tnagyzambo/adc-board/sim/fault/report.md

# GP channel 1: DC fault sweep

1451 cases; 0 did not finish (listed at the end). Generated by report.py from results.json.

## Absolute maximum ratings exceeded

### +28 V, limited to 5 A (a low-impedance source; OI-5)

| Part | Limit | Worst | From | Contacts | Power | Configurations | Sensors | Cases | Worst case |
|---|---|---|---|---|---|---|---|---|---|
| Q3 (S4): body diode current | ≤ 200 mA | 3.16 A | +1 V | EXC-, SIG+, SIG- | ch_off, no24, on, stack_off | i420, i420+S11, lc, lc+S11, lc_cal, lc_cal+S11, off, off+S11, prt, prt+S11, prt_cal, prt_cal+S11, volt, volt+S11 | lc350, none, prt3k5, tx420, txv | 82 | ch_off, off, txv, EXC- +28 V 5A |
| Q3 (S4): dissipation | ±200 mW | 12 W | +1 V | EXC-, SIG+, SIG- | ch_off, no24, on, stack_off | i420, i420+S11, lc, lc+S11, lc_cal, lc_cal+S11, off, off+S11, prt, prt+S11, prt_cal, prt_cal+S11, volt, volt+S11 | lc350, none, prt3k5, tx420, txv | 83 | ch_off, off, txv, EXC- +28 V 5A |
| R3 (shunt): dissipation | ≤ 1 W | 7.4 W | +4 V | SIG+ | no24, on | i420, i420+S11 | tx420 | 3 | on, i420, tx420, SIG+ +28 V 5A |
| U58 (S11): output current | ±400 mA | -5 A | +1 V | SHLD | on | i420+S11, lc+S11, lc_cal+S11, off+S11, prt+S11, prt_cal+S11, volt+S11 | lc350, none, prt3k5, tx420, txv | 17 | on, off, S11 closed, lc350, SHLD +28 V 5A |

### -28 V, limited to 30 mA (beyond REQ-15)

| Part | Limit | Worst | From | Contacts | Power | Configurations | Sensors | Cases | Worst case |
|---|---|---|---|---|---|---|---|---|---|
| Q24: source to drain | ≤ 50 V | 51 V | -28 V | EXC+ | ch_off | off | none, prt3k5, tx420, txv | 4 | ch_off, off, none, EXC+ -28 V 30mA |
| R21: dissipation | ≤ 63 mW | 81.6 mW | -25 V | EXC+ | ch_off, no24, stack_off | i420, off, volt | none, prt3k5, tx420, txv | 12 | no24, volt, none, EXC+ -28 V 30mA |
| U10 (+/-2.5 V LDO): INP | -0.3 V to 36 V | -0.706 V | -3 V | EXC+, EXC-, SIG+, SIG- | ch_off, stack_off | off | lc350, none, prt3k5, tx420, txv | 34 | stack_off, off, none, EXC- -28 V 30mA |
| U10 (+/-2.5 V LDO): OUTP | -0.3 V to 33 V | -0.497 V | -3 V | EXC+, EXC-, SIG+, SIG- | ch_off, stack_off | off | lc350, none, prt3k5, tx420, txv | 34 | stack_off, off, none, EXC- -28 V 30mA |
| U11 (channel eFuse): OUT | -0.3 V to 7 V | -0.706 V | -3 V | EXC+, EXC-, SIG+, SIG- | ch_off, stack_off | off | lc350, none, prt3k5, tx420, txv | 34 | stack_off, off, none, EXC- -28 V 30mA |
| U13 (1.8 V LDO): VIN | -0.3 V to 32 V | -0.706 V | -3 V | EXC+, EXC-, SIG+, SIG- | ch_off, stack_off | off | lc350, none, prt3k5, tx420, txv | 34 | stack_off, off, none, EXC- -28 V 30mA |
| U15: VDD | -0.5 V to 38 V | -0.706 V | -3 V | EXC+, EXC-, SIG+, SIG- | ch_off, stack_off | off | lc350, none, prt3k5, tx420, txv | 34 | stack_off, off, none, EXC- -28 V 30mA |
| U29: VDD | -0.5 V to 38 V | -0.706 V | -3 V | EXC+, EXC-, SIG+, SIG- | ch_off, stack_off | off | lc350, none, prt3k5, tx420, txv | 34 | stack_off, off, none, EXC- -28 V 30mA |
| U3 (S6/S7/S10, LC_G drive): VDD | -0.5 V to 38 V | -0.706 V | -3 V | EXC+, EXC-, SIG+, SIG- | ch_off, stack_off | off | lc350, none, prt3k5, tx420, txv | 34 | stack_off, off, none, EXC- -28 V 30mA |
| U4 (TX_G, S8, S9, S11 drive): VDD | -0.5 V to 38 V | -0.706 V | -3 V | EXC+, EXC-, SIG+, SIG- | ch_off, stack_off | off | lc350, none, prt3k5, tx420, txv | 34 | stack_off, off, none, EXC- -28 V 30mA |
| U5 (reference): VIN | -0.3 V to 18 V | -0.706 V | -3 V | EXC+, EXC-, SIG+, SIG- | ch_off, stack_off | off | lc350, none, prt3k5, tx420, txv | 34 | stack_off, off, none, EXC- -28 V 30mA |
| U5 (reference): VOUT | -0.3 V to 5.5 V | -0.607 V | -1 V | EXC+, EXC-, SIG+, SIG- | ch_off, stack_off | off | lc350, none, prt3k5, tx420, txv | 34 | stack_off, off, none, EXC- -28 V 30mA |
| U53: VIN | -0.3 V to 18 V | -0.706 V | -3 V | EXC+, EXC-, SIG+, SIG- | ch_off, stack_off | off | lc350, none, prt3k5, tx420, txv | 34 | stack_off, off, none, EXC- -28 V 30mA |
| U53: VOUT | -0.3 V to 5.5 V | -0.528 V | -3 V | EXC+, EXC-, SIG+, SIG- | ch_off, stack_off | off | lc350, none, prt3k5, tx420, txv | 34 | stack_off, off, none, EXC- -28 V 30mA |
| U6 (current source): IN to OUT | ±40 V | 51.7 V | -17 V | EXC+, SIG+, SIG- | on | i420, i420+S11, lc, lc+S11, lc_cal, lc_cal+S11, off, off+S11, prt, prt+S11, prt_cal, prt_cal+S11, volt, volt+S11 | none, prt3k5, tx420, txv | 40 | on, off, S11 closed, none, EXC+ -28 V 30mA |
| U6 (current source): IN to SET | ±40 V | 51.7 V | -17 V | EXC+, SIG+, SIG- | on | i420, i420+S11, lc, lc+S11, lc_cal, lc_cal+S11, off, off+S11, prt, prt+S11, prt_cal, prt_cal+S11, volt, volt+S11 | none, prt3k5, tx420, txv | 40 | on, off, S11 closed, none, EXC+ -28 V 30mA |

### -28 V, limited to 5 A (beyond REQ-15)

| Part | Limit | Worst | From | Contacts | Power | Configurations | Sensors | Cases | Worst case |
|---|---|---|---|---|---|---|---|---|---|
| C108: voltage | ±10 V | -26.4 V | -12 V | EXC-, SIG+, SIG- | ch_off, no24, on, stack_off | lc, lc+S11, lc_cal, lc_cal+S11, off, off+S11, prt, prt+S11, prt_cal, prt_cal+S11 | lc350, none, prt3k5, tx420, txv | 61 | no24, prt_cal, prt3k5, EXC- -28 V 5A |
| C111: voltage | ±10 V | -23.9 V | -15 V | EXC-, SIG+, SIG- | ch_off, no24, on, stack_off | lc, lc+S11, lc_cal, lc_cal+S11, off, off+S11, prt, prt+S11, prt_cal, prt_cal+S11 | lc350, none, prt3k5, tx420, txv | 63 | no24, prt_cal, prt3k5, EXC- -28 V 5A |
| C173: voltage | ±10 V | -22.4 V | -16 V | EXC-, SIG+, SIG- | ch_off, no24, on, stack_off | lc, lc+S11, lc_cal, lc_cal+S11, off, off+S11, prt, prt+S11, prt_cal, prt_cal+S11 | lc350, none, prt3k5, tx420, txv | 61 | ch_off, off, lc350, EXC- -28 V 5A |
| C20: voltage | ±10 V | -26.4 V | -12 V | EXC-, SIG+, SIG- | ch_off, no24, on, stack_off | lc, lc+S11, lc_cal, lc_cal+S11, off, off+S11, prt, prt+S11, prt_cal, prt_cal+S11 | lc350, none, prt3k5, tx420, txv | 61 | no24, prt_cal, prt3k5, EXC- -28 V 5A |
| C21: voltage | ±25 V | -25.8 V | -28 V | EXC- | on | lc_cal, lc_cal+S11 | none | 2 | on, lc_cal, S11 closed, none, EXC- -28 V 5A |
| C23: voltage | ±10 V | -23.9 V | -15 V | EXC-, SIG+, SIG- | ch_off, no24, on, stack_off | lc, lc+S11, lc_cal, lc_cal+S11, off, off+S11, prt, prt+S11, prt_cal, prt_cal+S11 | lc350, none, prt3k5, tx420, txv | 63 | no24, prt_cal, prt3k5, EXC- -28 V 5A |
| C40: voltage | ±25 V | -27.2 V | -26 V | EXC-, SIG- | ch_off, no24, on, stack_off | lc, lc+S11, lc_cal, lc_cal+S11, off, off+S11, prt, prt+S11, prt_cal, prt_cal+S11 | lc350, none, prt3k5, tx420, txv | 59 | ch_off, off, none, EXC- -28 V 5A |
| Q14: gate to source | ±20 V | -26.3 V | -22 V | EXC-, SIG- | ch_off, no24, on, stack_off | lc, lc+S11, lc_cal, lc_cal+S11, off, off+S11, prt, prt+S11, prt_cal, prt_cal+S11 | lc350, none, prt3k5, tx420, txv | 59 | ch_off, off, none, EXC- -28 V 5A |
| Q23: gate to source | ±20 V | -26.7 V | -22 V | EXC-, SIG- | ch_off, no24, on, stack_off | lc, lc+S11, lc_cal, lc_cal+S11, off, off+S11, prt, prt+S11, prt_cal, prt_cal+S11 | lc350, none, prt3k5, tx420, txv | 43 | ch_off, off, none, EXC- -28 V 5A |
| Q24: source to drain | ≤ 50 V | 51 V | -28 V | EXC+, EXC-, SIG+, SIG- | ch_off | off | lc350, none, prt3k5, tx420, txv | 9 | ch_off, off, none, EXC+ -28 V 5A |
| Q3 (S4): dissipation | ±200 mW | 33.5 W | -1 V | EXC-, SIG+, SIG- | no24, on | i420, i420+S11, off, off+S11, volt, volt+S11 | lc350, none, prt3k5, tx420, txv | 45 | on, volt, S11 closed, none, EXC- -28 V 5A |
| Q3 (S4): drain current | ≤ 200 mA | 4.64 A | -1 V | EXC-, SIG+, SIG- | no24, on | i420, i420+S11, volt, volt+S11 | none, tx420, txv | 24 | no24, i420, none, EXC- -28 V 5A |
| Q4 (S3): gate to source | ±20 V | 32.9 V | -16 V | EXC- | no24, on | lc, lc+S11, lc_cal, lc_cal+S11 | lc350, none | 12 | on, lc_cal, none, EXC- -28 V 5A |
| Q5 (S5): gate to source | ±20 V | 28.7 V | -20 V | EXC-, SIG- | ch_off, no24, on, stack_off | lc, lc+S11, lc_cal, lc_cal+S11, off, off+S11 | lc350, none, tx420 | 21 | no24, lc_cal, lc350, EXC- -28 V 5A |
| R20: dissipation | ≤ 63 mW | 96.7 mW | -8 V | EXC- | no24, on | prt, prt+S11 | none | 3 | no24, prt, none, EXC- -28 V 5A |
| R21: dissipation | ≤ 63 mW | 81.6 mW | -25 V | EXC+, SIG+ | ch_off, no24, on, stack_off | i420, i420+S11, off, volt, volt+S11 | none, prt3k5, tx420, txv | 21 | no24, volt, none, EXC+ -28 V 5A |
| R224: dissipation | ≤ 63 mW | 289 mW | -12 V | EXC- | no24, on | lc, lc+S11, lc_cal, lc_cal+S11 | lc350, none | 12 | on, lc_cal, none, EXC- -28 V 5A |
| R226: dissipation | ≤ 63 mW | 289 mW | -12 V | EXC- | no24, on | lc, lc+S11, lc_cal, lc_cal+S11 | lc350, none | 12 | on, lc_cal, none, EXC- -28 V 5A |
| R3 (shunt): dissipation | ≤ 1 W | 7.37 W | -4 V | SIG+ | ch_off, no24, on, stack_off | i420, i420+S11, off, off+S11, volt, volt+S11 | tx420, txv | 14 | no24, i420, tx420, SIG+ -28 V 5A |
| R36: dissipation | ≤ 63 mW | 87.8 mW | -9 V | EXC-, SIG- | ch_off, no24, on, stack_off | lc_cal, lc_cal+S11, off, off+S11 | none, tx420 | 13 | stack_off, off, tx420, SIG- -28 V 5A |
| R37: dissipation | ≤ 63 mW | 372 mW | -7 V | EXC-, SIG- | ch_off, no24, on, stack_off | lc, lc+S11, lc_cal, lc_cal+S11, off, off+S11, prt, prt+S11 | lc350, none, prt3k5, tx420 | 32 | on, lc, S11 closed, none, EXC- -28 V 5A |
| R41: dissipation | ≤ 63 mW | 184 mW | -15 V | EXC-, SIG+, SIG- | ch_off, no24, on, stack_off | lc, lc+S11, lc_cal, lc_cal+S11, off, off+S11, prt, prt+S11, prt_cal, prt_cal+S11 | lc350, none, prt3k5, tx420, txv | 61 | ch_off, off, none, EXC- -28 V 5A |
| R42: dissipation | ≤ 63 mW | 184 mW | -17 V | EXC-, SIG+, SIG- | ch_off, no24, on, stack_off | lc, lc+S11, lc_cal, lc_cal+S11, off, off+S11, prt, prt+S11, prt_cal, prt_cal+S11 | lc350, none, prt3k5, tx420, txv | 61 | ch_off, off, none, EXC- -28 V 5A |
| U10 (+/-2.5 V LDO): INP | -0.3 V to 36 V | -0.79 V | -3 V | EXC+, EXC-, SIG+, SIG- | ch_off, stack_off | off | lc350, none, prt3k5, tx420, txv | 34 | stack_off, off, lc350, EXC- -28 V 5A |
| U10 (+/-2.5 V LDO): OUTP | -0.3 V to 33 V | -0.679 V | -3 V | EXC+, EXC-, SIG+, SIG- | ch_off, stack_off | off | lc350, none, prt3k5, tx420, txv | 34 | ch_off, off, tx420, EXC- -28 V 5A |
| U11 (channel eFuse): OUT | -0.3 V to 7 V | -0.79 V | -3 V | EXC+, EXC-, SIG+, SIG- | ch_off, stack_off | off | lc350, none, prt3k5, tx420, txv | 34 | stack_off, off, lc350, EXC- -28 V 5A |
| U12 (-5 V pump): GND to VOUT | ≤ 6 V | 27.2 V | -7 V | EXC-, SIG+, SIG- | ch_off, no24, on, stack_off | lc, lc+S11, lc_cal, lc_cal+S11, off, off+S11, prt, prt+S11, prt_cal, prt_cal+S11 | lc350, none, prt3k5, tx420, txv | 70 | ch_off, off, none, EXC- -28 V 5A |
| U13 (1.8 V LDO): VIN | -0.3 V to 32 V | -0.79 V | -3 V | EXC+, EXC-, SIG+, SIG- | ch_off, stack_off | off | lc350, none, prt3k5, tx420, txv | 34 | stack_off, off, lc350, EXC- -28 V 5A |
| U15: VDD | -0.5 V to 38 V | -0.79 V | -3 V | EXC+, EXC-, SIG+, SIG- | ch_off, stack_off | off | lc350, none, prt3k5, tx420, txv | 34 | stack_off, off, lc350, EXC- -28 V 5A |
| U29: VDD | -0.5 V to 38 V | -0.79 V | -3 V | EXC+, EXC-, SIG+, SIG- | ch_off, stack_off | off | lc350, none, prt3k5, tx420, txv | 34 | stack_off, off, lc350, EXC- -28 V 5A |
| U3 (S6/S7/S10, LC_G drive): D1 clamp current | ±30 mA | -40.5 mA | -8 V | EXC- | no24, on | prt, prt+S11, prt_cal, prt_cal+S11 | none, prt3k5 | 12 | no24, prt, prt3k5, EXC- -28 V 5A |
| U3 (S6/S7/S10, LC_G drive): D2 clamp current | ±30 mA | -40.5 mA | -8 V | EXC- | no24, on | prt, prt+S11, prt_cal, prt_cal+S11 | none, prt3k5 | 12 | no24, prt, prt3k5, EXC- -28 V 5A |
| U3 (S6/S7/S10, LC_G drive): D3 clamp current | ±30 mA | -56.6 mA | -7 V | EXC- | no24, on | lc_cal, lc_cal+S11, prt_cal, prt_cal+S11 | lc350, none, prt3k5 | 12 | no24, prt_cal, prt3k5, EXC- -28 V 5A |
| U3 (S6/S7/S10, LC_G drive): S1 clamp current | ±30 mA | -160 mA | -6 V | EXC-, SIG+, SIG- | no24, on | i420, i420+S11, lc, lc+S11, lc_cal, lc_cal+S11, off, off+S11, prt, prt+S11, prt_cal, prt_cal+S11, volt, volt+S11 | lc350, none, prt3k5, tx420, txv | 69 | no24, off, prt3k5, EXC- -28 V 5A |
| U3 (S6/S7/S10, LC_G drive): S3 clamp current | ±30 mA | -160 mA | -6 V | EXC-, SIG+, SIG- | no24, on | i420, i420+S11, lc, lc+S11, lc_cal, lc_cal+S11, off, off+S11, prt, prt+S11, prt_cal, prt_cal+S11, volt, volt+S11 | lc350, none, prt3k5, tx420, txv | 69 | no24, off, prt3k5, EXC- -28 V 5A |
| U3 (S6/S7/S10, LC_G drive): VDD | -0.5 V to 38 V | -0.79 V | -3 V | EXC+, EXC-, SIG+, SIG- | ch_off, stack_off | off | lc350, none, prt3k5, tx420, txv | 34 | stack_off, off, lc350, EXC- -28 V 5A |
| U37: input clamp current, B +IN | ±10 mA | 13.5 mA | -5 V | EXC-, SIG+, SIG- | ch_off, stack_off | off | lc350, none, prt3k5, tx420, txv | 22 | stack_off, off, lc350, EXC- -28 V 5A |
| U4 (TX_G, S8, S9, S11 drive): VDD | -0.5 V to 38 V | -0.79 V | -3 V | EXC+, EXC-, SIG+, SIG- | ch_off, stack_off | off | lc350, none, prt3k5, tx420, txv | 34 | stack_off, off, lc350, EXC- -28 V 5A |
| U45: AVDD1 to AVSS | -0.3 V to 6.5 V | 26.4 V | -9 V | EXC-, SIG+, SIG- | ch_off, no24, on, stack_off | lc, lc+S11, lc_cal, lc_cal+S11, off, off+S11, prt, prt+S11, prt_cal, prt_cal+S11 | lc350, none, prt3k5, tx420, txv | 63 | no24, prt_cal, prt3k5, EXC- -28 V 5A |
| U45: AVDD2 to AVSS | -0.3 V to 6.5 V | 23.9 V | -11 V | EXC-, SIG+, SIG- | ch_off, no24, on, stack_off | lc, lc+S11, lc_cal, lc_cal+S11, off, off+S11, prt, prt+S11, prt_cal, prt_cal+S11 | lc350, none, prt3k5, tx420, txv | 63 | no24, prt_cal, prt3k5, EXC- -28 V 5A |
| U45: AVSS to DGND | -3 V to 0.3 V | -23.9 V | -7 V | EXC-, SIG+, SIG- | ch_off, no24, on, stack_off | lc, lc+S11, lc_cal, lc_cal+S11, off, off+S11, prt, prt+S11, prt_cal, prt_cal+S11 | lc350, none, prt3k5, tx420, txv | 67 | no24, prt_cal, prt3k5, EXC- -28 V 5A |
| U5 (reference): VIN | -0.3 V to 18 V | -0.79 V | -3 V | EXC+, EXC-, SIG+, SIG- | ch_off, stack_off | off | lc350, none, prt3k5, tx420, txv | 34 | stack_off, off, lc350, EXC- -28 V 5A |
| U5 (reference): VOUT | -0.3 V to 5.5 V | -0.669 V | -1 V | EXC+, EXC-, SIG+, SIG- | ch_off, stack_off | off | lc350, none, prt3k5, tx420, txv | 34 | ch_off, off, lc350, EXC- -28 V 5A |
| U53: VIN | -0.3 V to 18 V | -0.79 V | -3 V | EXC+, EXC-, SIG+, SIG- | ch_off, stack_off | off | lc350, none, prt3k5, tx420, txv | 34 | stack_off, off, lc350, EXC- -28 V 5A |
| U53: VOUT | -0.3 V to 5.5 V | -0.545 V | -3 V | EXC+, EXC-, SIG+, SIG- | ch_off, stack_off | off | lc350, none, prt3k5, tx420, txv | 34 | stack_off, off, none, EXC- -28 V 5A |
| U58 (S11): output current | ±400 mA | 5 A | -1 V | SHLD | on | i420+S11, lc+S11, lc_cal+S11, off+S11, prt+S11, prt_cal+S11, volt+S11 | lc350, none, prt3k5, tx420, txv | 17 | on, off, S11 closed, txv, SHLD -28 V 5A |
| U6 (current source): IN to OUT | ±40 V | 51.7 V | -17 V | EXC+, EXC-, SIG+, SIG- | on | i420, i420+S11, lc, lc+S11, lc_cal, lc_cal+S11, off, off+S11, prt, prt+S11, prt_cal, prt_cal+S11, volt, volt+S11 | lc350, none, prt3k5, tx420, txv | 76 | on, off, none, EXC+ -28 V 5A |
| U6 (current source): IN to SET | ±40 V | 51.7 V | -17 V | EXC+, EXC-, SIG+, SIG- | on | i420, i420+S11, lc, lc+S11, lc_cal, lc_cal+S11, off, off+S11, prt, prt+S11, prt_cal, prt_cal+S11, volt, volt+S11 | lc350, none, prt3k5, tx420, txv | 76 | on, off, none, EXC+ -28 V 5A |
| U7 (bus amplifiers): input clamp current, B +IN | ±10 mA | 13.5 mA | -5 V | EXC-, SIG+, SIG- | ch_off, stack_off | off | lc350, none, prt3k5, tx420, txv | 22 | stack_off, off, lc350, EXC- -28 V 5A |
| U9 (converter): AINN0 clamp current | ±10 mA | -19.2 mA | -6 V | EXC-, SIG+, SIG- | ch_off, no24, on, stack_off | i420, i420+S11, lc, lc+S11, lc_cal, lc_cal+S11, off, off+S11, prt_cal, prt_cal+S11, volt, volt+S11 | lc350, none, prt3k5, tx420, txv | 61 | stack_off, off, tx420, SIG- -28 V 5A |
| U9 (converter): AINP0 clamp current | ±10 mA | -12.7 mA | -7 V | EXC-, SIG+, SIG- | ch_off, no24, on, stack_off | i420, lc, lc+S11, lc_cal, lc_cal+S11, off, off+S11, volt, volt+S11 | lc350, prt3k5, tx420, txv | 39 | ch_off, off, prt3k5, EXC- -28 V 5A |
| U9 (converter): AVDD1 to AVSS | -0.3 V to 6.5 V | 26.4 V | -9 V | EXC-, SIG+, SIG- | ch_off, no24, on, stack_off | lc, lc+S11, lc_cal, lc_cal+S11, off, off+S11, prt, prt+S11, prt_cal, prt_cal+S11 | lc350, none, prt3k5, tx420, txv | 63 | no24, prt_cal, prt3k5, EXC- -28 V 5A |
| U9 (converter): AVDD2 to AVSS | -0.3 V to 6.5 V | 23.9 V | -11 V | EXC-, SIG+, SIG- | ch_off, no24, on, stack_off | lc, lc+S11, lc_cal, lc_cal+S11, off, off+S11, prt, prt+S11, prt_cal, prt_cal+S11 | lc350, none, prt3k5, tx420, txv | 63 | no24, prt_cal, prt3k5, EXC- -28 V 5A |
| U9 (converter): AVSS to DGND | -3 V to 0.3 V | -23.9 V | -7 V | EXC-, SIG+, SIG- | ch_off, no24, on, stack_off | lc, lc+S11, lc_cal, lc_cal+S11, off, off+S11, prt, prt+S11, prt_cal, prt_cal+S11 | lc350, none, prt3k5, tx420, txv | 67 | no24, prt_cal, prt3k5, EXC- -28 V 5A |
| U9 (converter): REFN clamp current | ±10 mA | -39.6 mA | -6 V | EXC-, SIG+, SIG- | ch_off, no24, on, stack_off | i420, i420+S11, lc, lc+S11, lc_cal, lc_cal+S11, off, off+S11, prt, prt+S11, prt_cal, prt_cal+S11, volt, volt+S11 | lc350, none, prt3k5, tx420, txv | 99 | on, lc, S11 closed, none, EXC- -28 V 5A |
| U9 (converter): REFP clamp current | ±10 mA | -20.2 mA | -6 V | EXC- | no24, on | prt, prt+S11, prt_cal, prt_cal+S11 | none, prt3k5 | 12 | no24, prt, none, EXC- -28 V 5A |

## Protection acting

## Rails out of regulation or back-powered

### +28 V, limited to 30 mA (REQ-15 against a current-limited source)

| Part | Limit | Worst | From | Contacts | Power | Configurations | Sensors | Cases | Worst case |
|---|---|---|---|---|---|---|---|---|---|
| rail: +1V8_CH back-powered while off | ±0.5 V | 1.04 V | +3 V | EXC+, SIG+, SIG- | ch_off, stack_off | off | lc350, none, prt3k5, tx420, txv | 24 | ch_off, off, prt3k5, SIG- +28 V 30mA |
| rail: +2V5_CH back-powered while off | ±0.5 V | 1.67 V | +3 V | EXC+, SIG+, SIG- | ch_off, stack_off | off | lc350, none, prt3k5, tx420, txv | 22 | stack_off, off, prt3k5, SIG- +28 V 30mA |
| rail: +5V_CH back-powered while off | ±0.5 V | 2.18 V | +1 V | EXC+, SIG+, SIG- | ch_off, stack_off | off | lc350, none, prt3k5, tx420, txv | 26 | ch_off, off, prt3k5, SIG- +28 V 30mA |
| rail: -5V_CH back-powered while off | ±0.5 V | -0.633 V | +12 V | SIG- | ch_off, stack_off | off | none, prt3k5 | 4 | ch_off, off, none, SIG- +28 V 30mA |

### +28 V, limited to 5 A (a low-impedance source; OI-5)

| Part | Limit | Worst | From | Contacts | Power | Configurations | Sensors | Cases | Worst case |
|---|---|---|---|---|---|---|---|---|---|
| rail: +1V8_CH back-powered while off | ±0.5 V | 1.04 V | +2 V | EXC+, EXC-, SIG+, SIG- | ch_off, stack_off | off | lc350, none, prt3k5, tx420, txv | 38 | ch_off, off, prt3k5, SIG- +28 V 5A |
| rail: +2V5_CH back-powered while off | ±0.5 V | 1.68 V | +2 V | EXC+, EXC-, SIG+, SIG- | ch_off, stack_off | off | lc350, none, prt3k5, tx420, txv | 38 | ch_off, off, none, EXC- +28 V 5A |
| rail: +5V_CH back-powered while off | ±0.5 V | 2.18 V | +1 V | EXC+, EXC-, SIG+, SIG- | ch_off, stack_off | off | lc350, none, prt3k5, tx420, txv | 40 | ch_off, off, prt3k5, SIG- +28 V 5A |
| rail: -5V_CH back-powered while off | ±0.5 V | -0.633 V | +12 V | SIG- | ch_off, stack_off | off | lc350, none, prt3k5 | 6 | ch_off, off, none, SIG- +28 V 5A |

### -28 V, limited to 30 mA (beyond REQ-15)

| Part | Limit | Worst | From | Contacts | Power | Configurations | Sensors | Cases | Worst case |
|---|---|---|---|---|---|---|---|---|---|
| rail: +5V_CH back-powered while off | ±0.5 V | -0.706 V | -3 V | EXC+, EXC-, SIG+, SIG- | ch_off, stack_off | off | lc350, none, prt3k5, tx420, txv | 34 | stack_off, off, none, EXC- -28 V 30mA |
| rail: -2V5_CH back-powered while off | ±0.5 V | -1.61 V | -1 V | EXC+, EXC-, SIG+, SIG- | ch_off, stack_off | off | lc350, none, prt3k5, tx420, txv | 40 | ch_off, off, lc350, EXC+ -28 V 30mA |
| rail: -5V_CH back-powered while off | ±0.5 V | -3.55 V | -1 V | EXC+, EXC-, SIG+, SIG- | ch_off, stack_off | off | lc350, none, prt3k5, tx420, txv | 40 | stack_off, off, none, EXC- -28 V 30mA |

### -28 V, limited to 5 A (beyond REQ-15)

| Part | Limit | Worst | From | Contacts | Power | Configurations | Sensors | Cases | Worst case |
|---|---|---|---|---|---|---|---|---|---|
| rail: +2V5_CH back-powered while off | ±0.5 V | -0.679 V | -5 V | EXC+, EXC-, SIG+, SIG- | ch_off, stack_off | off | lc350, none, prt3k5, tx420, txv | 24 | ch_off, off, tx420, EXC- -28 V 5A |
| rail: +5V_CH back-powered while off | ±0.5 V | -0.79 V | -3 V | EXC+, EXC-, SIG+, SIG- | ch_off, stack_off | off | lc350, none, prt3k5, tx420, txv | 34 | stack_off, off, lc350, EXC- -28 V 5A |
| rail: -2V5_CH back-powered while off | ±0.5 V | -23.2 V | -1 V | EXC+, EXC-, SIG+, SIG- | ch_off, stack_off | off | lc350, none, prt3k5, tx420, txv | 40 | ch_off, off, lc350, EXC- -28 V 5A |
| rail: -2V5_CH out of regulation (nominal -2.5 V) | -2.75 V to -2.25 V | -23.9 V | -7 V | EXC-, SIG- | no24, on | lc, lc+S11, lc_cal, lc_cal+S11, off, off+S11, prt, prt+S11, prt_cal, prt_cal+S11 | lc350, none, prt3k5, tx420, txv | 45 | no24, prt_cal, prt3k5, EXC- -28 V 5A |
| rail: -5V_CH back-powered while off | ±0.5 V | -27.2 V | -1 V | EXC+, EXC-, SIG+, SIG- | ch_off, stack_off | off | lc350, none, prt3k5, tx420, txv | 40 | ch_off, off, none, EXC- -28 V 5A |
| rail: -5V_CH out of regulation (nominal -4.7 V) | -5.3 V to -4.2 V | -26.7 V | -7 V | EXC-, SIG+, SIG- | no24, on | i420, i420+S11, lc, lc+S11, lc_cal, lc_cal+S11, off, off+S11, prt, prt+S11, prt_cal, prt_cal+S11, volt, volt+S11 | lc350, none, prt3k5, tx420, txv | 66 | on, lc_cal, S11 closed, none, EXC- -28 V 5A |
