tnagyzambo/adc-board/e003-adc-board.pdf

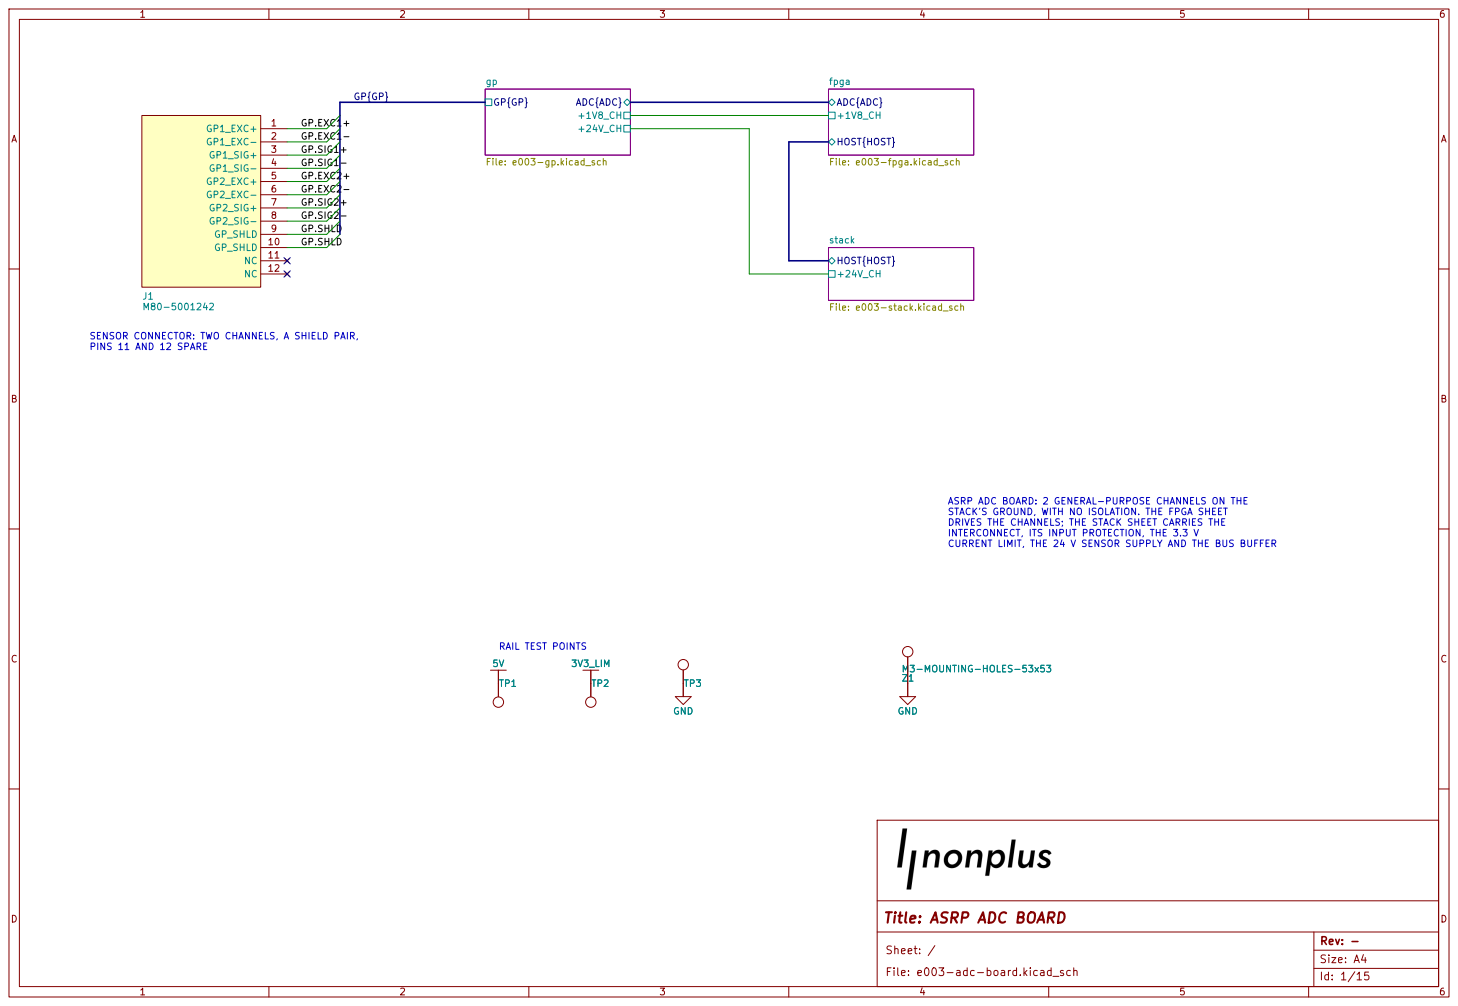
[picture p1: page 1]

ASRP ADC BOARD: 2 GENERAL-PURPOSE CHANNELS ON THE STACK'S GROUND, WITH NO ISOLATION. THE FPGA SHEET DRIVES THE CHANNELS; THE STACK SHEET CARRIES THE

INTERCONNECT, ITS INPUT PROTECTION, THE 3.3 V CURRENT LIMIT, THE 24 V SENSOR SUPPLY AND THE BUS BUFFER

Title: ASRP ADC BOARD

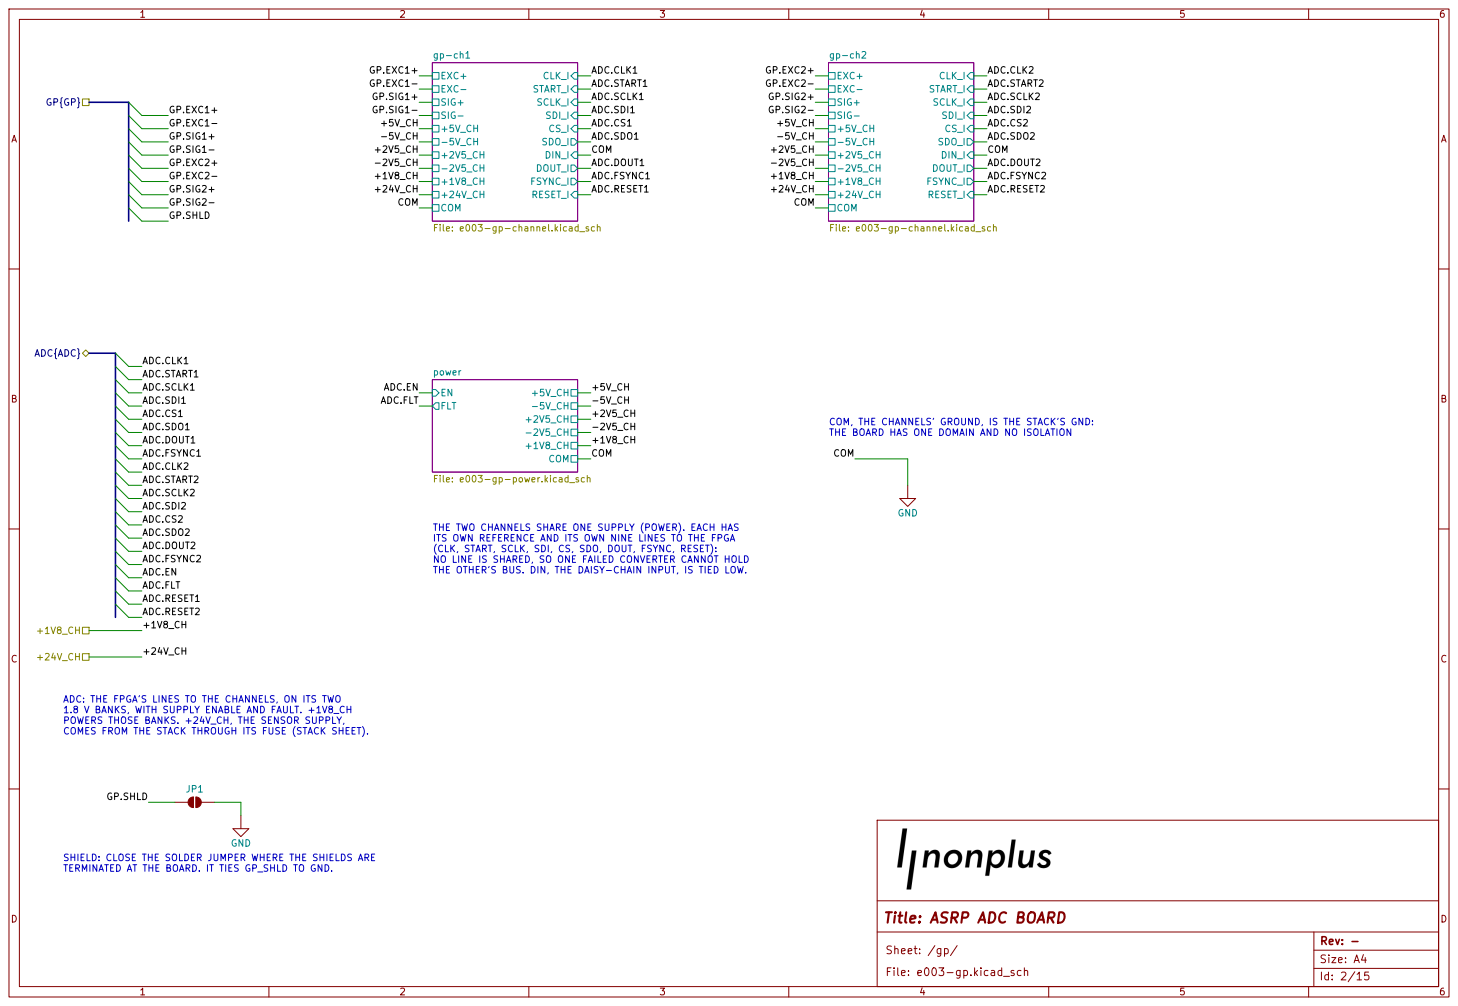
[picture p2: page 2]

power File: e003-gp-power.kicad_sch GND

COM, THE CHANNELS' GROUND, IS THE STACK'S GND: THE BOARD HAS ONE DOMAIN AND NO ISOLATION

THE TWO CHANNELS SHARE ONE SUPPLY (POWER). EACH HAS
ITS OWN REFERENCE AND ITS OWN NINE LINES TO THE FPGA
(CLK, START, SCLK, SDI, CS, SDO, DOUT, FSYNC, RESET): NO LINE IS SHARED, SO ONE FAILED CONVERTER CANNOT HOLD

THE OTHER'S BUS. DIN, THE DAISY-CHAIN INPUT, IS TIED LOW.

TERMINATED AT THE BOARD. IT TIES GP_SHLD TO GND. ADC: THE FPGA'S LINES TO THE CHANNELS, ON ITS TWO
1.8 V BANKS, WITH SUPPLY ENABLE AND FAULT. +1V8_CH
POWERS THOSE BANKS. +24V_CH, THE SENSOR SUPPLY, COMES FROM THE STACK THROUGH ITS FUSE (STACK SHEET).

SHIELD: CLOSE THE SOLDER JUMPER WHERE THE SHIELDS ARE

Title: ASRP ADC BOARD

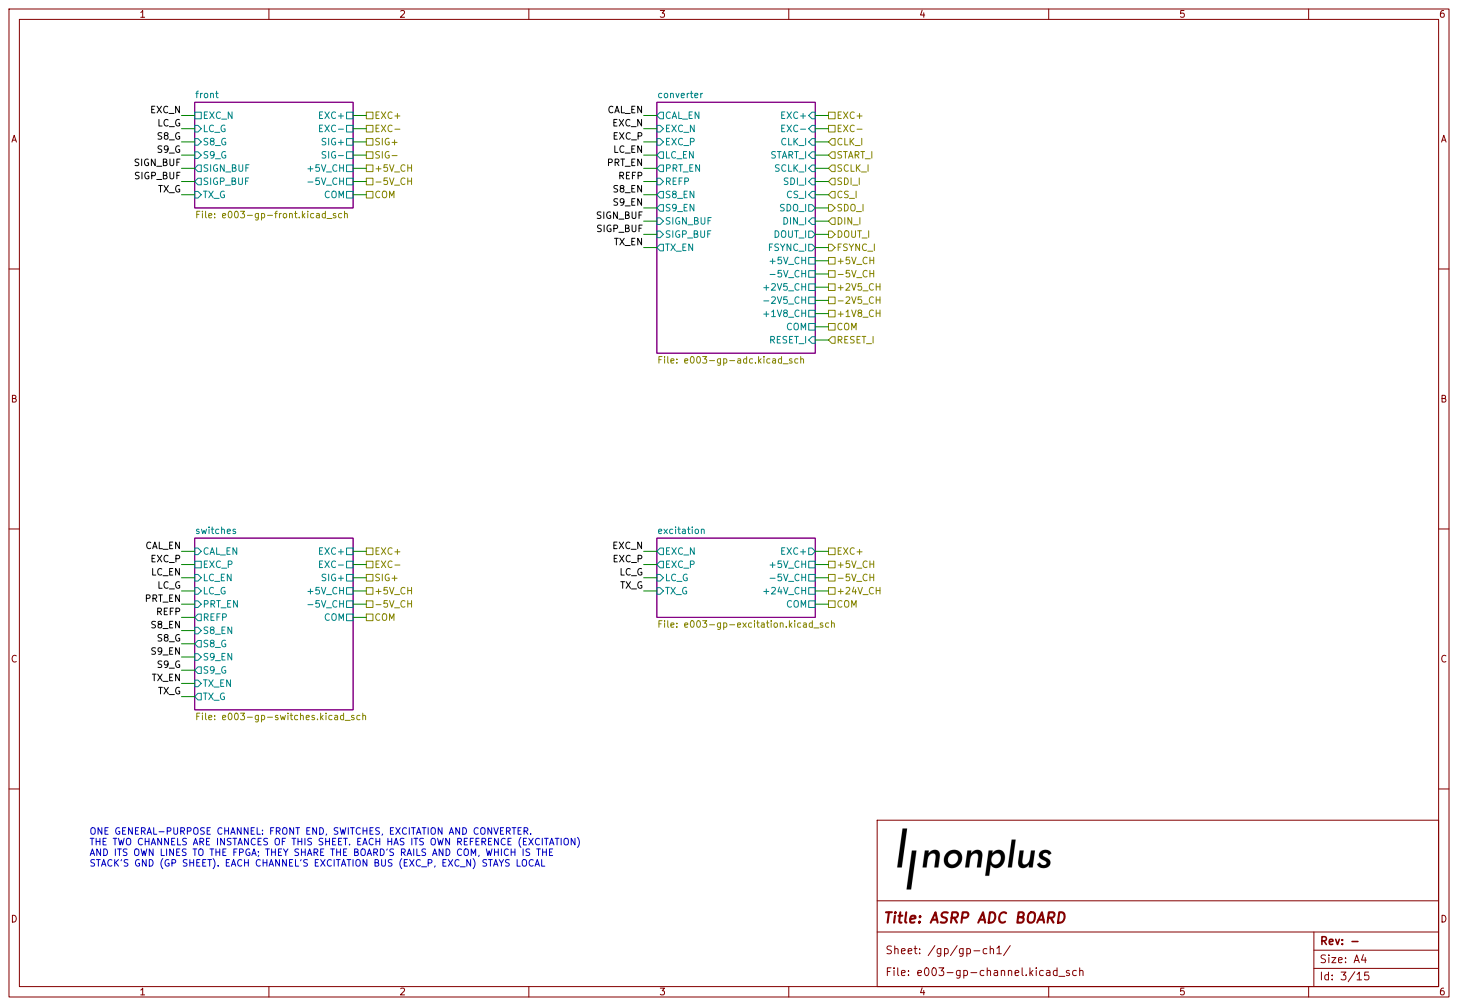
[picture p3: page 3]

RESET_I converter File: e003-gp-adc.kicad_sch CAL_EN

switches File: e003-gp-switches.kicad_sch

ONE GENERAL-PURPOSE CHANNEL: FRONT END, SWITCHES, EXCITATION AND CONVERTER. THE TWO CHANNELS ARE INSTANCES OF THIS SHEET. EACH HAS ITS OWN REFERENCE (EXCITATION) AND ITS OWN LINES TO THE FPGA; THEY SHARE THE BOARD'S RAILS AND COM, WHICH IS THE STACK'S GND (GP SHEET). EACH CHANNEL'S EXCITATION BUS (EXC_P, EXC_N) STAYS LOCAL

Title: ASRP ADC BOARD

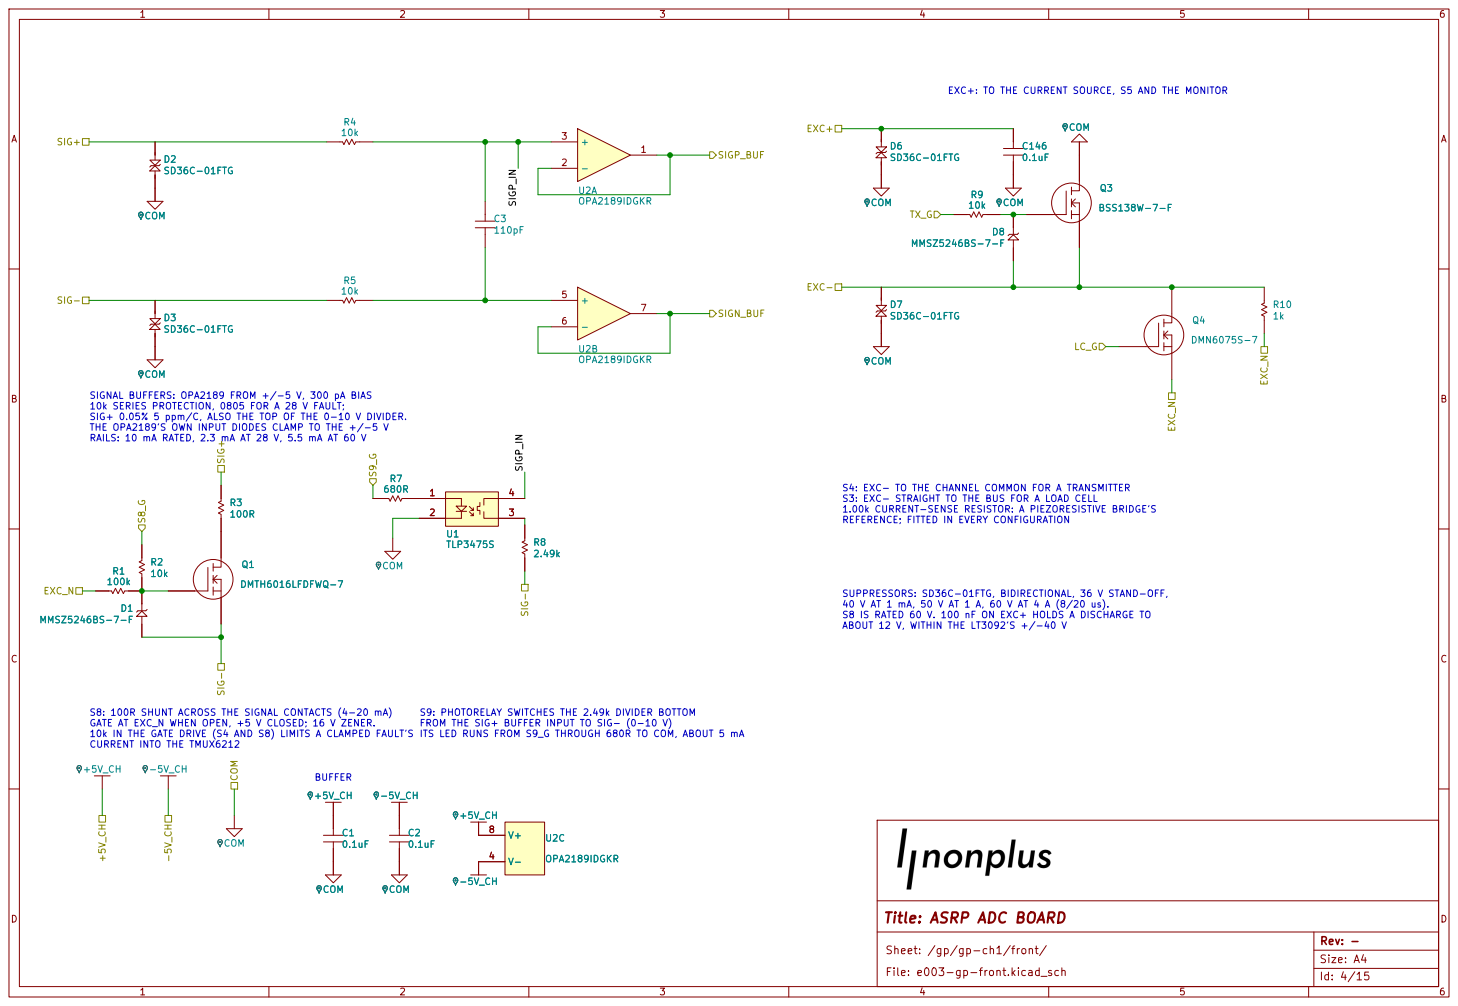
[picture p4: page 4]

EXC+: TO THE CURRENT SOURCE, S5 AND THE MONITOR
7 U2B OPA2189IDGKR +5V_CH

SIGNAL BUFFERS: OPA2189 FROM +/-5 V, 300 pA BIAS
10k SERIES PROTECTION, 0805 FOR A 28 V FAULT; SIG+ 0.05% 5 ppm/C, ALSO THE TOP OF THE 0-10 V DIVIDER. THE OPA2189'S OWN INPUT DIODES CLAMP TO THE +/-5 V RAILS: 10 mA RATED, 2.3 mA AT 28 V, 5.5 mA AT 60 V R3

S4: EXC- TO THE CHANNEL COMMON FOR A TRANSMITTER
S3: EXC- STRAIGHT TO THE BUS FOR A LOAD CELL 1.00k CURRENT-SENSE RESISTOR: A PIEZORESISTIVE BRIDGE'S REFERENCE; FITTED IN EVERY CONFIGURATION

S9: PHOTORELAY SWITCHES THE 2.49k DIVIDER BOTTOM
FROM THE SIG+ BUFFER INPUT TO SIG- (0-10 V)
COM -5V_CH

Title: ASRP ADC BOARD

Sheet: /gp/gp-ch1/front/
File: e003-gp-front.kicad_sch

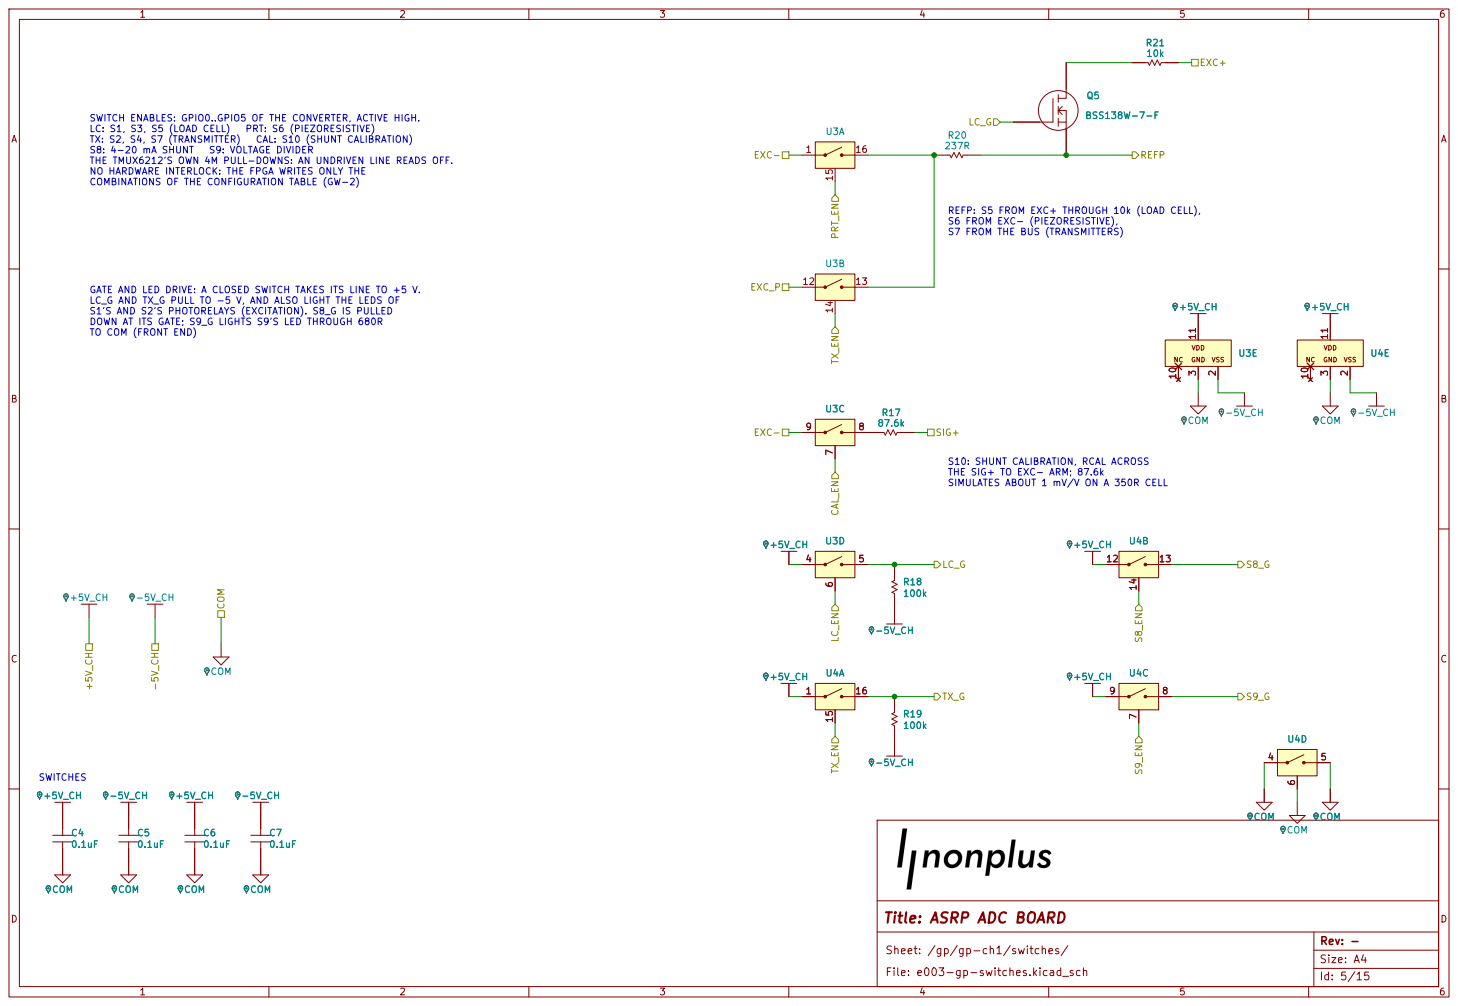
[picture p5: page 5]

THE TMUX6212'S OWN 4M PULL-DOWNS: AN UNDRIVEN LINE READS OFF. NO HARDWARE INTERLOCK: THE FPGA WRITES ONLY THE COMBINATIONS OF THE CONFIGURATION TABLE (GW-2) GATE AND LED DRIVE: A CLOSED SWITCH TAKES ITS LINE TO +5 V. LC_G AND TX_G PULL TO -5 V, AND ALSO LIGHT THE LEDS OF S1'S AND S2'S PHOTORELAYS (EXCITATION). S8_G IS PULLED

THE SIG+ TO EXC- ARM; 87.6k SIMULATES ABOUT 1 mV/V ON A 350R CELL REFP: S5 FROM EXC+ THROUGH 10k (LOAD CELL), S6 FROM EXC- (PIEZORESISTIVE), S7 FROM THE BUS (TRANSMITTERS) SWITCHES

DOWN AT ITS GATE; S9_G LIGHTS S9'S LED THROUGH 680R

S10: SHUNT CALIBRATION, RCAL ACROSS

Title: ASRP ADC BOARD

Sheet: /gp/gp-ch1/switches/
File: e003-gp-switches.kicad_sch

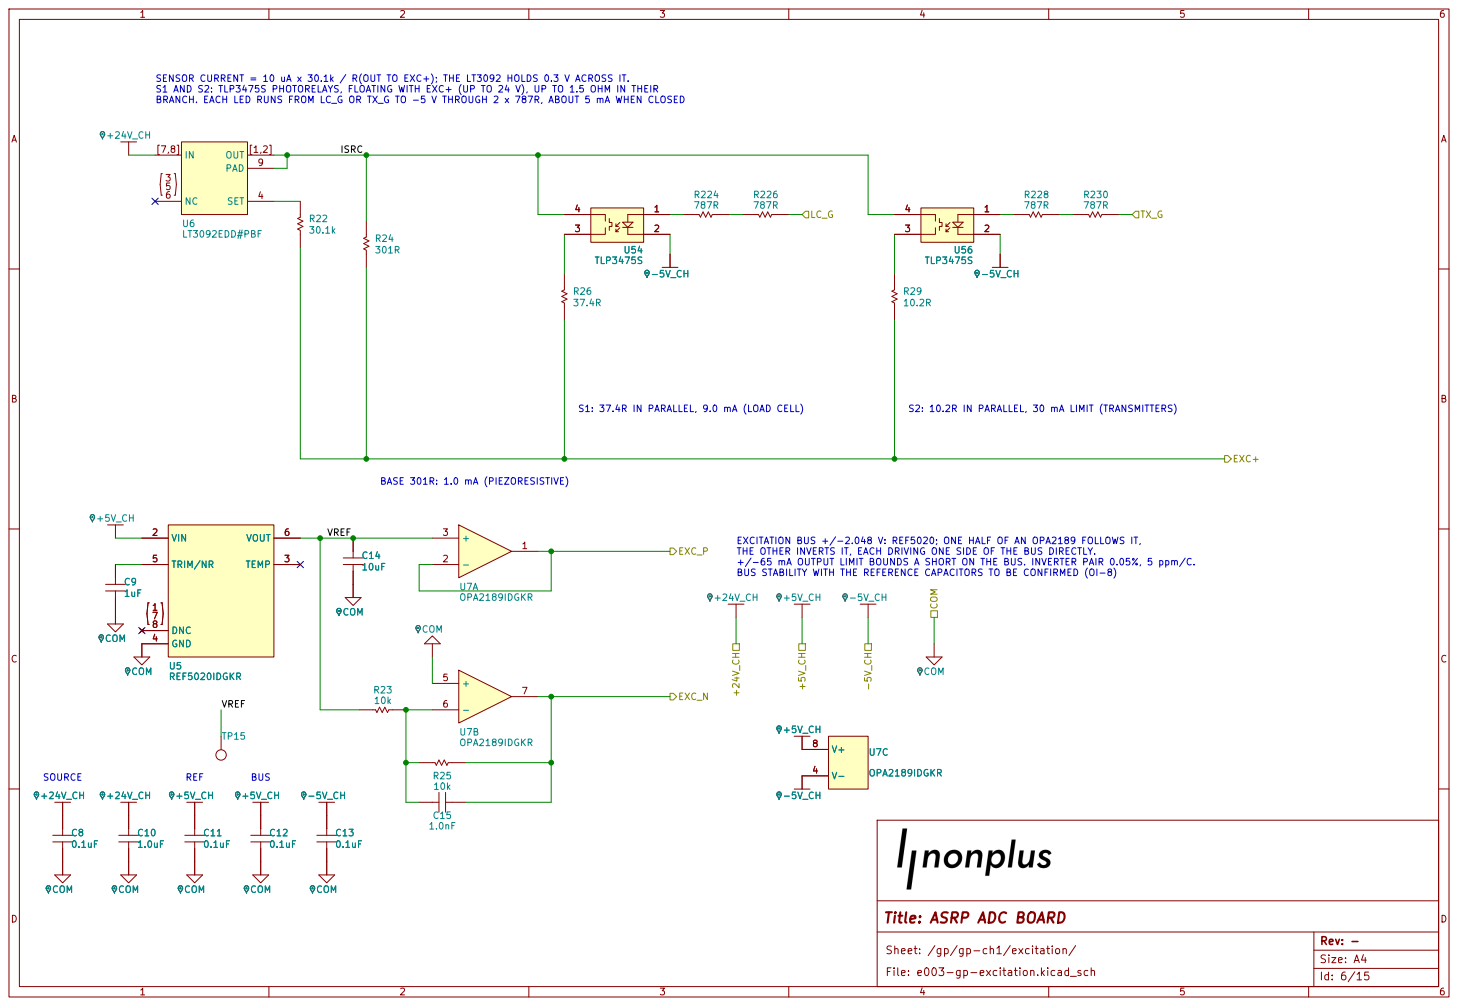
[picture p6: page 6]

BRANCH. EACH LED RUNS FROM LC_G OR TX_G TO -5 V THROUGH 2 x 787R, ABOUT 5 mA WHEN CLOSED

Title: ASRP ADC BOARD

Sheet: /gp/gp-ch1/excitation/
File: e003-gp-excitation.kicad_sch

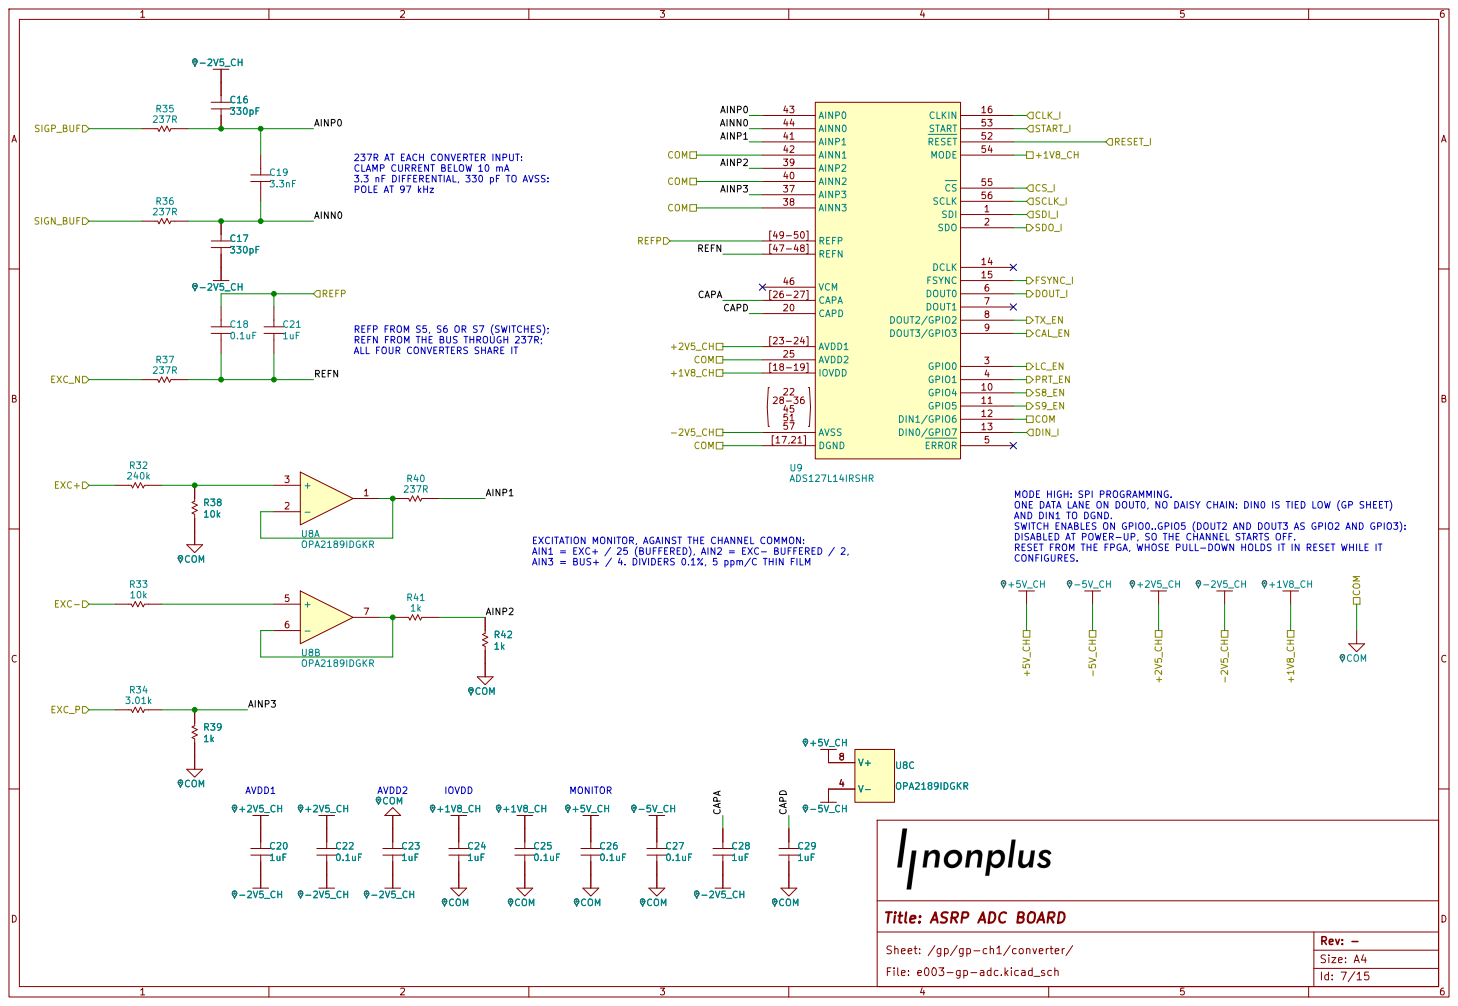
[picture p7: page 7]

AINP1 CAPA EXCITATION MONITOR, AGAINST THE CHANNEL COMMON: AIN1 = EXC+ / 25 (BUFFERED), AIN2 = EXC- BUFFERED / 2, AIN3 = BUS+ / 4. DIVIDERS 0.1%, 5 ppm/C THIN FILM

Title: ASRP ADC BOARD

Sheet: /gp/gp-ch1/converter/
File: e003-gp-adc.kicad_sch

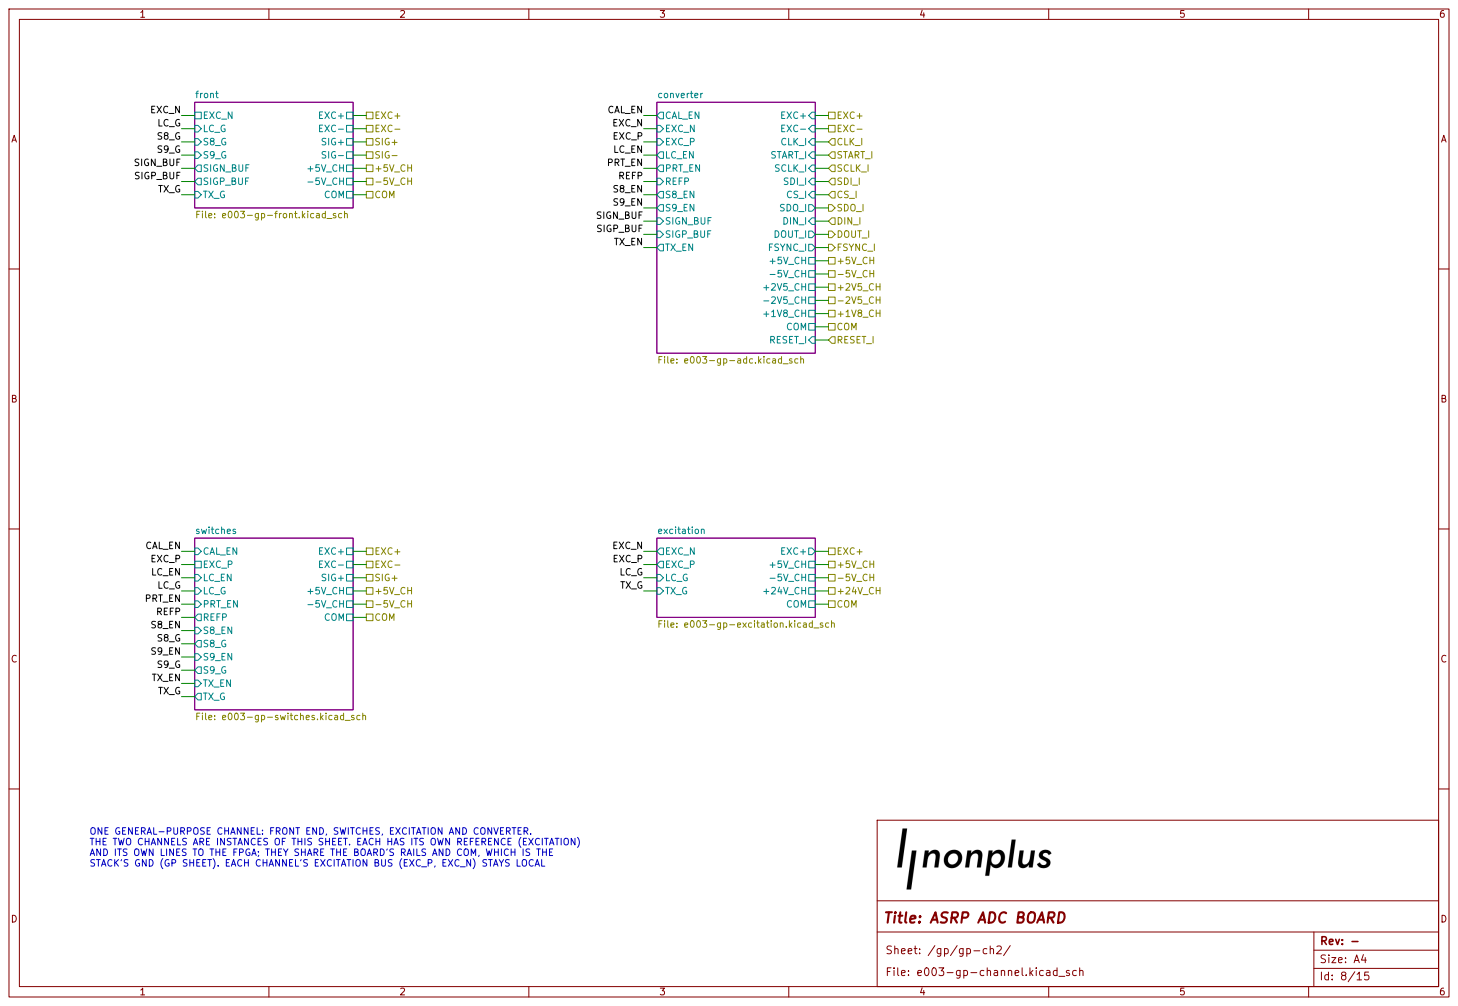
[picture p8: page 8]

RESET_I converter File: e003-gp-adc.kicad_sch CAL_EN

switches File: e003-gp-switches.kicad_sch

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

Title: ASRP ADC BOARD

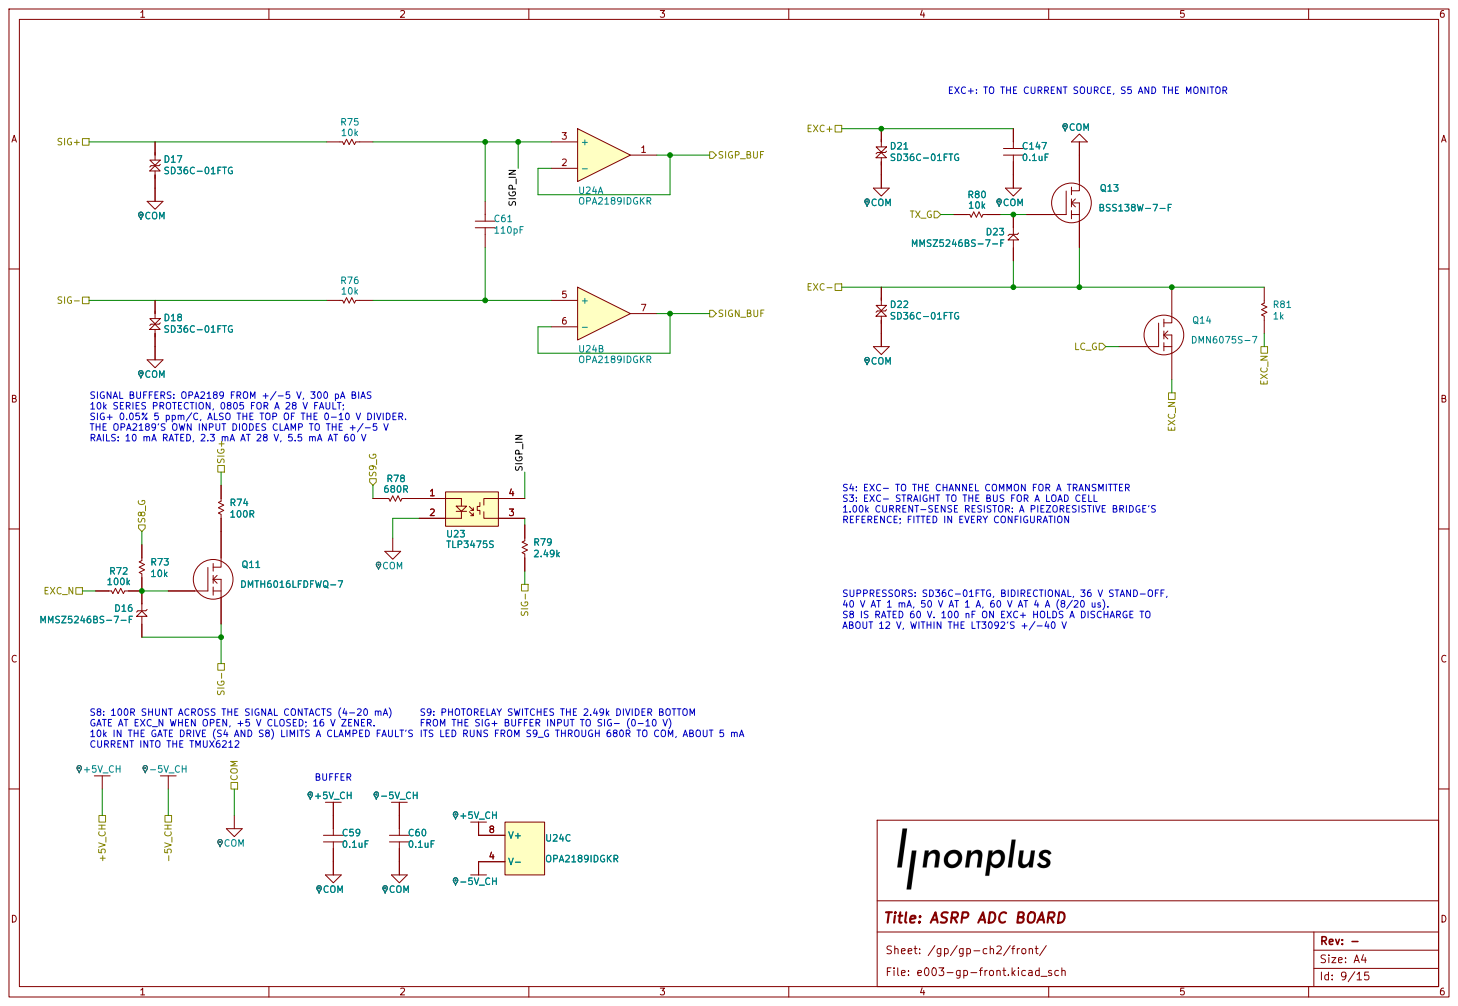
[picture p9: page 9]

EXC+: TO THE CURRENT SOURCE, S5 AND THE MONITOR
7 U24B OPA2189IDGKR +5V_CH

SIGNAL BUFFERS: OPA2189 FROM +/-5 V, 300 pA BIAS
10k SERIES PROTECTION, 0805 FOR A 28 V FAULT; SIG+ 0.05% 5 ppm/C, ALSO THE TOP OF THE 0-10 V DIVIDER. THE OPA2189'S OWN INPUT DIODES CLAMP TO THE +/-5 V RAILS: 10 mA RATED, 2.3 mA AT 28 V, 5.5 mA AT 60 V R74

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

Title: ASRP ADC BOARD

Sheet: /gp/gp-ch2/front/
File: e003-gp-front.kicad_sch

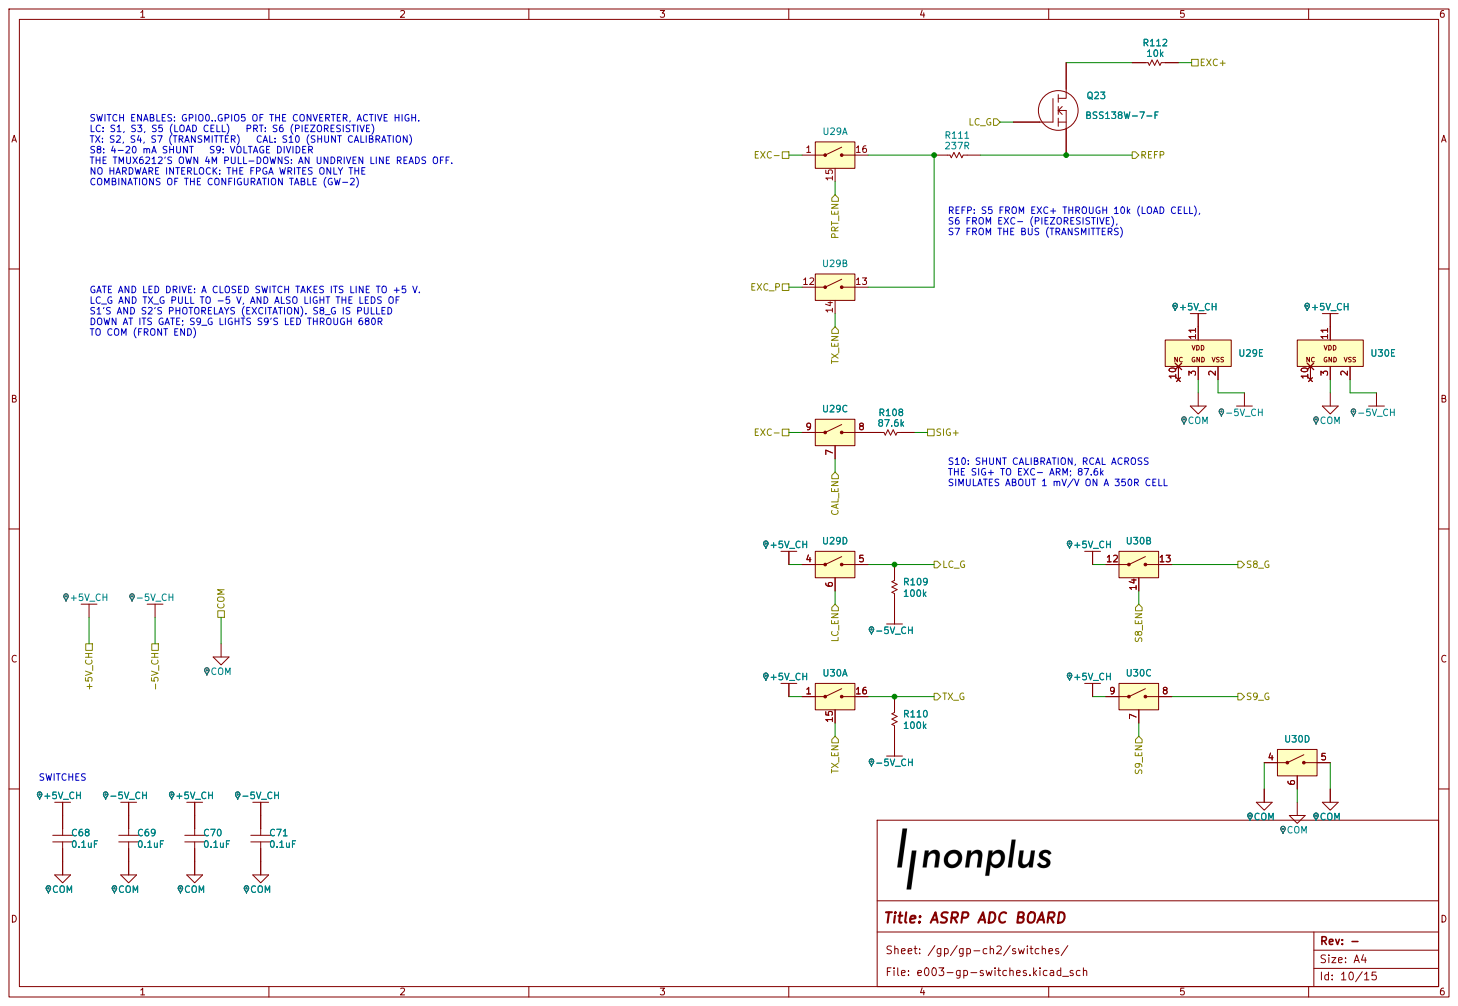
[picture p10: page 10]
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

DOWN AT ITS GATE; S9_G LIGHTS S9'S LED THROUGH 680R

S10: SHUNT CALIBRATION, RCAL ACROSS

Title: ASRP ADC BOARD

Sheet: /gp/gp-ch2/switches/
File: e003-gp-switches.kicad_sch

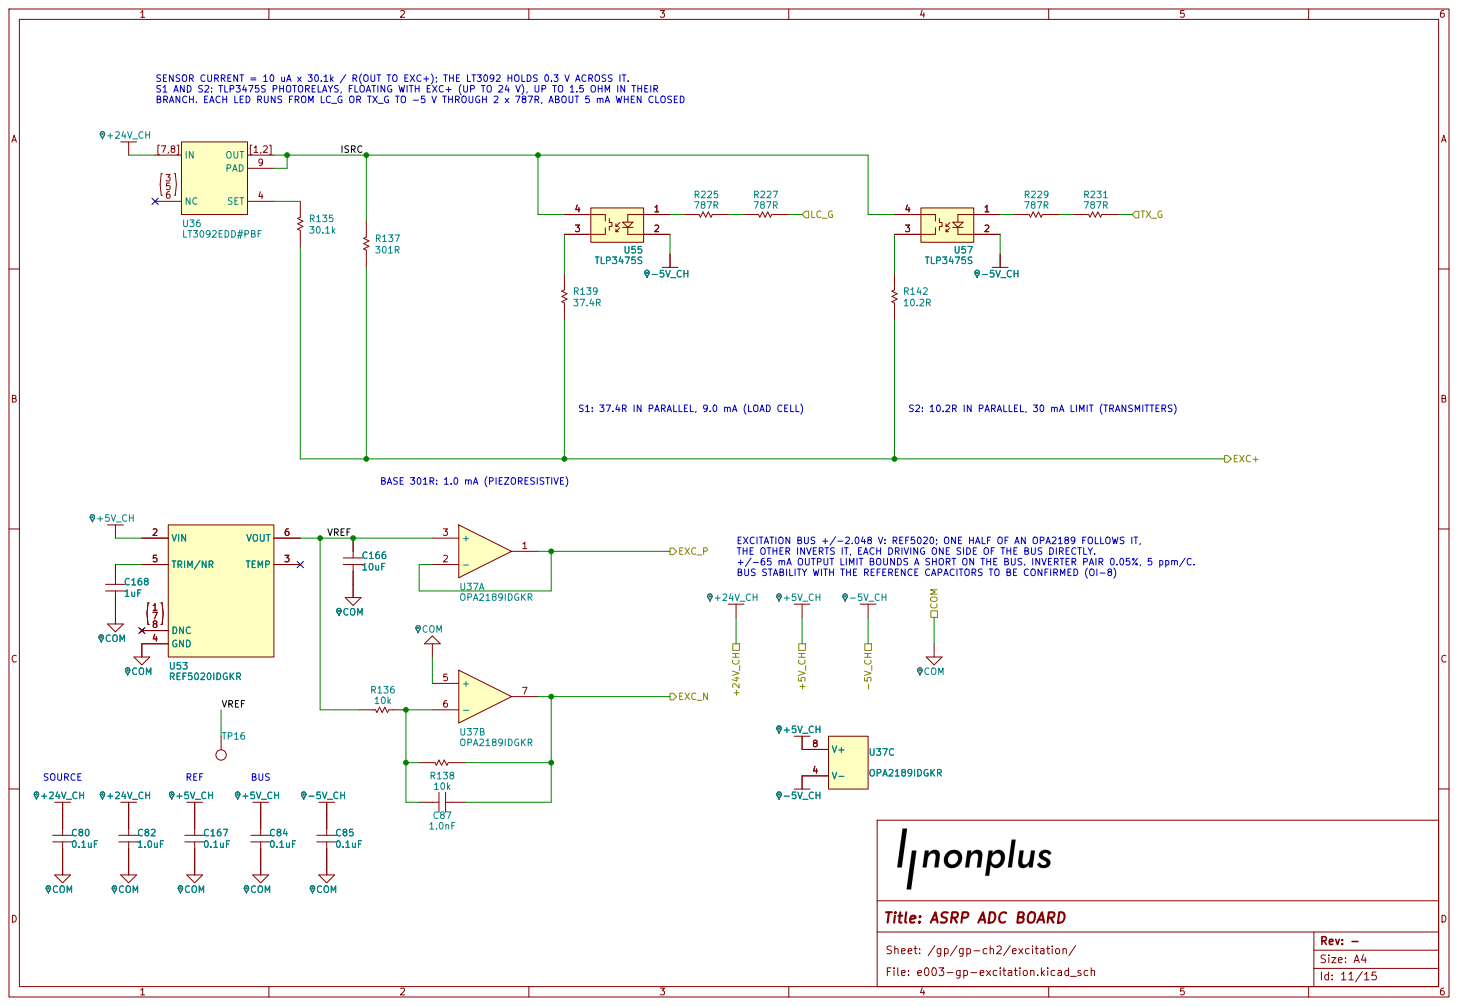
[picture p11: page 11]
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

Title: ASRP ADC BOARD

Sheet: /gp/gp-ch2/excitation/
File: e003-gp-excitation.kicad_sch

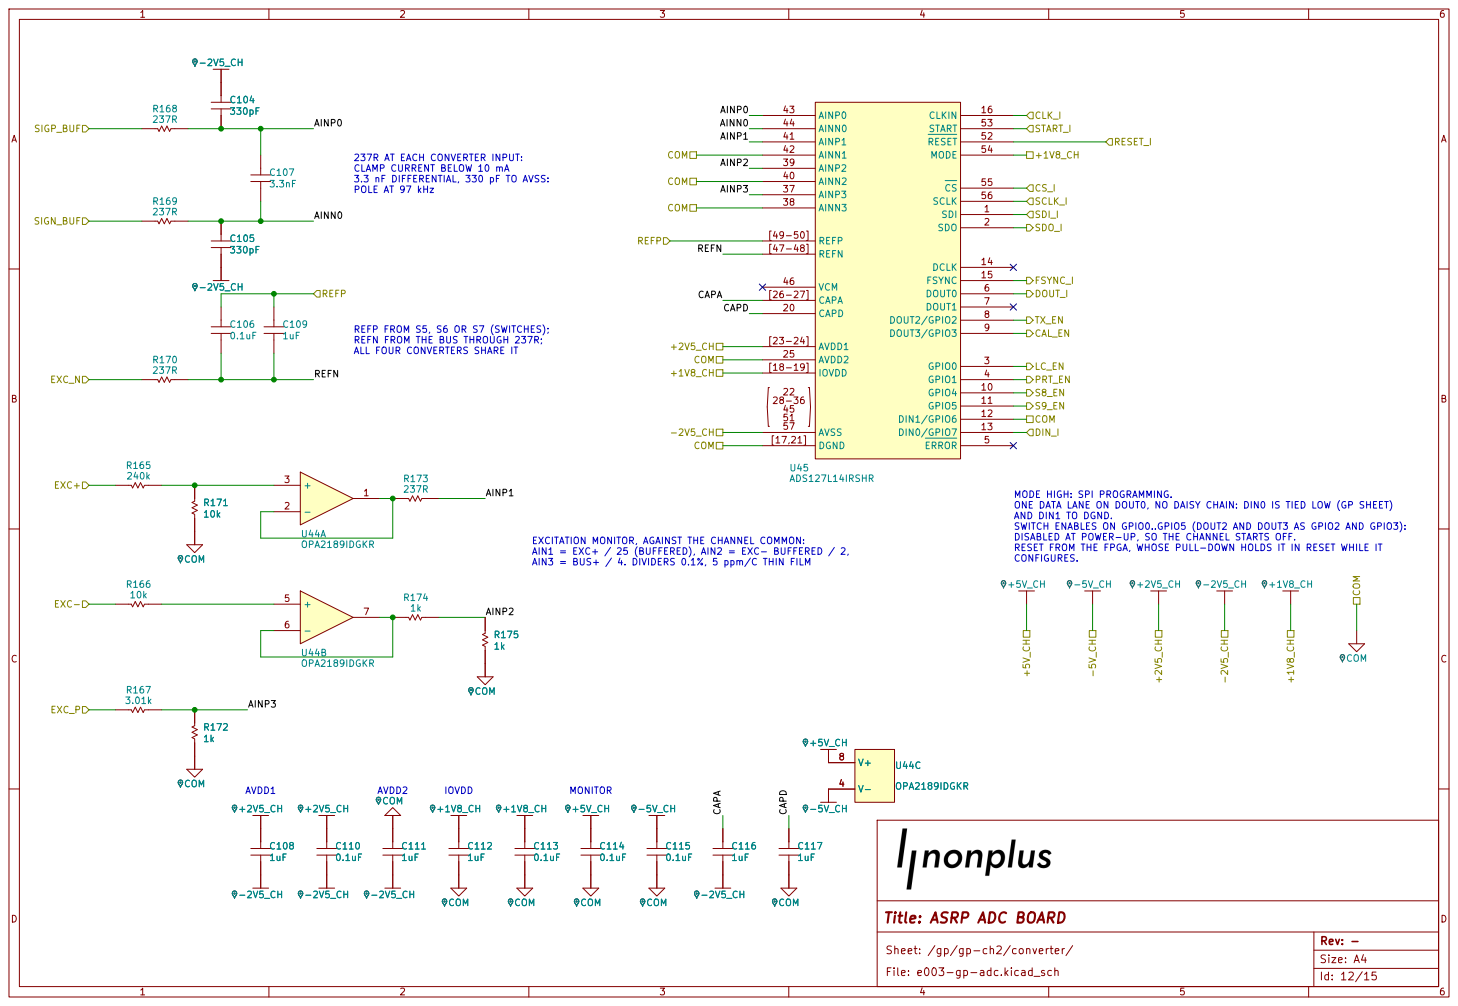
[picture p12: page 12]
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

Title: ASRP ADC BOARD

Sheet: /gp/gp-ch2/converter/
File: e003-gp-adc.kicad_sch

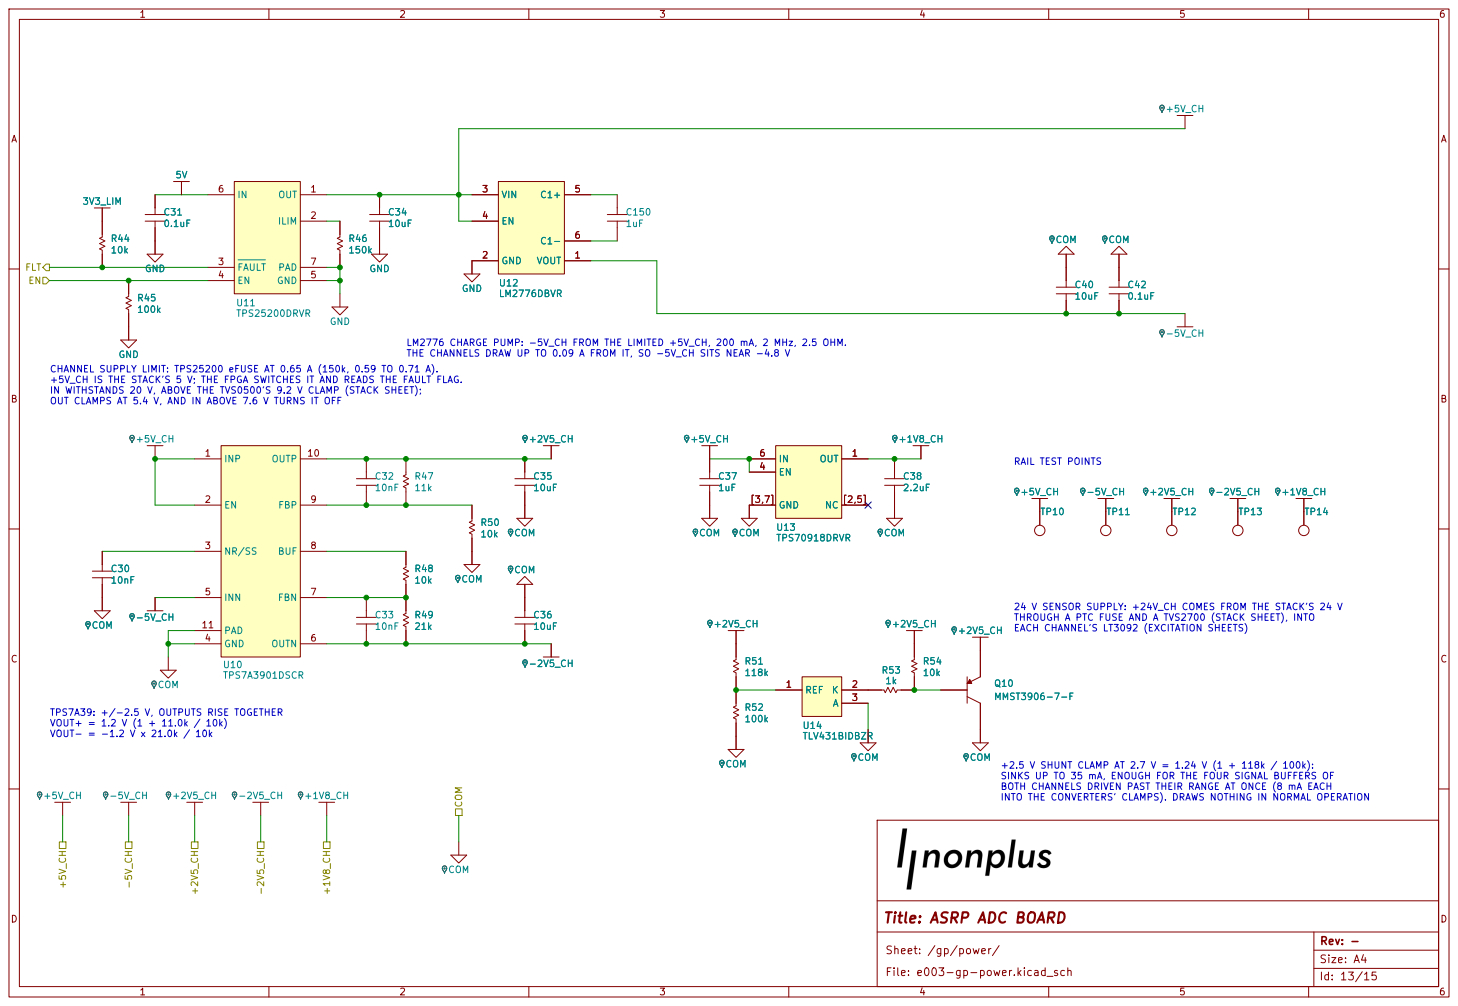
[picture p13: page 13]

LM2776 CHARGE PUMP: -5V_CH FROM THE LIMITED +5V_CH, 200 mA, 2 MHz, 2.5 OHM. THE CHANNELS DRAW UP TO 0.09 A FROM IT, SO -5V_CH SITS NEAR -4.8 V

VOUT+ = 1.2 V (1 + 11.0k / 10k) VOUT- = -1.2 V x 21.0k / 10k CHANNEL SUPPLY LIMIT: TPS25200 eFUSE AT 0.65 A (150k, 0.59 TO 0.71 A). +5V_CH IS THE STACK'S 5 V; THE FPGA SWITCHES IT AND READS THE FAULT FLAG.

EACH CHANNEL'S LT3092 (EXCITATION SHEETS) RAIL TEST POINTS

24 V SENSOR SUPPLY: +24V_CH COMES FROM THE STACK'S 24 V
THROUGH A PTC FUSE AND A TVS2700 (STACK SHEET), INTO

INTO THE CONVERTERS' CLAMPS). DRAWS NOTHING IN NORMAL OPERATION

Title: ASRP ADC BOARD

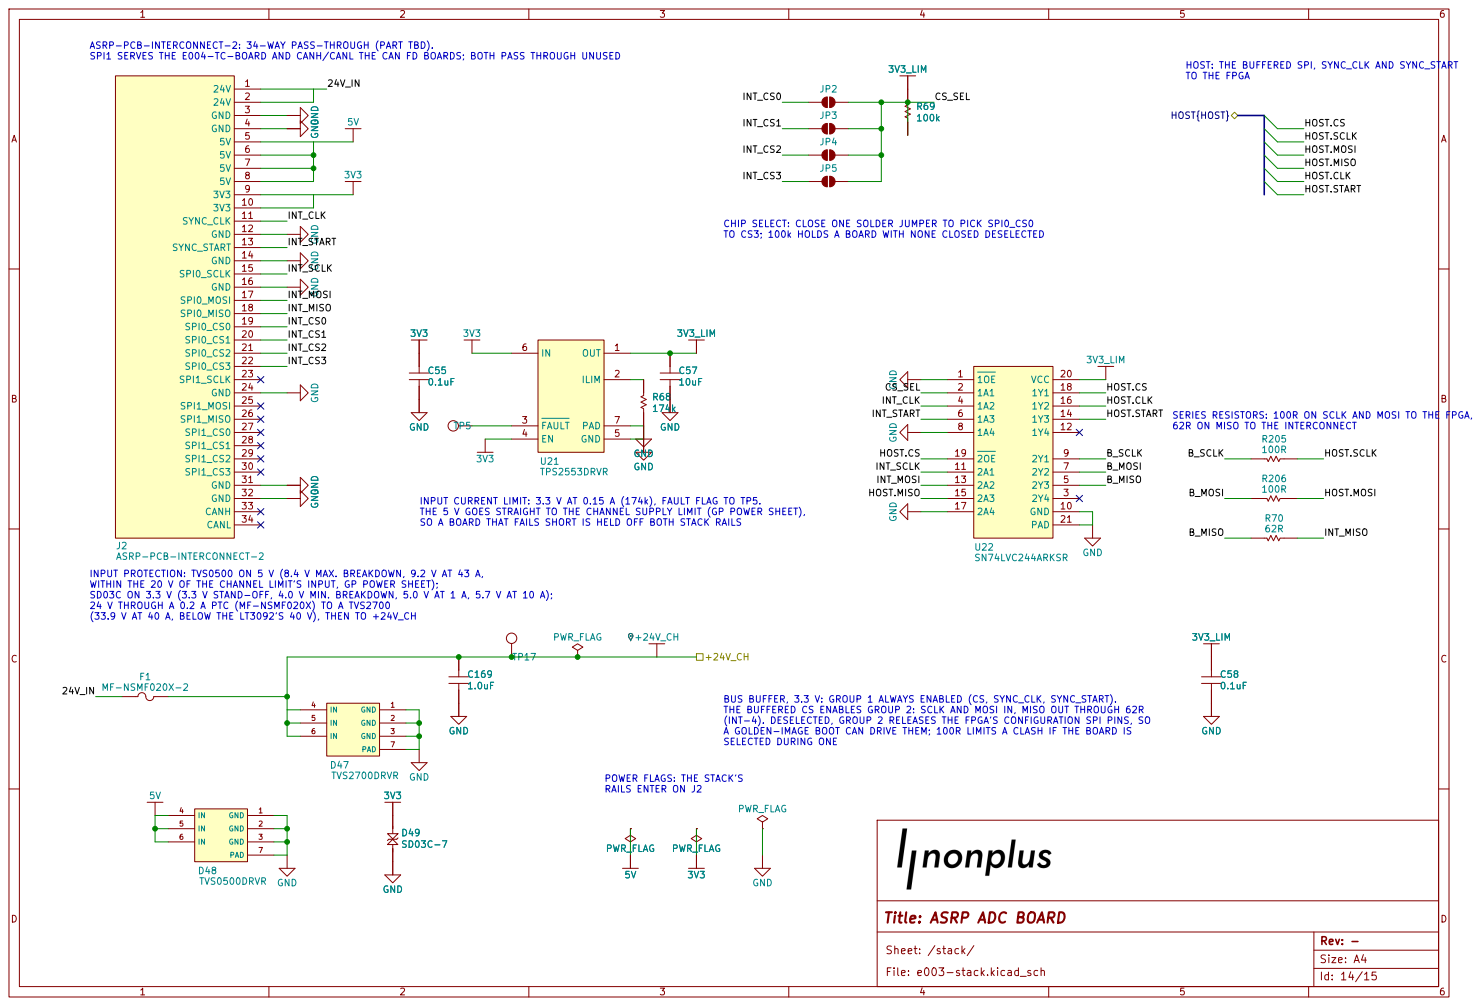
[picture p14: page 14]

ASRP-PCB-INTERCONNECT-2: 34-WAY PASS-THROUGH (PART TBD). SPI1 SERVES THE E004-TC-BOARD AND CANH/CANL THE CAN FD BOARDS; BOTH PASS THROUGH UNUSED

TO THE FPGA SERIES RESISTORS: 100R ON SCLK AND MOSI TO THE FPGA, 62R ON MISO TO THE INTERCONNECT CHIP SELECT: CLOSE ONE SOLDER JUMPER TO PICK SPI0_CS0

TO CS3; 100k HOLDS A BOARD WITH NONE CLOSED DESELECTED GND GND

HOST.CLK HOST.SCLK

INPUT PROTECTION: TVS0500 ON 5 V (8.4 V MAX. BREAKDOWN, 9.2 V AT 43 A, WITHIN THE 20 V OF THE CHANNEL LIMIT'S INPUT, GP POWER SHEET); SD03C ON 3.3 V (3.3 V STAND-OFF, 4.0 V MIN. BREAKDOWN, 5.0 V AT 1 A, 5.7 V AT 10 A); 24 V THROUGH A 0.2 A PTC (MF-NSMF020X) TO A TVS2700

(33.9 V AT 40 A, BELOW THE LT3092'S 40 V), THEN TO +24V_CH

(INT-4). DESELECTED, GROUP 2 RELEASES THE FPGA'S CONFIGURATION SPI PINS, SO
A GOLDEN-IMAGE BOOT CAN DRIVE THEM; 100R LIMITS A CLASH IF THE BOARD IS
SELECTED DURING ONE

POWER FLAGS: THE STACK'S RAILS ENTER ON J2

Title: ASRP ADC BOARD

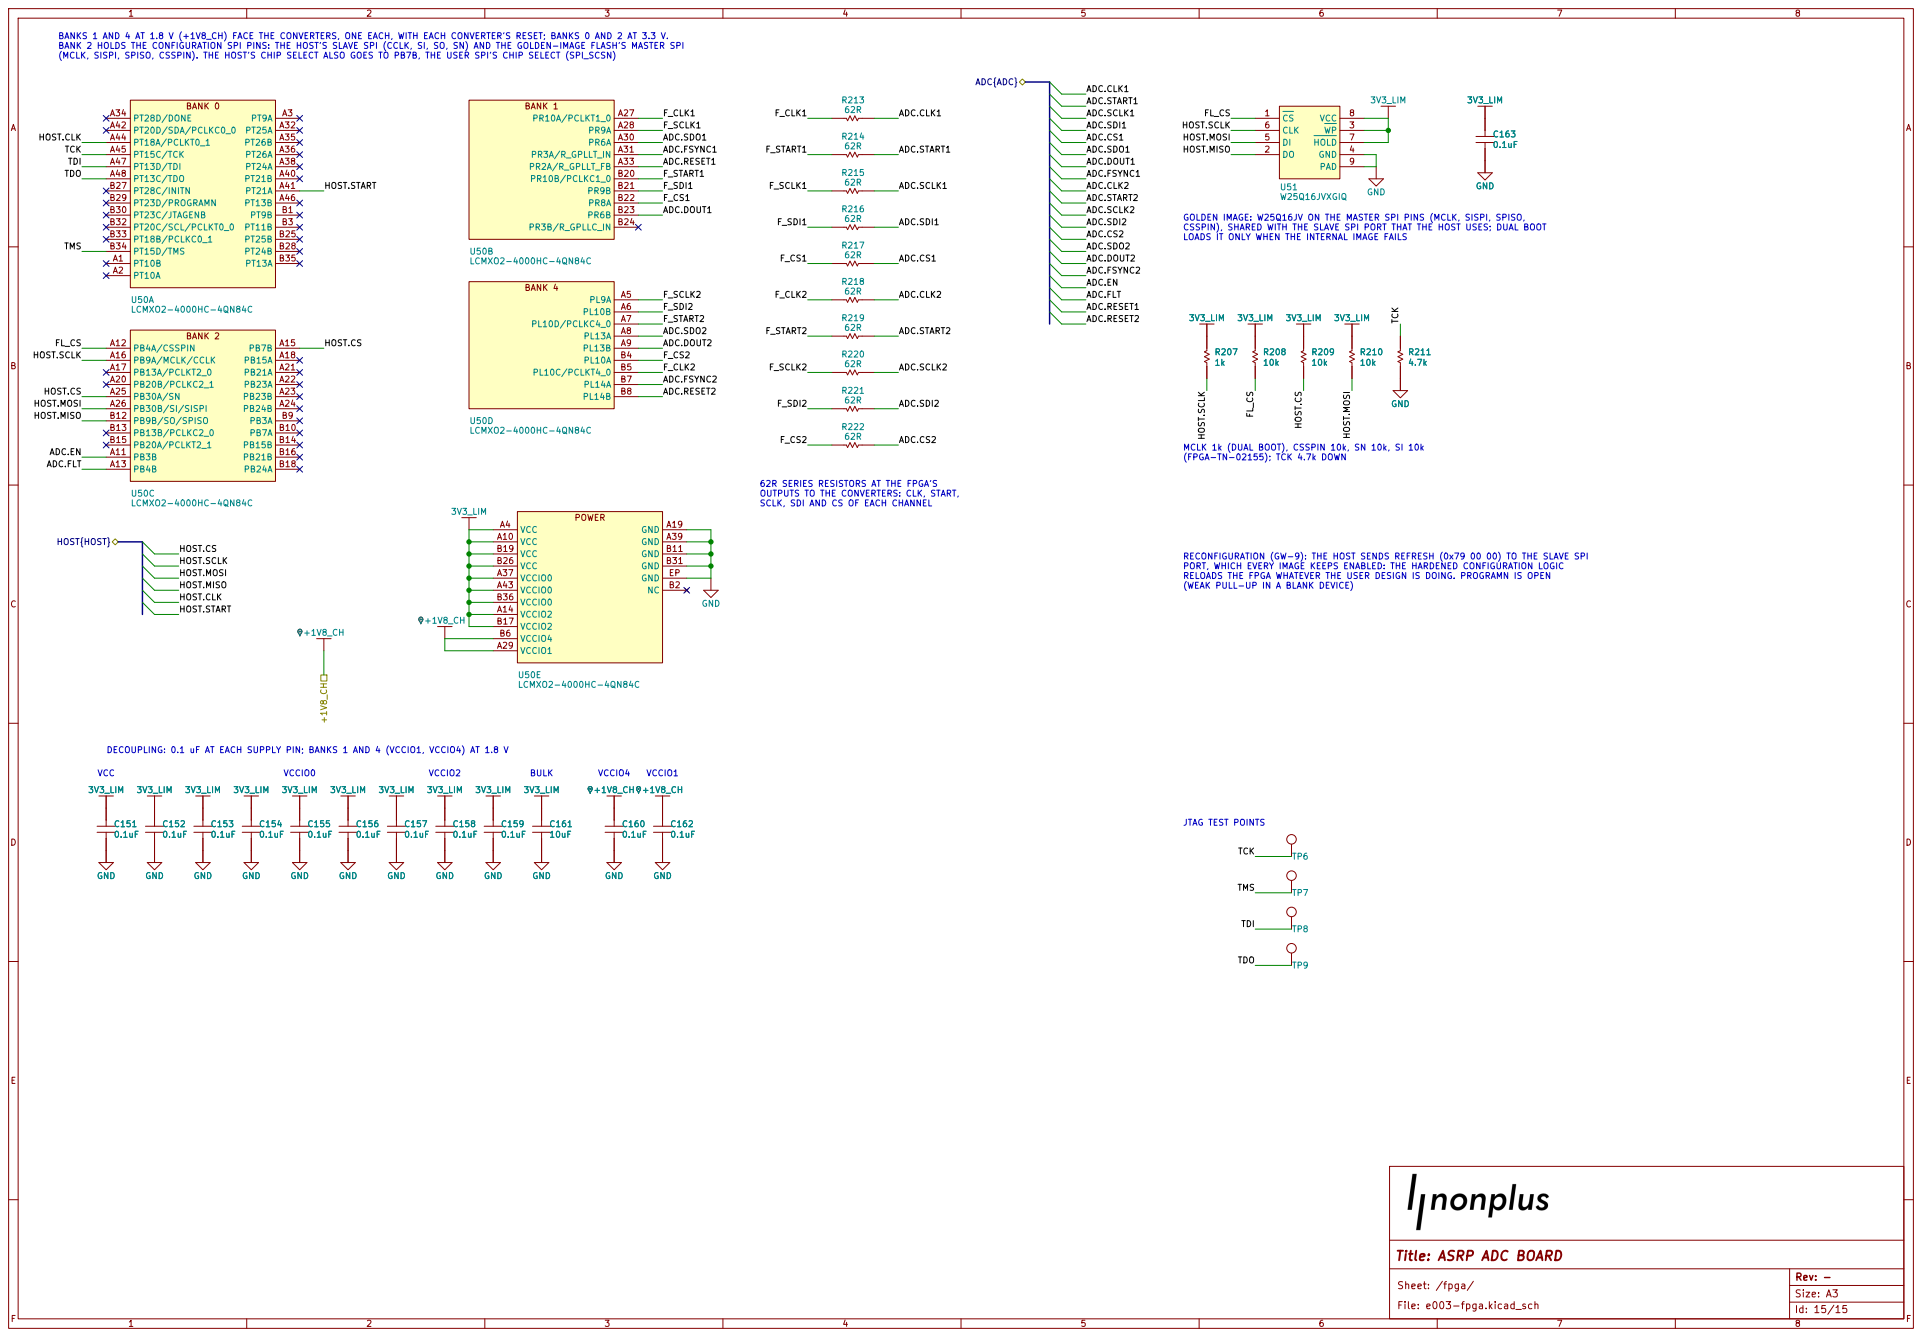
[picture p15: page 15]

F_START2 HOST.CS BANKS 1 AND 4 AT 1.8 V (+1V8_CH) FACE THE CONVERTERS, ONE EACH, WITH EACH CONVERTER'S RESET; BANKS 0 AND 2 AT 3.3 V. BANK 2 HOLDS THE CONFIGURATION SPI PINS: THE HOST'S SLAVE SPI (CCLK, SI, SO, SN) AND THE GOLDEN-IMAGE FLASH'S MASTER SPI (MCLK, SISPI, SPISO, CSSPIN). THE HOST'S CHIP SELECT ALSO GOES TO PB7B, THE USER SPI'S CHIP SELECT (SPI_SCSN)

ADC.CLK1 HOST.SCLK
HOST.MOSI HOST.SCLK HOST.CS
HOST.CLK
TCK
TDI TDO

GOLDEN IMAGE: W25Q16JV ON THE MASTER SPI PINS (MCLK, SISPI, SPISO,

(FPGA-TN-02155); TCK 4.7k DOWN

62R SERIES RESISTORS AT THE FPGA'S OUTPUTS TO THE CONVERTERS: CLK, START,

TDI HOST.CS HOST.SCLK

RELOADS THE FPGA WHATEVER THE USER DESIGN IS DOING. PROGRAMN IS OPEN

(WEAK PULL-UP IN A BLANK DEVICE) BULK

Title: ASRP ADC BOARD
