tnagyzambo/adc-board/e003-adc-board.kicad_pcb

## KiCad design e003-adc-board.kicad_pcb (2026-10-29)

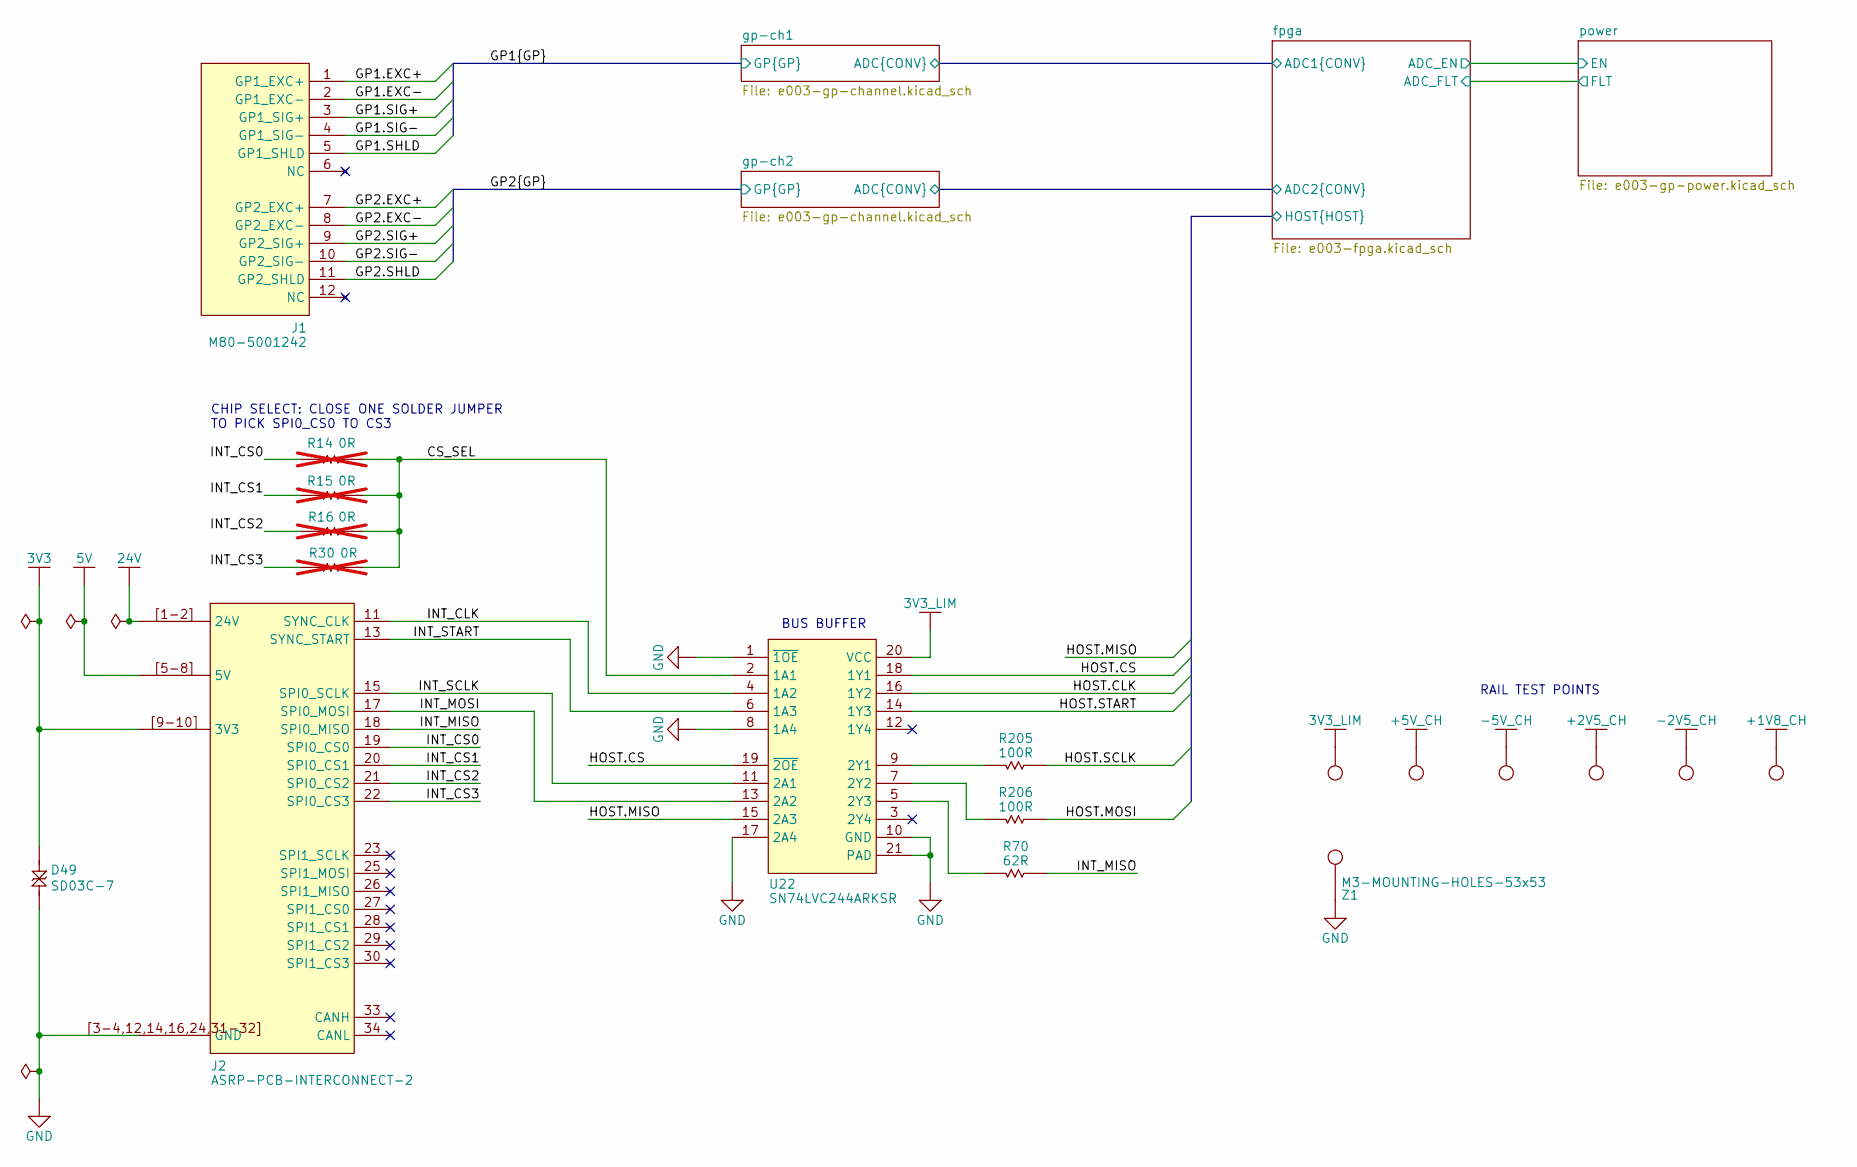
[picture p16: schematic e003-adc-board.kicad_sch, ASRP ADC BOARD]

Parts:
D49: SD03C-7; DIODES-SOD323; Voltage_Rating 3.3V; MPN SD03C-7; DigiKey_Part 31-SD03C-7CT-ND
J1: M80-5001242; HARWIN-M80-5001242; MPN M80-5001242; DigiKey_Part 952-1980-ND
J2: ASRP-PCB-INTERCONNECT-2
R14, R15, R16, R30: 0R; VISHAY-0402; Tolerance 1%; MPN CRCW04020000Z0EEHP; DigiKey_Part 541-CRCW04020000Z0EEHPCT-ND; not fitted
R70: 62R; VISHAY-0402; Tolerance 1%; MPN CRCW040262R0FKEDC; DigiKey_Part 541-CRCW040262R0FKEDCCT-ND
R205, R206: 100R; VISHAY-0402; Tolerance 1%; MPN CRCW0402100RFKEDC; DigiKey_Part 541-3962-1-ND
TP2, TP10, TP11, TP12, TP13, TP14: PCB-TEST-POINT; PCB-PROBEPOINT; MPN N/A
U22: SN74LVC244ARKSR; TI-VQFN-RKS0020C; MPN SN74LVC244ARKSR; DigiKey_Part 296-SN74LVC244ARKSRCT-ND
Z1: M3-MOUNTING-HOLES-53x53; PCB-M3-MOUNTING-HOLES-53x53; MPN N/A

Connections:
3V3: D49.1 (A1), J2.[9-10] (3V3); also elsewhere on the board
3V3_LIM: TP2.1 (0_1), U22.20 (VCC); also elsewhere on the board
+1V8_CH: TP14.1 (0_1); also elsewhere on the board
+2V5_CH: TP12.1 (0_1); also elsewhere on the board
+5V_CH: TP10.1 (0_1); also elsewhere on the board
-2V5_CH: TP13.1 (0_1); also elsewhere on the board
-5V_CH: TP11.1 (0_1); also elsewhere on the board
/CS_SEL: R14.1, R15.1, R16.1, R30.1, U22.2 (1A1)
/GP1.EXC+: J1.1 (GP1_EXC+); also elsewhere on the board
/GP1.EXC-: J1.2 (GP1_EXC-); also elsewhere on the board
/GP1.SHLD: J1.5 (GP1_SHLD); also elsewhere on the board
/GP1.SIG+: J1.3 (GP1_SIG+); also elsewhere on the board
/GP1.SIG-: J1.4 (GP1_SIG-); also elsewhere on the board
/GP2.EXC+: J1.7 (GP2_EXC+); also elsewhere on the board
/GP2.EXC-: J1.8 (GP2_EXC-); also elsewhere on the board
/GP2.SHLD: J1.11 (GP2_SHLD); also elsewhere on the board
/GP2.SIG+: J1.9 (GP2_SIG+); also elsewhere on the board
/GP2.SIG-: J1.10 (GP2_SIG-); also elsewhere on the board
/INT_CLK: J2.11 (SYNC_CLK), U22.4 (1A2)
/INT_CS0: J2.19 (SPI0_CS0), R14.2
/INT_CS1: J2.20 (SPI0_CS1), R15.2
/INT_CS2: J2.21 (SPI0_CS2), R16.2
/INT_CS3: J2.22 (SPI0_CS3), R30.2
/INT_MISO: J2.18 (SPI0_MISO), R70.1
/INT_MOSI: J2.17 (SPI0_MOSI), U22.13 (2A2)
/INT_SCLK: J2.15 (SPI0_SCLK), U22.11 (2A1)
/INT_START: J2.13 (SYNC_START), U22.6 (1A3)
/fpga/HOST.CLK: U22.16 (1Y2); also elsewhere on the board
/fpga/HOST.CS: U22.18 (1Y1), U22.19 (~2OE); also elsewhere on the board
/fpga/HOST.MISO: U22.15 (2A3); also elsewhere on the board
/fpga/HOST.MOSI: R206.1; also elsewhere on the board
/fpga/HOST.SCLK: R205.1; also elsewhere on the board
/fpga/HOST.START: U22.14 (1Y3); also elsewhere on the board
GND: D49.2 (A2), J2.[3-4,12,14,16,24,31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 (GND), U22.1 (~1OE), U22.8 (1A4), U22.10 (GND), U22.17 (2A4), U22.21 (PAD), Z1.1; also elsewhere on the board
unnamed: R205.2, U22.9 (2Y1)
unnamed: R206.2, U22.7 (2Y2)
unnamed: R70.2, U22.5 (2Y3)

Notes on the sheet:
CHIP SELECT: CLOSE ONE SOLDER JUMPER TO PICK SPI0_CS0 TO CS3
RAIL TEST POINTS
BUS BUFFER

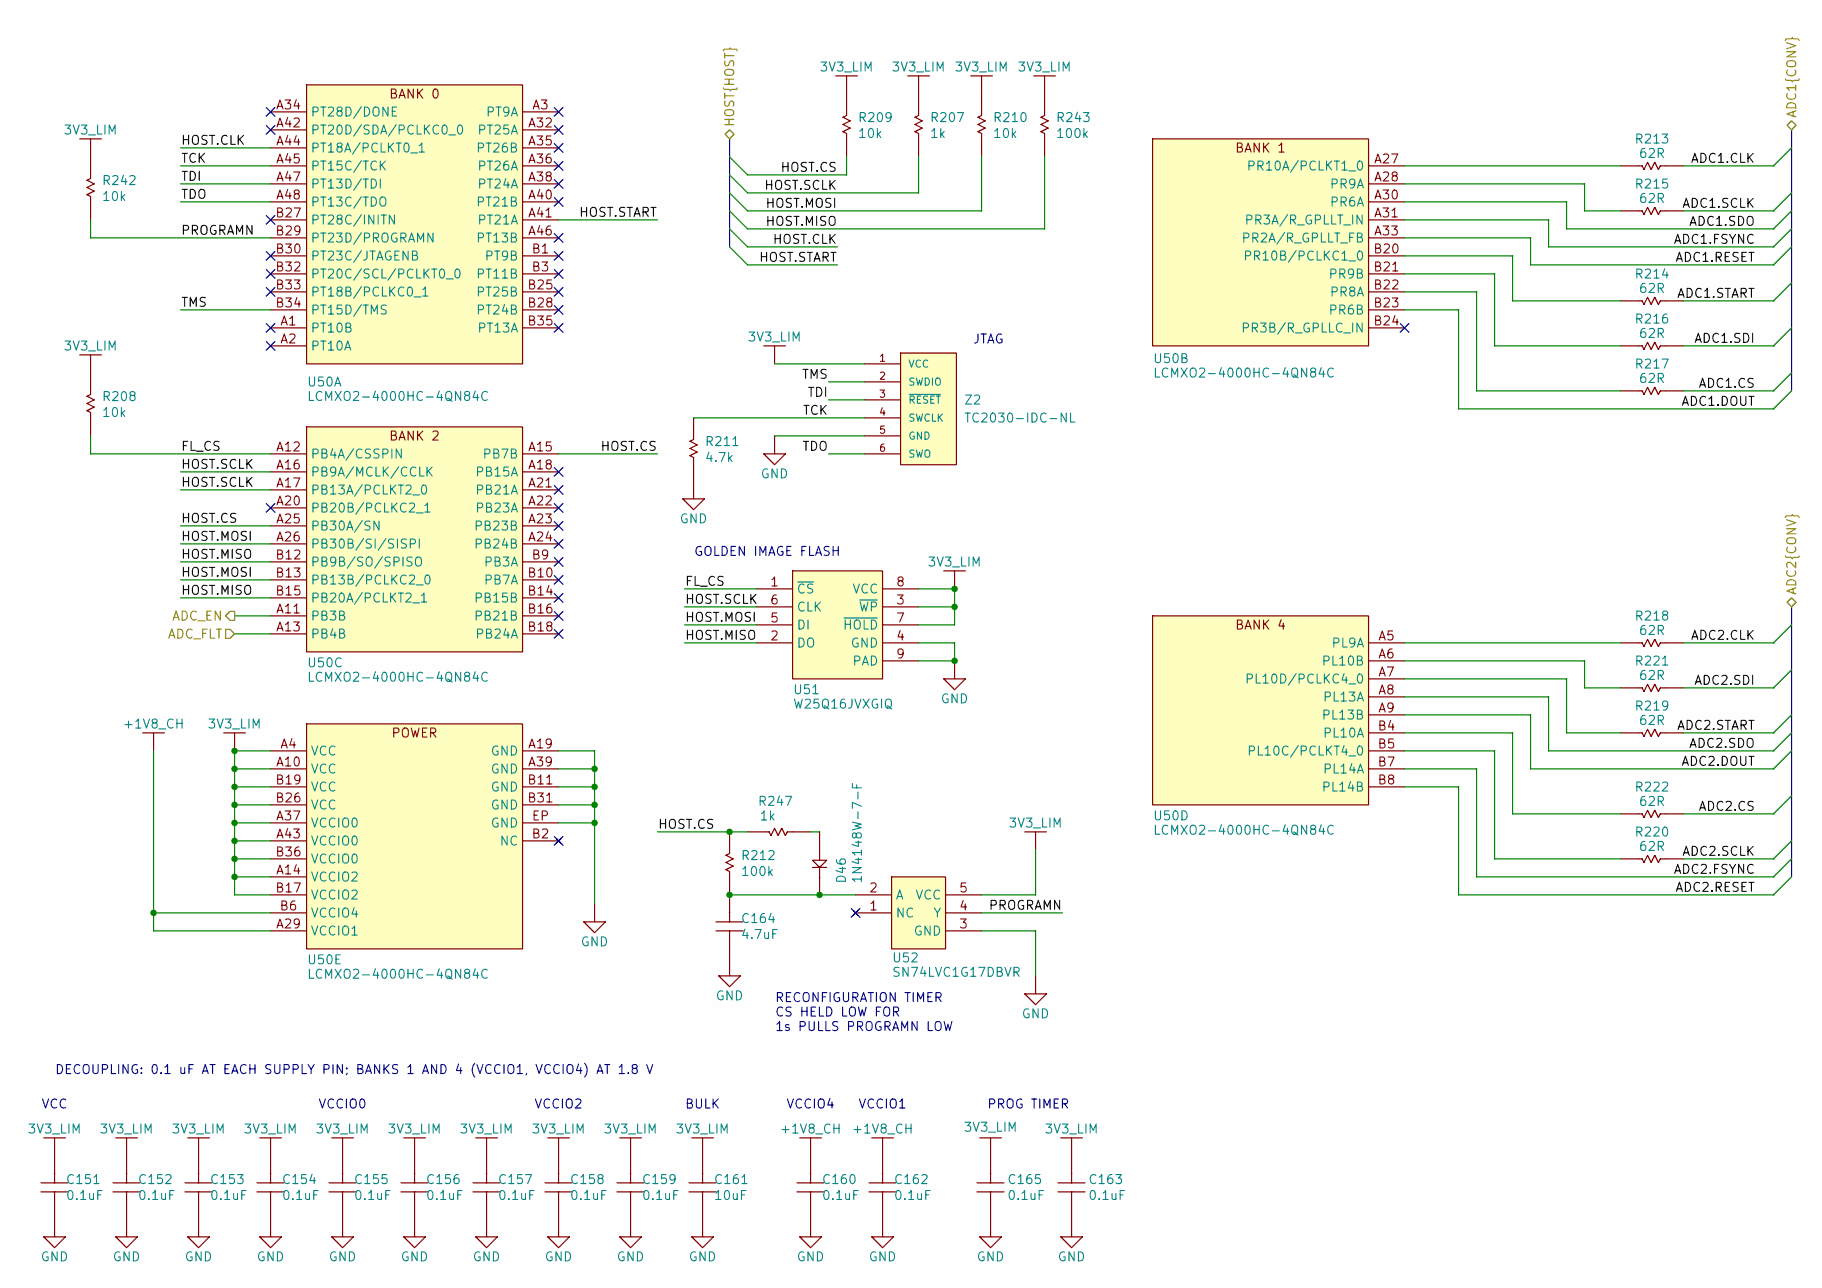
[picture p17: schematic e003-fpga.kicad_sch, ASRP ADC BOARD]

Parts:
C151, C152, C153, C154, C155, C156, C157, C158, C159, C160, C162, C163, C165: 0.1uF; MURATA-0402; Tolerance 10%; Voltage_Rating 50 VDC; MPN GRM155R71H104KE14J; DigiKey_Part 490-13342-2-ND
C161: 10uF; MURATA-0805; Tolerance 10%; Voltage_Rating 25 VDC; MPN GRM21BZ71E106KE15K; DigiKey_Part 490-GRM21BZ71E106KE15KCT-ND
C164: 4.7uF; MURATA-0805; Tolerance 10%; Voltage_Rating 25 VDC; MPN GRM21BZ71E475KE15L; DigiKey_Part 490-GRM21BZ71E475KE15LCT-ND
D46: 1N4148W-7-F; DIODES-SOD123; Voltage_Rating 100V; MPN 1N4148W-7-F; DigiKey_Part 1N4148W-FDICT-ND
R207, R247: 1k; VISHAY-0402; Tolerance 1%; MPN CRCW04021K00FKED; DigiKey_Part 541-1.00KLCT-ND
R208, R209, R210, R242: 10k; VISHAY-0402; Tolerance 1%; MPN CRCW040210K0FKEDC; DigiKey_Part 541-3959-1-ND
R211: 4.7k; VISHAY-0402; Tolerance 1%; MPN CRCW04024K70FKED; DigiKey_Part 541-4.70KLCT-ND
R212, R243: 100k; VISHAY-0402; Tolerance 1%; MPN CRCW0402100KFKEDC; DigiKey_Part 541-3960-1-ND
R213, R214, R215, R216, R217, R218, R219, R220, R221, R222: 62R; VISHAY-0402; Tolerance 1%; MPN CRCW040262R0FKEDC; DigiKey_Part 541-CRCW040262R0FKEDCCT-ND
U50: LCMXO2-4000HC-4QN84C; LATTICE-QFN84; MPN LCMXO2-4000HC-4QN84C; DigiKey_Part LCMXO2-4000HC-4QN84C-ND
U51: W25Q16JVXGIQ; WINBOND-XSON8-4X4; MPN W25Q16JVXGIQ; DigiKey_Part none
U52: SN74LVC1G17DBVR; TI-SOT23-DBV0005A; MPN SN74LVC1G17DBVR; DigiKey_Part none
Z2: TC2030-IDC-NL; PCB-TAG-TC2030-IDC-NL; MPN N/A

Connections:
3V3_LIM: C151.2, C152.2, C153.2, C154.2, C155.2, C156.2, C157.2, C158.2, C159.2, C161.2, C163.2, C165.2, R207.2, R208.2, R209.2, R210.2, R242.2, R243.2, U50.A4 (VCC), U50.A10 (VCC), U50.A14 (VCCIO2), U50.A37 (VCCIO0), U50.A43 (VCCIO0), U50.B17 (VCCIO2), U50.B19 (VCC), U50.B26 (VCC), U50.B36 (VCCIO0), U51.3 (~WP), U51.7 (~HOLD), U51.8 (VCC), U52.5 (VCC), Z2.1 (VCC); also elsewhere on the board
+1V8_CH: C160.2, C162.2, U50.A29 (VCCIO1), U50.B6 (VCCIO4); also elsewhere on the board
/fpga/ADC1.CLK: R213.1; also elsewhere on the board
/fpga/ADC1.CS: R217.1; also elsewhere on the board
/fpga/ADC1.DOUT: U50.B23 (PR6B); also elsewhere on the board
/fpga/ADC1.FSYNC: U50.A31 (PR3A/R_GPLLT_IN); also elsewhere on the board
/fpga/ADC1.RESET: U50.A33 (PR2A/R_GPLLT_FB); also elsewhere on the board
/fpga/ADC1.SCLK: R215.1; also elsewhere on the board
/fpga/ADC1.SDI: R216.1; also elsewhere on the board
/fpga/ADC1.SDO: U50.A30 (PR6A); also elsewhere on the board
/fpga/ADC1.START: R214.1; also elsewhere on the board
/fpga/ADC2.CLK: R218.1; also elsewhere on the board
/fpga/ADC2.CS: R222.1; also elsewhere on the board
/fpga/ADC2.DOUT: U50.A9 (PL13B); also elsewhere on the board
/fpga/ADC2.FSYNC: U50.B7 (PL14A); also elsewhere on the board
/fpga/ADC2.RESET: U50.B8 (PL14B); also elsewhere on the board
/fpga/ADC2.SCLK: R220.1; also elsewhere on the board
/fpga/ADC2.SDI: R221.1; also elsewhere on the board
/fpga/ADC2.SDO: U50.A8 (PL13A); also elsewhere on the board
/fpga/ADC2.START: R219.1; also elsewhere on the board
/fpga/ADC_EN: U50.A11 (PB3B); also elsewhere on the board
/fpga/ADC_FLT: U50.A13 (PB4B); also elsewhere on the board
/fpga/FL_CS: R208.1, U50.A12 (PB4A/CSSPIN), U51.1 (~CS)
/fpga/HOST.CLK: U50.A44 (PT18A/PCLKT0_1); also elsewhere on the board
/fpga/HOST.CS: R209.1, R212.2, R247.2, U50.A15 (PB7B), U50.A25 (PB30A/SN); also elsewhere on the board
/fpga/HOST.MISO: R243.1, U50.B12 (PB9B/SO/SPISO), U50.B15 (PB20A/PCLKT2_1), U51.2 (DO); also elsewhere on the board
/fpga/HOST.MOSI: R210.1, U50.A26 (PB30B/SI/SISPI), U50.B13 (PB13B/PCLKC2_0), U51.5 (DI); also elsewhere on the board
/fpga/HOST.SCLK: R207.1, U50.A16 (PB9A/MCLK/CCLK), U50.A17 (PB13A/PCLKT2_0), U51.6 (CLK); also elsewhere on the board
/fpga/HOST.START: U50.A41 (PT21A); also elsewhere on the board
/fpga/PROGRAMN: R242.1, U50.B29 (PT23D/PROGRAMN), U52.4 (Y)
/fpga/TCK: R211.2, U50.A45 (PT15C/TCK), Z2.4 (SWCLK)
/fpga/TDI: U50.A47 (PT13D/TDI), Z2.3 (~RESET)
/fpga/TDO: U50.A48 (PT13C/TDO), Z2.6 (SWO)
/fpga/TMS: U50.B34 (PT15D/TMS), Z2.2 (SWDIO)
GND: C151.1, C152.1, C153.1, C154.1, C155.1, C156.1, C157.1, C158.1, C159.1, C160.1, C161.1, C162.1, C163.1, C164.1, C165.1, R211.1, U50.A19 (GND), U50.A39 (GND), U50.B11 (GND), U50.B31 (GND), U50.EP (GND), U51.4 (GND), U51.9 (PAD), U52.3 (GND), Z2.5 (GND); also elsewhere on the board
unnamed: D46.1 (0), R247.1
unnamed: C164.2, D46.2 (1), R212.1, U52.2 (A)
unnamed: R217.2, U50.B22 (PR8A)
unnamed: R215.2, U50.A28 (PR9A)
unnamed: R216.2, U50.B21 (PR9B)
unnamed: R213.2, U50.A27 (PR10A/PCLKT1_0)
unnamed: R214.2, U50.B20 (PR10B/PCLKC1_0)
unnamed: R218.2, U50.A5 (PL9A)
unnamed: R222.2, U50.B4 (PL10A)
unnamed: R221.2, U50.A6 (PL10B)
unnamed: R220.2, U50.B5 (PL10C/PCLKT4_0)
unnamed: R219.2, U50.A7 (PL10D/PCLKC4_0)

Notes on the sheet:
VCCIO4
VCCIO2
PROG TIMER
GOLDEN IMAGE FLASH
VCC
VCCIO1
RECONFIGURATION TIMER CS HELD LOW FOR 1s PULLS PROGRAMN LOW
JTAG
BULK
DECOUPLING: 0.1 uF AT EACH SUPPLY PIN; BANKS 1 AND 4 (VCCIO1, VCCIO4) AT 1.8 V
VCCIO0

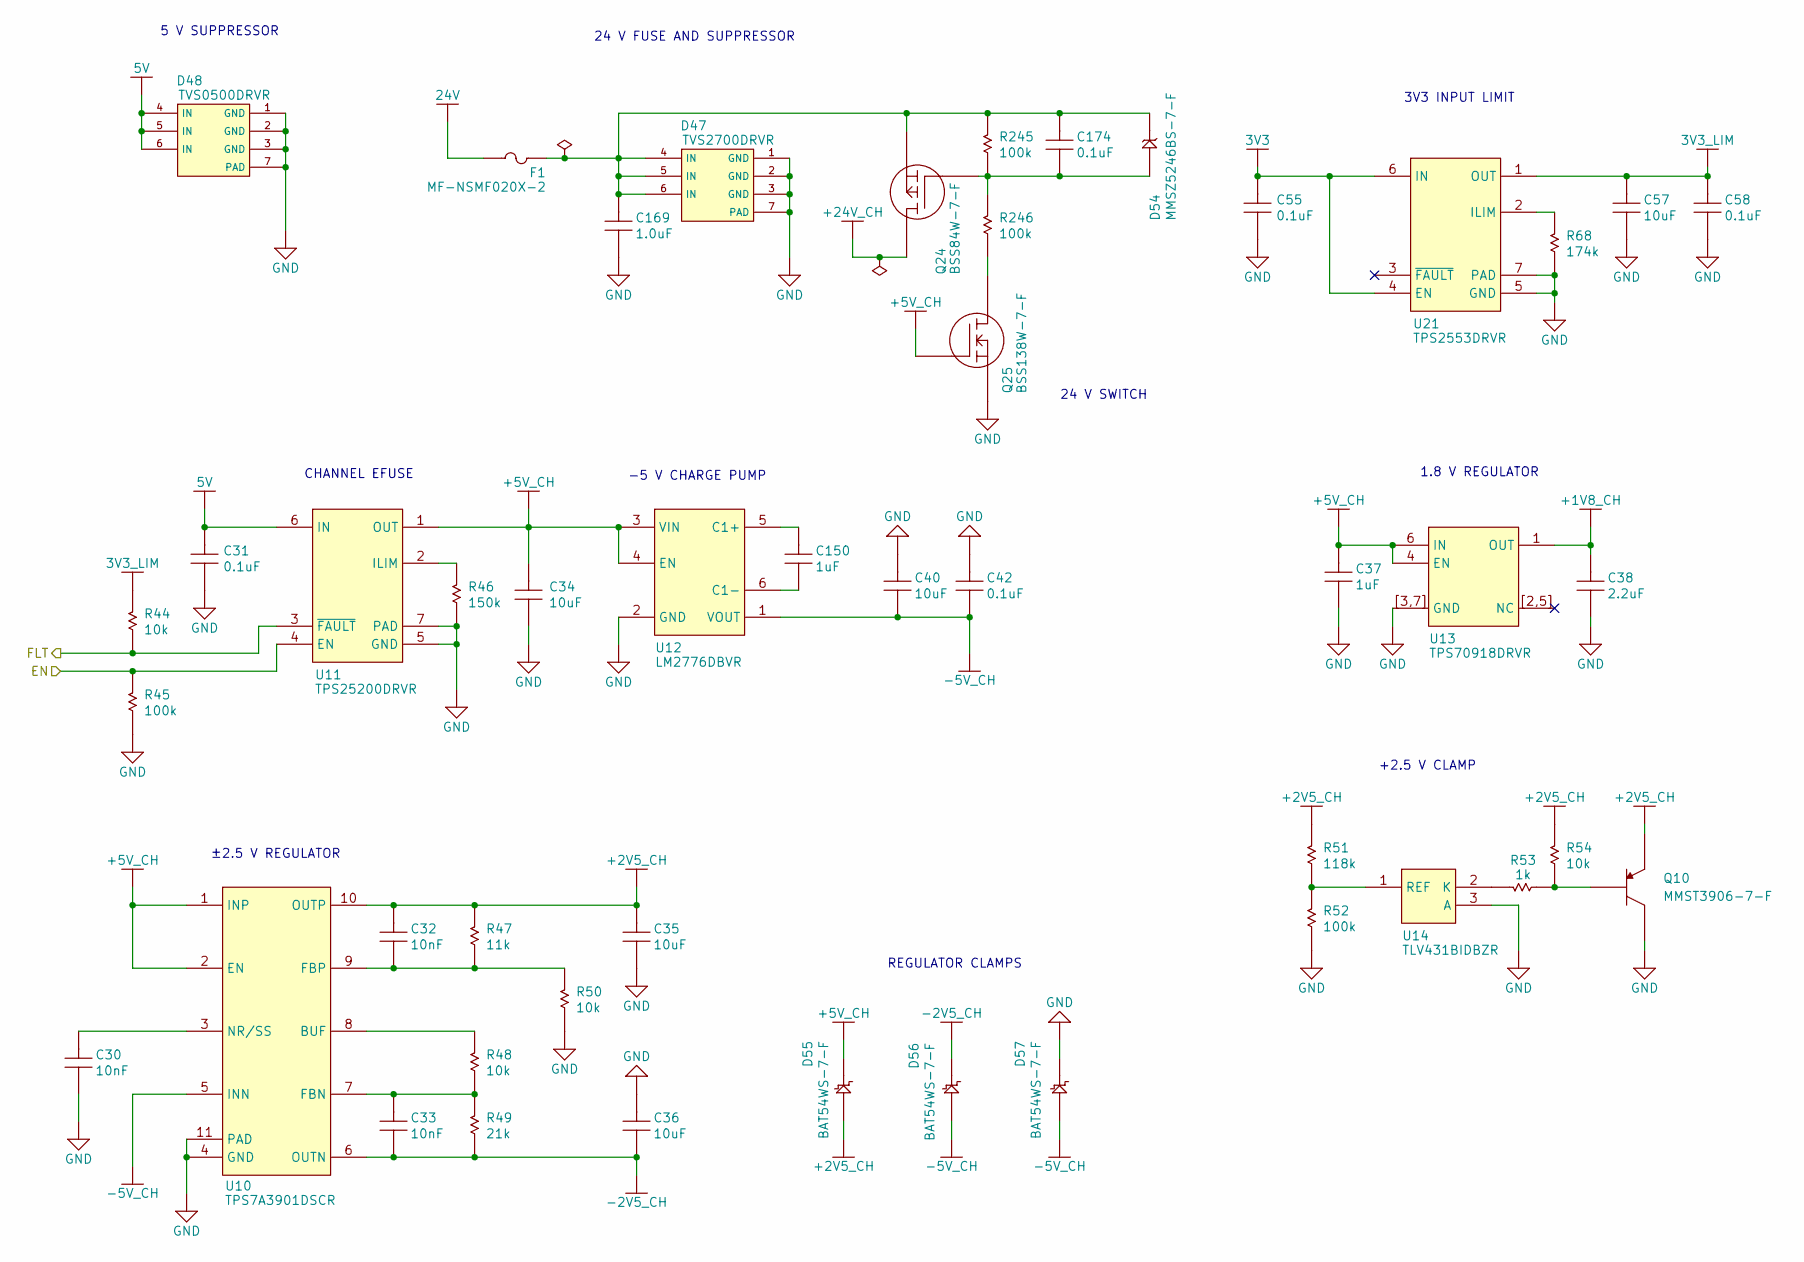
[picture p18: schematic e003-gp-power.kicad_sch, ASRP ADC BOARD]

Parts:
C30, C32, C33: 10nF; MURATA-0402; Tolerance 10%; Voltage_Rating 25 VDC; MPN GXT155R71E103KE01D; DigiKey_Part 490-GXT155R71E103KE01DCT-ND
C31, C42, C55, C58, C174: 0.1uF; MURATA-0402; Tolerance 10%; Voltage_Rating 50 VDC; MPN GRM155R71H104KE14J; DigiKey_Part 490-13342-2-ND
C34, C35, C36, C40, C57: 10uF; MURATA-0805; Tolerance 10%; Voltage_Rating 25 VDC; MPN GRM21BZ71E106KE15K; DigiKey_Part 490-GRM21BZ71E106KE15KCT-ND
C37, C150: 1uF; MURATA-0402; Tolerance 10%; Voltage_Rating 10 VDC; MPN GRM155Z71A105KE01D; DigiKey_Part 490-GRM155Z71A105KE01DCT-ND
C38: 2.2uF; MURATA-0402; Tolerance 10%; Voltage_Rating 10 VDC; MPN GRM155Z71A225KE01J; DigiKey_Part 490-GRM155Z71A225KE01JCT-ND
C169: 1.0uF; MURATA-0805; Tolerance 10%; Voltage_Rating 50 VDC; MPN GCJ21BR71H105KA01L; DigiKey_Part 490-10667-1-ND
D47: TVS2700DRVR; TI-WSON-DRV0006A; Voltage_Rating 27V; MPN TVS2700DRVR; DigiKey_Part 296-50512-1-ND
D48: TVS0500DRVR; TI-WSON-DRV0006A; Voltage_Rating 5V; MPN TVS0500DRVR; DigiKey_Part 296-48382-1-ND
D54: MMSZ5246BS-7-F; DIODES-SOD323; Voltage_Rating 16V; MPN MMSZ5246BS-7-F; DigiKey_Part MMSZ5246BS-FDICT-ND
D55, D56, D57: BAT54WS-7-F; DIODES-SOD323; Voltage_Rating 30V; MPN BAT54WS-7-F; DigiKey_Part BAT54WS-FDICT-ND
F1: MF-NSMF020X-2; BOURNS-MF-NSMF; Voltage_Rating 30VDC; MPN MF-NSMF020X-2; DigiKey_Part MF-NSMF020X-2CT-ND
Q10: MMST3906-7-F; DIODES-SOT323; Voltage_Rating -40V; MPN MMST3906-7-F; DigiKey_Part MMST3906-FDICT-ND
Q24: BSS84W-7-F; DIODES-SOT323; Voltage_Rating -50V; MPN BSS84W-7-F; DigiKey_Part BSS84W-FDICT-ND
Q25: BSS138W-7-F; DIODES-SOT323; Voltage_Rating 50V; MPN BSS138W-7-F; DigiKey_Part BSS138W-FDICT-ND
R44, R48, R50, R54: 10k; VISHAY-0402; Tolerance 1%; MPN CRCW040210K0FKEDC; DigiKey_Part 541-3959-1-ND
R45, R52, R245, R246: 100k; VISHAY-0402; Tolerance 1%; MPN CRCW0402100KFKEDC; DigiKey_Part 541-3960-1-ND
R46: 150k; VISHAY-0402; Tolerance 1%; MPN CRCW0402150KFKED; DigiKey_Part 541-150KLCT-ND
R47: 11k; VISHAY-0402; Tolerance 1%; MPN CRCW040211K0FKED; DigiKey_Part 541-11.0KLCT-ND
R49: 21k; VISHAY-0402; Tolerance 1%; MPN CRCW040221K0FKED; DigiKey_Part 541-21.0KLCT-ND
R51: 118k; VISHAY-0402; Tolerance 1%; MPN CRCW0402118KFKED; DigiKey_Part 541-118KLCT-ND
R53: 1k; VISHAY-0402; Tolerance 1%; MPN CRCW04021K00FKED; DigiKey_Part 541-1.00KLCT-ND
R68: 174k; VISHAY-0402; Tolerance 1%; MPN CRCW0402174KFKED; DigiKey_Part 541-174KLCT-ND
U10: TPS7A3901DSCR; TI-WSON-DSC0010J; MPN TPS7A3901DSCR; DigiKey_Part 296-TPS7A3901DSCRCT-ND
U11: TPS25200DRVR; TI-WSON-DRV0006A; MPN TPS25200DRVR; DigiKey_Part 296-37842-1-ND
U12: LM2776DBVR; TI-SOT23-DBV0006A; MPN LM2776DBVR; DigiKey_Part 296-43957-1-ND
U13: TPS70918DRVR; TI-WSON-DRV0006A; MPN TPS70918DRVR; DigiKey_Part 296-TPS70918DRVRCT-ND
U14: TLV431BIDBZR; NEXPERIA-SOT23; MPN TLV431BIDBZR; DigiKey_Part 296-17571-1-ND
U21: TPS2553DRVR; TI-WSON-DRV0006A; MPN TPS2553DRVR; DigiKey_Part 296-36006-1-ND

Connections:
3V3: C55.2, U21.4 (EN), U21.6 (IN); also elsewhere on the board
3V3_LIM: C57.2, C58.2, R44.2, U21.1 (OUT); also elsewhere on the board
5V: C31.2, D48.4 (IN), D48.5 (IN), D48.6 (IN), U11.6 (IN)
24V: F1.1
+1V8_CH: C38.2, U13.1 (OUT); also elsewhere on the board
+2V5_CH: C32.2, C35.2, D55.1 (0), Q10.2, R47.2, R51.2, R54.2, U10.10 (OUTP); also elsewhere on the board
+5V_CH: C34.2, C37.2, D55.2 (1), Q25.1, U10.1 (INP), U10.2 (EN), U11.1 (OUT), U12.3 (VIN), U12.4 (EN), U13.4 (EN), U13.6 (IN); also elsewhere on the board
+24V_CH: Q24.3; also elsewhere on the board
-2V5_CH: C33.1, C36.1, D56.2 (1), R49.1, U10.6 (OUTN); also elsewhere on the board
-5V_CH: C40.1, C42.1, D56.1 (0), D57.1 (0), U10.5 (INN), U12.1 (VOUT); also elsewhere on the board
/fpga/ADC_EN: R45.2, U11.4 (EN); also elsewhere on the board
/fpga/ADC_FLT: R44.1, U11.3 (~FAULT); also elsewhere on the board
GND: C30.1, C31.1, C34.1, C35.1, C36.2, C37.1, C38.1, C40.2, C42.2, C55.1, C57.1, C58.1, C169.1, D47.1 (GND), D47.2 (GND), D47.3 (GND), D47.7 (PAD), D48.1 (GND), D48.2 (GND), D48.3 (GND), D48.7 (PAD), D57.2 (1), Q10.3, Q25.2, R45.1, R46.1, R50.1, R52.1, R68.1, U10.4 (GND), U10.11 (PAD), U11.5 (GND), U11.7 (PAD), U12.2 (GND), U13.3 (GND), U13.7 (GND), U13.[3,7] (GND), U14.3 (A), U21.5 (GND), U21.7 (PAD); also elsewhere on the board
unnamed: C174.1, D54.1 (0), Q24.1, R245.1, R246.2
unnamed: C169.2, C174.2, D47.4 (IN), D47.5 (IN), D47.6 (IN), D54.2 (1), F1.2, Q24.2, R245.2
unnamed: Q10.1, R53.1, R54.1
unnamed: Q25.3, R246.1
unnamed: R48.2, U10.8 (BUF)
unnamed: C33.2, R48.1, R49.2, U10.7 (FBN)
unnamed: C32.1, R47.1, R50.2, U10.9 (FBP)
unnamed: C30.2, U10.3 (NR/SS)
unnamed: R46.2, U11.2 (ILIM)
unnamed: C150.2, U12.5 (C1+)
unnamed: C150.1, U12.6 (C1-)
unnamed: R53.2, U14.2 (K)
unnamed: R51.1, R52.2, U14.1 (REF)
unnamed: R68.2, U21.2 (ILIM)

Notes on the sheet:
3V3 INPUT LIMIT
±2.5 V REGULATOR
5 V SUPPRESSOR
24 V SWITCH
1.8 V REGULATOR
24 V FUSE AND SUPPRESSOR
+2.5 V CLAMP
-5 V CHARGE PUMP
REGULATOR CLAMPS
CHANNEL EFUSE

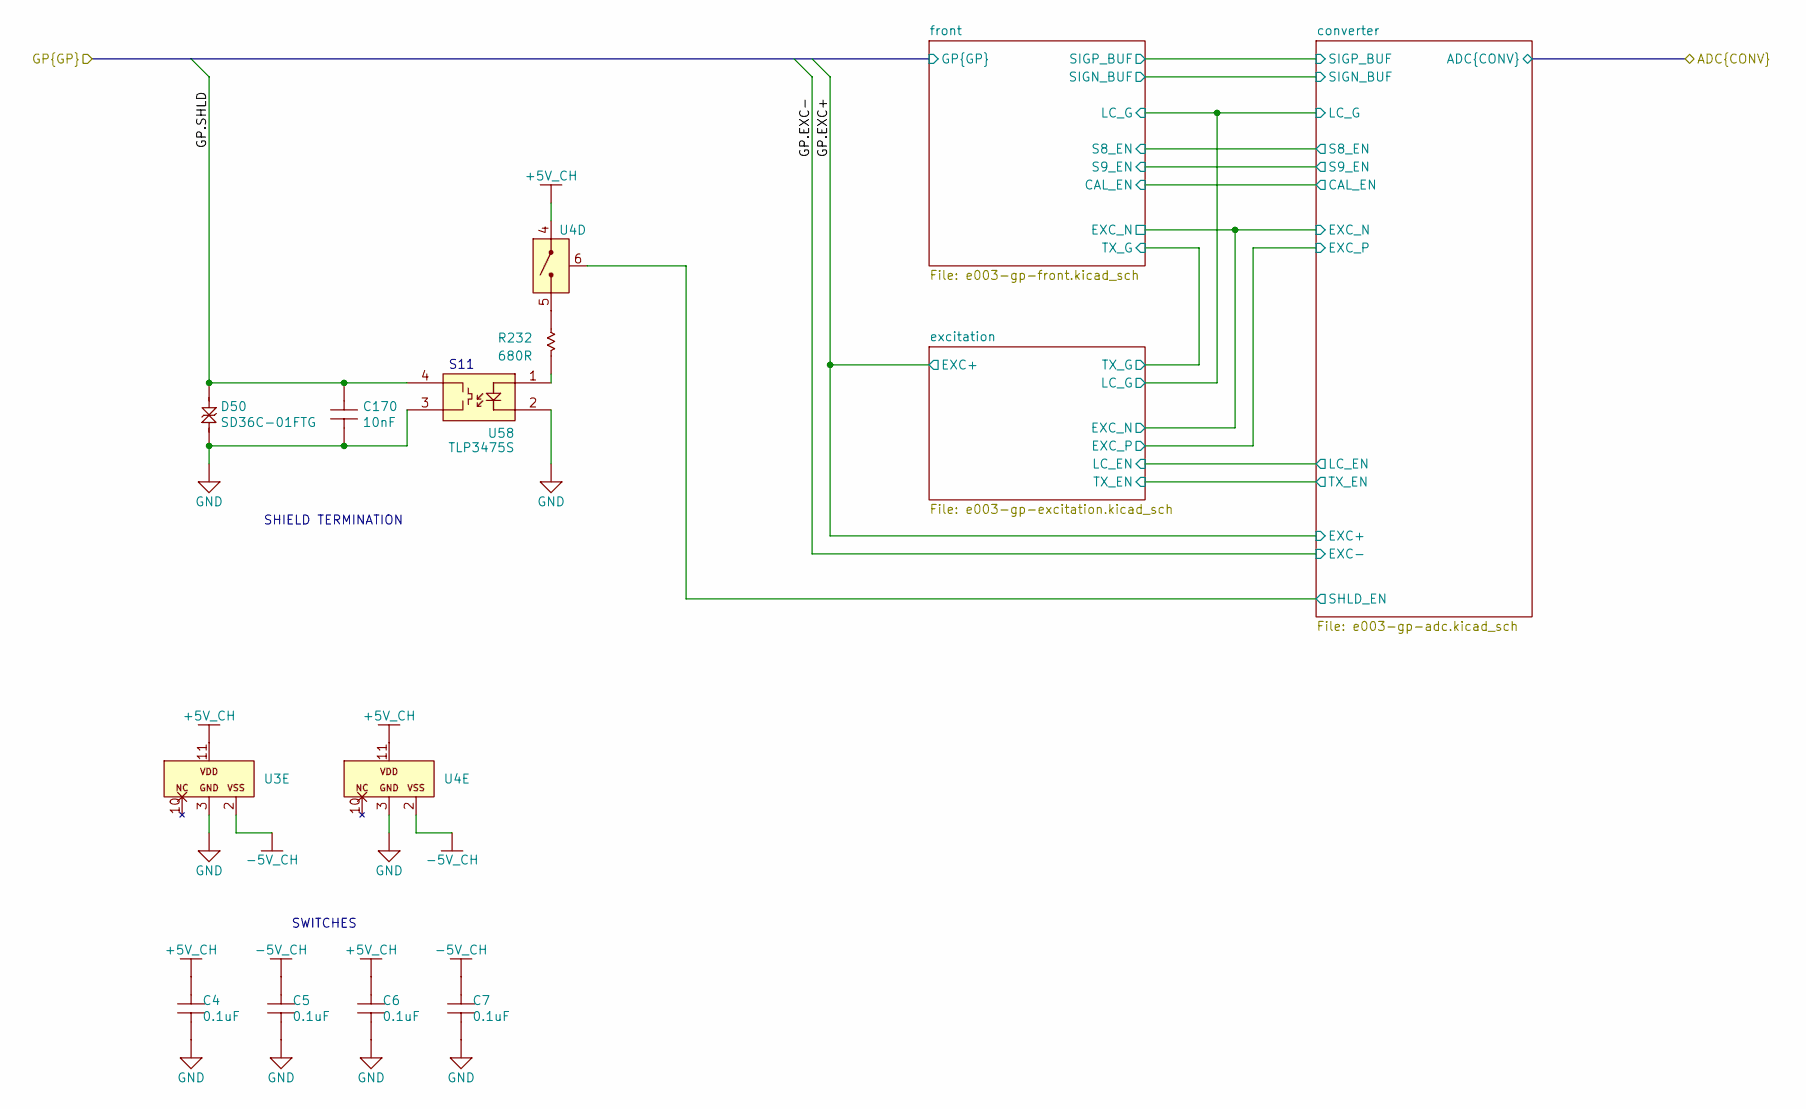
[picture p19: schematic e003-gp-channel.kicad_sch, ASRP ADC BOARD]

Parts:
C4, C5, C6, C7: 0.1uF; MURATA-0402; Tolerance 10%; Voltage_Rating 50 VDC; MPN GRM155R71H104KE14J; DigiKey_Part 490-13342-2-ND
C170: 10nF; MURATA-0805; Tolerance 10%; Voltage_Rating 250 VDC; MPN GRM21BR72E103KW03L; DigiKey_Part 490-3534-1-ND
D50: SD36C-01FTG; LITTELFUSE-SOD323; Voltage_Rating 36V; MPN SD36C-01FTG; DigiKey_Part F6448CT-ND
R232: 680R; VISHAY-0402; Tolerance 1%; MPN CRCW0402680RFKED; DigiKey_Part 541-680LCT-ND
U3, U4: TMUX6212RUMR; TI-WQFN-RUM0016E; MPN TMUX6212RUMR; DigiKey_Part 296-TMUX6212RUMRCT-ND
U58: TLP3475S; TOSHIBA-S-VSON4T; MPN TLP3475S; DigiKey_Part TLP3475S(TPECT-ND

Connections:
+5V_CH: C4.2, C6.2, U3.11 (VDD), U4.4 (S4), U4.11 (VDD); also elsewhere on the board
-5V_CH: C5.2, C7.2, U3.2 (VSS), U4.2 (VSS); also elsewhere on the board
/GP1.SHLD: C170.2, D50.1 (A1), U58.4 (D); also elsewhere on the board
/gp-ch1/converter/SHLD_EN: U4.6 (SEL4); also elsewhere on the board
GND: C4.1, C5.1, C6.1, C7.1, C170.1, D50.2 (A2), U3.3 (GND), U4.3 (GND), U58.2 (K), U58.3 (D); also elsewhere on the board
unnamed: R232.2, U4.5 (D4)
unnamed: R232.1, U58.1 (A)

Parts of its further copies:
C39, C41, C43, C44: 0.1uF; MURATA-0402; Tolerance 10%; Voltage_Rating 50 VDC; MPN GRM155R71H104KE14J; DigiKey_Part 490-13342-2-ND
C171: 10nF; MURATA-0805; Tolerance 10%; Voltage_Rating 250 VDC; MPN GRM21BR72E103KW03L; DigiKey_Part 490-3534-1-ND
D51: SD36C-01FTG; LITTELFUSE-SOD323; Voltage_Rating 36V; MPN SD36C-01FTG; DigiKey_Part F6448CT-ND
R233: 680R; VISHAY-0402; Tolerance 1%; MPN CRCW0402680RFKED; DigiKey_Part 541-680LCT-ND
U15, U29: TMUX6212RUMR; TI-WQFN-RUM0016E; MPN TMUX6212RUMR; DigiKey_Part 296-TMUX6212RUMRCT-ND
U59: TLP3475S; TOSHIBA-S-VSON4T; MPN TLP3475S; DigiKey_Part TLP3475S(TPECT-ND

Connections of its further copies:
+5V_CH: C39.2, C43.2, U15.1 (S1), U15.4 (S4), U15.9 (S3), U15.11 (VDD), U15.12 (S2), U29.4 (S4), U29.11 (VDD); also elsewhere on the board
-5V_CH: C41.2, C44.2, U15.2 (VSS), U29.2 (VSS); also elsewhere on the board
/GP2.EXC-: U29.1 (S1), U29.9 (S3); also elsewhere on the board
/GP2.SHLD: C171.2, D51.1 (A1), U59.4 (D); also elsewhere on the board
/gp-ch2/converter/CAL_EN: U29.7 (SEL3); also elsewhere on the board
/gp-ch2/converter/EXC_P: U29.12 (S2); also elsewhere on the board
/gp-ch2/converter/LC_EN: U29.6 (SEL4); also elsewhere on the board
/gp-ch2/converter/LC_G: U29.5 (D4); also elsewhere on the board
/gp-ch2/converter/PRT_EN: U29.15 (SEL1); also elsewhere on the board
/gp-ch2/converter/S8_EN: U15.14 (SEL2); also elsewhere on the board
/gp-ch2/converter/S9_EN: U15.7 (SEL3); also elsewhere on the board
/gp-ch2/converter/SHLD_EN: U15.6 (SEL4); also elsewhere on the board
/gp-ch2/converter/TX_EN: U15.15 (SEL1), U29.14 (SEL2); also elsewhere on the board
/gp-ch2/excitation/TX_G: U15.16 (D1); also elsewhere on the board
GND: C39.1, C41.1, C43.1, C44.1, C171.1, D51.2 (A2), U15.3 (GND), U29.3 (GND), U59.2 (K), U59.3 (D); also elsewhere on the board
unnamed 166: U15.13 (D2); also elsewhere on the board
unnamed 167: U15.8 (D3); also elsewhere on the board
unnamed: R233.2, U15.5 (D4)
unnamed 176: U29.13 (D2), U29.16 (D1); also elsewhere on the board
unnamed 177: U29.8 (D3); also elsewhere on the board
unnamed: R233.1, U59.1 (A)

Notes on the sheet:
SHIELD TERMINATION
S11
SWITCHES
