tnagyzambo/adc-board/e003-adc-board.kicad_pcb

## KiCad design e003-adc-board.kicad_pcb (continued)

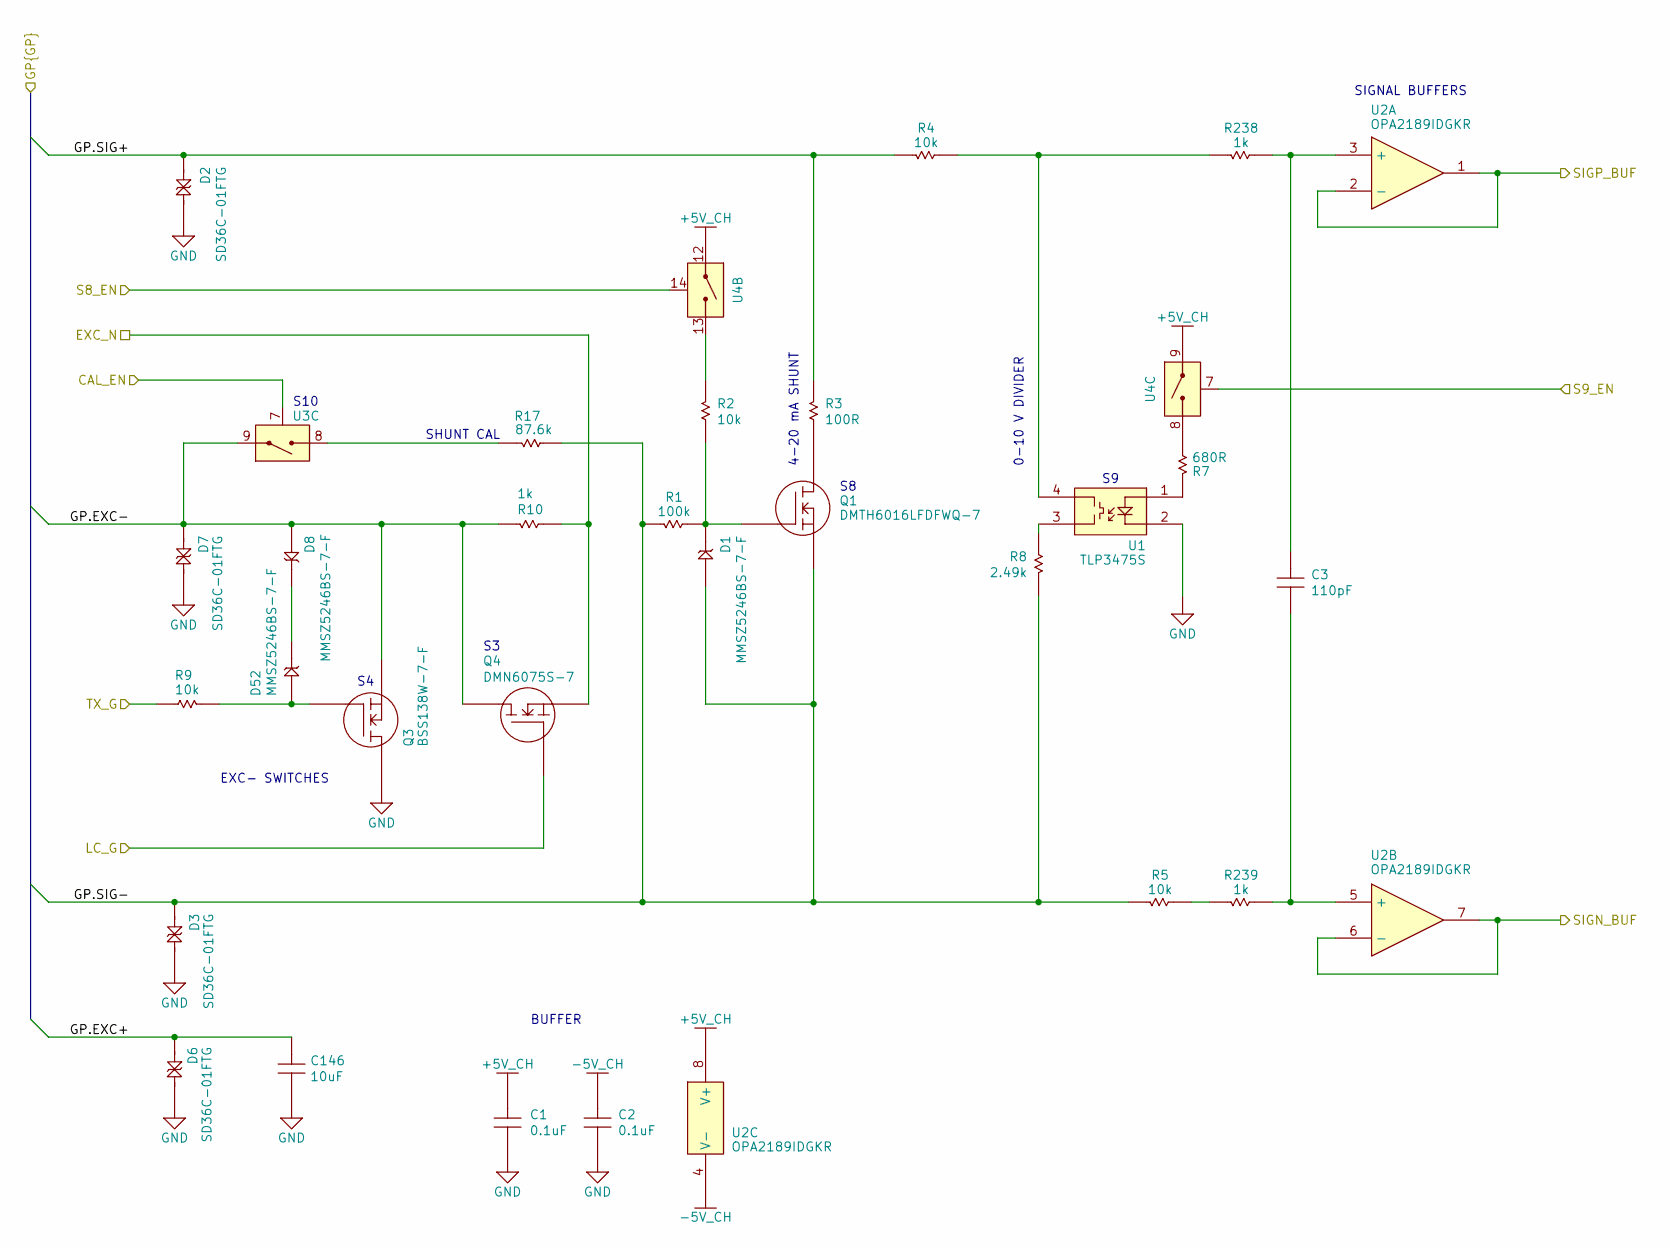
[picture p20: schematic e003-gp-front.kicad_sch, ASRP ADC BOARD]

Parts:
C1, C2: 0.1uF; MURATA-0402; Tolerance 10%; Voltage_Rating 50 VDC; MPN GRM155R71H104KE14J; DigiKey_Part 490-13342-2-ND
C3: 110pF; MURATA-0402; Tolerance 5%; Voltage_Rating 50 VDC; MPN GCM1555C1H111JA16D; DigiKey_Part 490-GCM1555C1H111JA16DCT-ND
C146: 10uF; MURATA-GRJ32-1210; Tolerance 10%; Voltage_Rating 50 VDC; MPN GRJ32ER71H106KE11; DigiKey_Part 490-10961-1-ND
D1, D8, D52: MMSZ5246BS-7-F; DIODES-SOD323; Voltage_Rating 16V; MPN MMSZ5246BS-7-F; DigiKey_Part MMSZ5246BS-FDICT-ND
D2, D3, D6, D7: SD36C-01FTG; LITTELFUSE-SOD323; Voltage_Rating 36V; MPN SD36C-01FTG; DigiKey_Part F6448CT-ND
Q1: DMTH6016LFDFWQ-7; DIODES-UDFN2020-6F; Voltage_Rating 60V; MPN DMTH6016LFDFWQ-7; DigiKey_Part DMTH6016LFDFWQ-7-ND
Q3: BSS138W-7-F; DIODES-SOT323; Voltage_Rating 50V; MPN BSS138W-7-F; DigiKey_Part BSS138W-FDICT-ND
Q4: DMN6075S-7; NEXPERIA-SOT23; Voltage_Rating 60V; MPN DMN6075S-7; DigiKey_Part DMN6075S-7DICT-ND
R1: 100k; VISHAY-0402; Tolerance 1%; MPN CRCW0402100KFKEDC; DigiKey_Part 541-3960-1-ND
R2, R9: 10k; VISHAY-0402; Tolerance 1%; MPN CRCW040210K0FKEDC; DigiKey_Part 541-3959-1-ND
R3: 100R; VISHAY-1206; Tolerance ±0.1%; MPN PHP01206E1000BST5; DigiKey_Part PHP100ACT-ND
R4: 10k; VISHAY-CRCW0805; Tolerance 0.05%; MPN TNPU080510K0AZEN00; DigiKey_Part TNPU10.0KABCT-ND
R5: 10k; VISHAY-CRCW0805; Tolerance 1%; MPN CRCW080510K0FKEA; DigiKey_Part 541-10.0KCCT-ND
R7: 680R; VISHAY-0402; Tolerance 1%; MPN CRCW0402680RFKED; DigiKey_Part 541-680LCT-ND
R8: 2.49k; VISHAY-1206; Tolerance 0.05%; MPN TNPU12062K49AZEN00; DigiKey_Part TNPU12062K49AZEN00-ND
R10: 1k; VISHAY-1206; Tolerance ±0.1%; MPN PHP01206E1001BST5; DigiKey_Part PHP1.00KACT-ND
R17: 87.6k; VISHAY-CRCW0805; Tolerance 0.1%; MPN TNPU080587K6BZEN00; DigiKey_Part none
R238, R239: 1k; VISHAY-0402; Tolerance 1%; MPN CRCW04021K00FKED; DigiKey_Part 541-1.00KLCT-ND
U1: TLP3475S; TOSHIBA-S-VSON4T; MPN TLP3475S; DigiKey_Part TLP3475S(TPECT-ND
U2: OPA2189IDGKR; TI-VSSOP-DGK0008A; MPN OPA2189IDGKR; DigiKey_Part 296-OPA2189IDGKRCT-ND
U3, U4: TMUX6212RUMR; TI-WQFN-RUM0016E; MPN TMUX6212RUMR; DigiKey_Part 296-TMUX6212RUMRCT-ND

Connections:
+5V_CH: C1.2, U2.8 (V+), U4.9 (S3), U4.12 (S2); also elsewhere on the board
-5V_CH: C2.2, U2.4 (V-); also elsewhere on the board
/GP1.EXC+: C146.2, D6.1 (A1); also elsewhere on the board
/GP1.EXC-: D7.1 (A1), D8.1 (0), Q3.2, Q4.3, R10.2, U3.9 (S3); also elsewhere on the board
/GP1.SIG+: D2.1 (A1), R3.2, R4.2; also elsewhere on the board
/GP1.SIG-: D1.1 (0), D3.1 (A1), Q1.2, R1.2, R5.2, R8.1, R17.2; also elsewhere on the board
/gp-ch1/converter/CAL_EN: U3.7 (SEL3); also elsewhere on the board
/gp-ch1/converter/EXC_N: Q4.2, R10.1; also elsewhere on the board
/gp-ch1/converter/LC_G: Q4.1; also elsewhere on the board
/gp-ch1/converter/S8_EN: U4.14 (SEL2); also elsewhere on the board
/gp-ch1/converter/S9_EN: U4.7 (SEL3); also elsewhere on the board
/gp-ch1/converter/SIGN_BUF: U2.6 (-), U2.7; also elsewhere on the board
/gp-ch1/converter/SIGP_BUF: U2.1, U2.2 (-); also elsewhere on the board
/gp-ch1/excitation/TX_G: R9.2; also elsewhere on the board
GND: C1.1, C2.1, C146.1, D2.2 (A2), D3.2 (A2), D6.2 (A2), D7.2 (A2), Q3.3, U1.2 (K); also elsewhere on the board
unnamed: D1.2 (1), Q1.1, R1.1, R2.1
unnamed: D52.1 (0), Q3.1, R9.1
unnamed: D8.2 (1), D52.2 (1)
unnamed: Q1.3, R3.1
unnamed: R8.2, U1.3 (D)
unnamed: R4.1, R238.2, U1.4 (D)
unnamed: R5.1, R239.2
unnamed: R7.1, U1.1 (A)
unnamed: C3.2, R238.1, U2.3 (+)
unnamed: C3.1, R239.1, U2.5 (+)
unnamed: R17.1, U3.8 (D3)
unnamed: R2.2, U4.13 (D2)
unnamed: R7.2, U4.8 (D3)

Parts of its further copies:
C59, C60: 0.1uF; MURATA-0402; Tolerance 10%; Voltage_Rating 50 VDC; MPN GRM155R71H104KE14J; DigiKey_Part 490-13342-2-ND
C61: 110pF; MURATA-0402; Tolerance 5%; Voltage_Rating 50 VDC; MPN GCM1555C1H111JA16D; DigiKey_Part 490-GCM1555C1H111JA16DCT-ND
C147: 10uF; MURATA-GRJ32-1210; Tolerance 10%; Voltage_Rating 50 VDC; MPN GRJ32ER71H106KE11; DigiKey_Part 490-10961-1-ND
D16, D23, D53: MMSZ5246BS-7-F; DIODES-SOD323; Voltage_Rating 16V; MPN MMSZ5246BS-7-F; DigiKey_Part MMSZ5246BS-FDICT-ND
D17, D18, D21, D22: SD36C-01FTG; LITTELFUSE-SOD323; Voltage_Rating 36V; MPN SD36C-01FTG; DigiKey_Part F6448CT-ND
Q11: DMTH6016LFDFWQ-7; DIODES-UDFN2020-6F; Voltage_Rating 60V; MPN DMTH6016LFDFWQ-7; DigiKey_Part DMTH6016LFDFWQ-7-ND
Q13: BSS138W-7-F; DIODES-SOT323; Voltage_Rating 50V; MPN BSS138W-7-F; DigiKey_Part BSS138W-FDICT-ND
Q14: DMN6075S-7; NEXPERIA-SOT23; Voltage_Rating 60V; MPN DMN6075S-7; DigiKey_Part DMN6075S-7DICT-ND
R72: 100k; VISHAY-0402; Tolerance 1%; MPN CRCW0402100KFKEDC; DigiKey_Part 541-3960-1-ND
R73, R80: 10k; VISHAY-0402; Tolerance 1%; MPN CRCW040210K0FKEDC; DigiKey_Part 541-3959-1-ND
R74: 100R; VISHAY-1206; Tolerance ±0.1%; MPN PHP01206E1000BST5; DigiKey_Part PHP100ACT-ND
R75: 10k; VISHAY-CRCW0805; Tolerance 0.05%; MPN TNPU080510K0AZEN00; DigiKey_Part TNPU10.0KABCT-ND
R76: 10k; VISHAY-CRCW0805; Tolerance 1%; MPN CRCW080510K0FKEA; DigiKey_Part 541-10.0KCCT-ND
R78: 680R; VISHAY-0402; Tolerance 1%; MPN CRCW0402680RFKED; DigiKey_Part 541-680LCT-ND
R79: 2.49k; VISHAY-1206; Tolerance 0.05%; MPN TNPU12062K49AZEN00; DigiKey_Part TNPU12062K49AZEN00-ND
R81: 1k; VISHAY-1206; Tolerance ±0.1%; MPN PHP01206E1001BST5; DigiKey_Part PHP1.00KACT-ND
R108: 87.6k; VISHAY-CRCW0805; Tolerance 0.1%; MPN TNPU080587K6BZEN00; DigiKey_Part none
R240, R241: 1k; VISHAY-0402; Tolerance 1%; MPN CRCW04021K00FKED; DigiKey_Part 541-1.00KLCT-ND
U15, U29: TMUX6212RUMR; TI-WQFN-RUM0016E; MPN TMUX6212RUMR; DigiKey_Part 296-TMUX6212RUMRCT-ND
U23: TLP3475S; TOSHIBA-S-VSON4T; MPN TLP3475S; DigiKey_Part TLP3475S(TPECT-ND
U24: OPA2189IDGKR; TI-VSSOP-DGK0008A; MPN OPA2189IDGKR; DigiKey_Part 296-OPA2189IDGKRCT-ND

Connections of its further copies:
+5V_CH: C59.2, U15.1 (S1), U15.4 (S4), U15.9 (S3), U15.11 (VDD), U15.12 (S2), U24.8 (V+), U29.4 (S4), U29.11 (VDD); also elsewhere on the board
-5V_CH: C60.2, U15.2 (VSS), U24.4 (V-), U29.2 (VSS); also elsewhere on the board
/GP2.EXC+: C147.2, D21.1 (A1); also elsewhere on the board
/GP2.EXC-: D22.1 (A1), D23.1 (0), Q13.2, Q14.3, R81.2, U29.1 (S1), U29.9 (S3); also elsewhere on the board
/GP2.SIG+: D17.1 (A1), R74.2, R75.2; also elsewhere on the board
/GP2.SIG-: D16.1 (0), D18.1 (A1), Q11.2, R72.2, R76.2, R79.1, R108.2; also elsewhere on the board
/gp-ch2/converter/CAL_EN: U29.7 (SEL3); also elsewhere on the board
/gp-ch2/converter/EXC_N: Q14.2, R81.1; also elsewhere on the board
/gp-ch2/converter/EXC_P: U29.12 (S2); also elsewhere on the board
/gp-ch2/converter/LC_EN: U29.6 (SEL4); also elsewhere on the board
/gp-ch2/converter/LC_G: Q14.1, U29.5 (D4); also elsewhere on the board
/gp-ch2/converter/PRT_EN: U29.15 (SEL1); also elsewhere on the board
/gp-ch2/converter/S8_EN: U15.14 (SEL2); also elsewhere on the board
/gp-ch2/converter/S9_EN: U15.7 (SEL3); also elsewhere on the board
/gp-ch2/converter/SHLD_EN: U15.6 (SEL4); also elsewhere on the board
/gp-ch2/converter/SIGN_BUF: U24.6 (-), U24.7; also elsewhere on the board
/gp-ch2/converter/SIGP_BUF: U24.1, U24.2 (-); also elsewhere on the board
/gp-ch2/converter/TX_EN: U15.15 (SEL1), U29.14 (SEL2); also elsewhere on the board
/gp-ch2/excitation/TX_G: R80.2, U15.16 (D1); also elsewhere on the board
GND: C59.1, C60.1, C147.1, D17.2 (A2), D18.2 (A2), D21.2 (A2), D22.2 (A2), Q13.3, U15.3 (GND), U23.2 (K), U29.3 (GND); also elsewhere on the board
unnamed: D16.2 (1), Q11.1, R72.1, R73.1
unnamed: D23.2 (1), D53.2 (1)
unnamed: D53.1 (0), Q13.1, R80.1
unnamed: Q11.3, R74.1
unnamed: R79.2, U23.3 (D)
unnamed: R75.1, R240.2, U23.4 (D)
unnamed: R76.1, R241.2
unnamed: R73.2, U15.13 (D2)
unnamed: R78.2, U15.8 (D3)
unnamed 168: U15.5 (D4); also elsewhere on the board
unnamed: R78.1, U23.1 (A)
unnamed: C61.2, R240.1, U24.3 (+)
unnamed: C61.1, R241.1, U24.5 (+)
unnamed 176: U29.13 (D2), U29.16 (D1); also elsewhere on the board
unnamed: R108.1, U29.8 (D3)

Notes on the sheet:
SHUNT CAL
BUFFER
0-10 V DIVIDER
EXC- SWITCHES
S10
4-20 mA SHUNT
SIGNAL BUFFERS

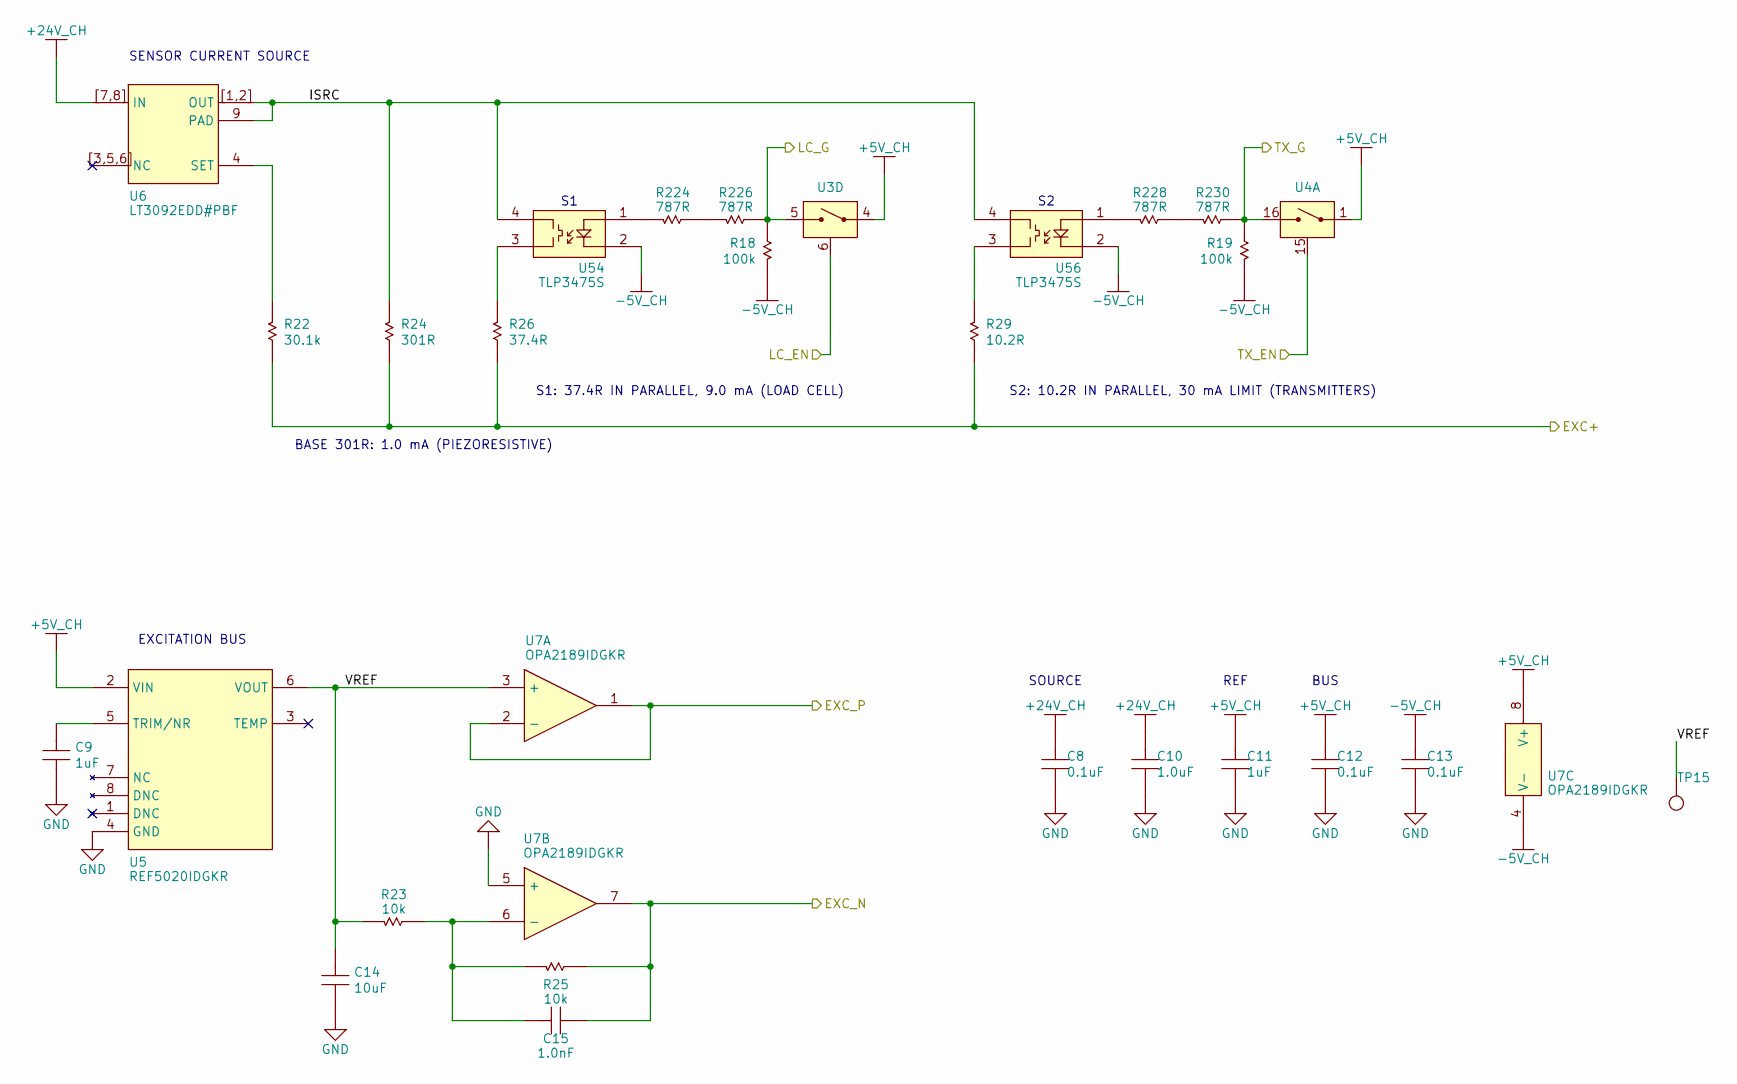
[picture p21: schematic e003-gp-excitation.kicad_sch, ASRP ADC BOARD]

Parts:
C8, C12, C13: 0.1uF; MURATA-0402; Tolerance 10%; Voltage_Rating 50 VDC; MPN GRM155R71H104KE14J; DigiKey_Part 490-13342-2-ND
C9, C11: 1uF; MURATA-0402; Tolerance 10%; Voltage_Rating 10 VDC; MPN GRM155Z71A105KE01D; DigiKey_Part 490-GRM155Z71A105KE01DCT-ND
C10: 1.0uF; MURATA-0805; Tolerance 10%; Voltage_Rating 50 VDC; MPN GCJ21BR71H105KA01L; DigiKey_Part 490-10667-1-ND
C14: 10uF; MURATA-0805; Tolerance 10%; Voltage_Rating 25 VDC; MPN GRM21BZ71E106KE15K; DigiKey_Part 490-GRM21BZ71E106KE15KCT-ND
C15: 1.0nF; MURATA-0402; Tolerance 5%; Voltage_Rating 50 VDC; MPN GRM1555C1H102JA01D; DigiKey_Part 490-3244-1-ND
R18, R19: 100k; VISHAY-0402; Tolerance 1%; MPN CRCW0402100KFKEDC; DigiKey_Part 541-3960-1-ND
R22: 30.1k; VISHAY-0402; Tolerance 1%; MPN CRCW040230K1FKED; DigiKey_Part 541-30.1KLCT-ND
R23, R25: 10k; VISHAY-CRCW0805; Tolerance 0.05%; MPN TNPU080510K0AZEN00; DigiKey_Part TNPU10.0KABCT-ND
R24: 301R; VISHAY-0402; Tolerance 1%; MPN CRCW0402301RFKED; DigiKey_Part 541-301LCT-ND
R26: 37.4R; VISHAY-0402; Tolerance 1%; MPN CRCW040237R4FKED; DigiKey_Part 541-37.4LCT-ND
R29: 10.2R; VISHAY-0402; Tolerance 1%; MPN CRCW040210R2FKED; DigiKey_Part 541-10.2LCT-ND
R224, R226, R228, R230: 787R; VISHAY-0402; Tolerance 1%; MPN CRCW0402787RFKEDC; DigiKey_Part 541-5082-2-ND
TP15: PCB-TEST-POINT; PCB-PROBEPOINT; MPN N/A
U3, U4: TMUX6212RUMR; TI-WQFN-RUM0016E; MPN TMUX6212RUMR; DigiKey_Part 296-TMUX6212RUMRCT-ND
U5: REF5020IDGKR; TI-VSSOP-DGK0008A; MPN REF5020IDGKR; DigiKey_Part 296-REF5020IDGKRCT-ND
U6: LT3092EDD#PBF; ADI-DFN-DD8; MPN LT3092EDD#PBF; DigiKey_Part 505-LT3092EDD#PBF-ND
U7: OPA2189IDGKR; TI-VSSOP-DGK0008A; MPN OPA2189IDGKR; DigiKey_Part 296-OPA2189IDGKRCT-ND
U54, U56: TLP3475S; TOSHIBA-S-VSON4T; MPN TLP3475S; DigiKey_Part TLP3475S(TPECT-ND

Connections:
+5V_CH: C11.2, C12.2, U3.4 (S4), U4.1 (S1), U5.2 (VIN), U7.8 (V+); also elsewhere on the board
+24V_CH: C8.2, C10.2, U6.7 (IN), U6.8 (IN), U6.[7,8] (IN); also elsewhere on the board
-5V_CH: C13.2, R18.1, R19.1, U7.4 (V-), U54.2 (K), U56.2 (K); also elsewhere on the board
/GP1.EXC+: R22.1, R24.1, R26.1, R29.1; also elsewhere on the board
/gp-ch1/converter/EXC_N: C15.1, R25.1, U7.7; also elsewhere on the board
/gp-ch1/converter/EXC_P: U7.1, U7.2 (-); also elsewhere on the board
/gp-ch1/converter/LC_EN: U3.6 (SEL4); also elsewhere on the board
/gp-ch1/converter/LC_G: R18.2, R226.1, U3.5 (D4); also elsewhere on the board
/gp-ch1/converter/TX_EN: U4.15 (SEL1); also elsewhere on the board
/gp-ch1/excitation/ISRC: R24.2, U6.1 (OUT), U6.2 (OUT), U6.9 (PAD), U6.[1,2] (OUT), U54.4 (D), U56.4 (D)
/gp-ch1/excitation/TX_G: R19.2, R230.1, U4.16 (D1); also elsewhere on the board
/gp-ch1/excitation/VREF: C14.2, R23.2, TP15.1 (0_1), U5.6 (VOUT), U7.3 (+)
GND: C8.1, C9.1, C10.1, C11.1, C12.1, C13.1, C14.1, U5.4 (GND), U7.5 (+); also elsewhere on the board
unnamed: R26.2, U54.3 (D)
unnamed: R29.2, U56.3 (D)
unnamed: R224.1, R226.2
unnamed: R228.1, R230.2
unnamed: C9.2, U5.5 (TRIM/NR)
unnamed: R22.2, U6.4 (SET)
unnamed: C15.2, R23.1, R25.2, U7.6 (-)
unnamed: R224.2, U54.1 (A)
unnamed: R228.2, U56.1 (A)

Parts of its further copies:
C80, C84, C85: 0.1uF; MURATA-0402; Tolerance 10%; Voltage_Rating 50 VDC; MPN GRM155R71H104KE14J; DigiKey_Part 490-13342-2-ND
C82: 1.0uF; MURATA-0805; Tolerance 10%; Voltage_Rating 50 VDC; MPN GCJ21BR71H105KA01L; DigiKey_Part 490-10667-1-ND
C87: 1.0nF; MURATA-0402; Tolerance 5%; Voltage_Rating 50 VDC; MPN GRM1555C1H102JA01D; DigiKey_Part 490-3244-1-ND
C166: 10uF; MURATA-0805; Tolerance 10%; Voltage_Rating 25 VDC; MPN GRM21BZ71E106KE15K; DigiKey_Part 490-GRM21BZ71E106KE15KCT-ND
C167, C168: 1uF; MURATA-0402; Tolerance 10%; Voltage_Rating 10 VDC; MPN GRM155Z71A105KE01D; DigiKey_Part 490-GRM155Z71A105KE01DCT-ND
R27, R28: 100k; VISHAY-0402; Tolerance 1%; MPN CRCW0402100KFKEDC; DigiKey_Part 541-3960-1-ND
R135: 30.1k; VISHAY-0402; Tolerance 1%; MPN CRCW040230K1FKED; DigiKey_Part 541-30.1KLCT-ND
R136, R138: 10k; VISHAY-CRCW0805; Tolerance 0.05%; MPN TNPU080510K0AZEN00; DigiKey_Part TNPU10.0KABCT-ND
R137: 301R; VISHAY-0402; Tolerance 1%; MPN CRCW0402301RFKED; DigiKey_Part 541-301LCT-ND
R139: 37.4R; VISHAY-0402; Tolerance 1%; MPN CRCW040237R4FKED; DigiKey_Part 541-37.4LCT-ND
R142: 10.2R; VISHAY-0402; Tolerance 1%; MPN CRCW040210R2FKED; DigiKey_Part 541-10.2LCT-ND
R225, R227, R229, R231: 787R; VISHAY-0402; Tolerance 1%; MPN CRCW0402787RFKEDC; DigiKey_Part 541-5082-2-ND
TP16: PCB-TEST-POINT; PCB-PROBEPOINT; MPN N/A
U15, U29: TMUX6212RUMR; TI-WQFN-RUM0016E; MPN TMUX6212RUMR; DigiKey_Part 296-TMUX6212RUMRCT-ND
U36: LT3092EDD#PBF; ADI-DFN-DD8; MPN LT3092EDD#PBF; DigiKey_Part 505-LT3092EDD#PBF-ND
U37: OPA2189IDGKR; TI-VSSOP-DGK0008A; MPN OPA2189IDGKR; DigiKey_Part 296-OPA2189IDGKRCT-ND
U53: REF5020IDGKR; TI-VSSOP-DGK0008A; MPN REF5020IDGKR; DigiKey_Part 296-REF5020IDGKRCT-ND
U55, U57: TLP3475S; TOSHIBA-S-VSON4T; MPN TLP3475S; DigiKey_Part TLP3475S(TPECT-ND

Connections of its further copies:
+5V_CH: C84.2, C167.2, U15.1 (S1), U15.4 (S4), U15.9 (S3), U15.11 (VDD), U15.12 (S2), U29.4 (S4), U29.11 (VDD), U37.8 (V+), U53.2 (VIN); also elsewhere on the board
+24V_CH: C80.2, C82.2, U36.7 (IN), U36.8 (IN); also elsewhere on the board
-5V_CH: C85.2, R27.1, R28.1, U15.2 (VSS), U29.2 (VSS), U37.4 (V-), U55.2 (K), U57.2 (K); also elsewhere on the board
/GP2.EXC+: R135.1, R137.1, R139.1, R142.1; also elsewhere on the board
/GP2.EXC-: U29.1 (S1), U29.9 (S3); also elsewhere on the board
/gp-ch2/converter/CAL_EN: U29.7 (SEL3); also elsewhere on the board
/gp-ch2/converter/EXC_N: C87.1, R138.1, U37.7; also elsewhere on the board
/gp-ch2/converter/EXC_P: U29.12 (S2), U37.1, U37.2 (-); also elsewhere on the board
/gp-ch2/converter/LC_EN: U29.6 (SEL4); also elsewhere on the board
/gp-ch2/converter/LC_G: R27.2, R227.1, U29.5 (D4); also elsewhere on the board
/gp-ch2/converter/PRT_EN: U29.15 (SEL1); also elsewhere on the board
/gp-ch2/converter/S8_EN: U15.14 (SEL2); also elsewhere on the board
/gp-ch2/converter/S9_EN: U15.7 (SEL3); also elsewhere on the board
/gp-ch2/converter/SHLD_EN: U15.6 (SEL4); also elsewhere on the board
/gp-ch2/converter/TX_EN: U15.15 (SEL1), U29.14 (SEL2); also elsewhere on the board
/gp-ch2/excitation/ISRC: R137.2, U36.1 (OUT), U36.2 (OUT), U36.9 (PAD), U55.4 (D), U57.4 (D)
/gp-ch2/excitation/TX_G: R28.2, R231.1, U15.16 (D1); also elsewhere on the board
/gp-ch2/excitation/VREF: C166.2, R136.2, TP16.1 (0_1), U37.3 (+), U53.6 (VOUT)
GND: C80.1, C82.1, C84.1, C85.1, C166.1, C167.1, C168.1, U15.3 (GND), U29.3 (GND), U37.5 (+), U53.4 (GND); also elsewhere on the board
unnamed: R139.2, U55.3 (D)
unnamed: R142.2, U57.3 (D)
unnamed: R225.1, R227.2
unnamed: R229.1, R231.2
unnamed 166: U15.13 (D2); also elsewhere on the board
unnamed 167: U15.8 (D3); also elsewhere on the board
unnamed 168: U15.5 (D4); also elsewhere on the board
unnamed 176: U29.13 (D2), U29.16 (D1); also elsewhere on the board
unnamed 177: U29.8 (D3); also elsewhere on the board
unnamed: R135.2, U36.4 (SET)
unnamed: C87.2, R136.1, R138.2, U37.6 (-)
unnamed: C168.2, U53.5 (TRIM/NR)
unnamed: R225.2, U55.1 (A)
unnamed: R229.2, U57.1 (A)

Notes on the sheet:
S1: 37.4R IN PARALLEL, 9.0 mA (LOAD CELL)
SOURCE
REF
BASE 301R: 1.0 mA (PIEZORESISTIVE)
SENSOR CURRENT SOURCE
S2: 10.2R IN PARALLEL, 30 mA LIMIT (TRANSMITTERS)
BUS
EXCITATION BUS

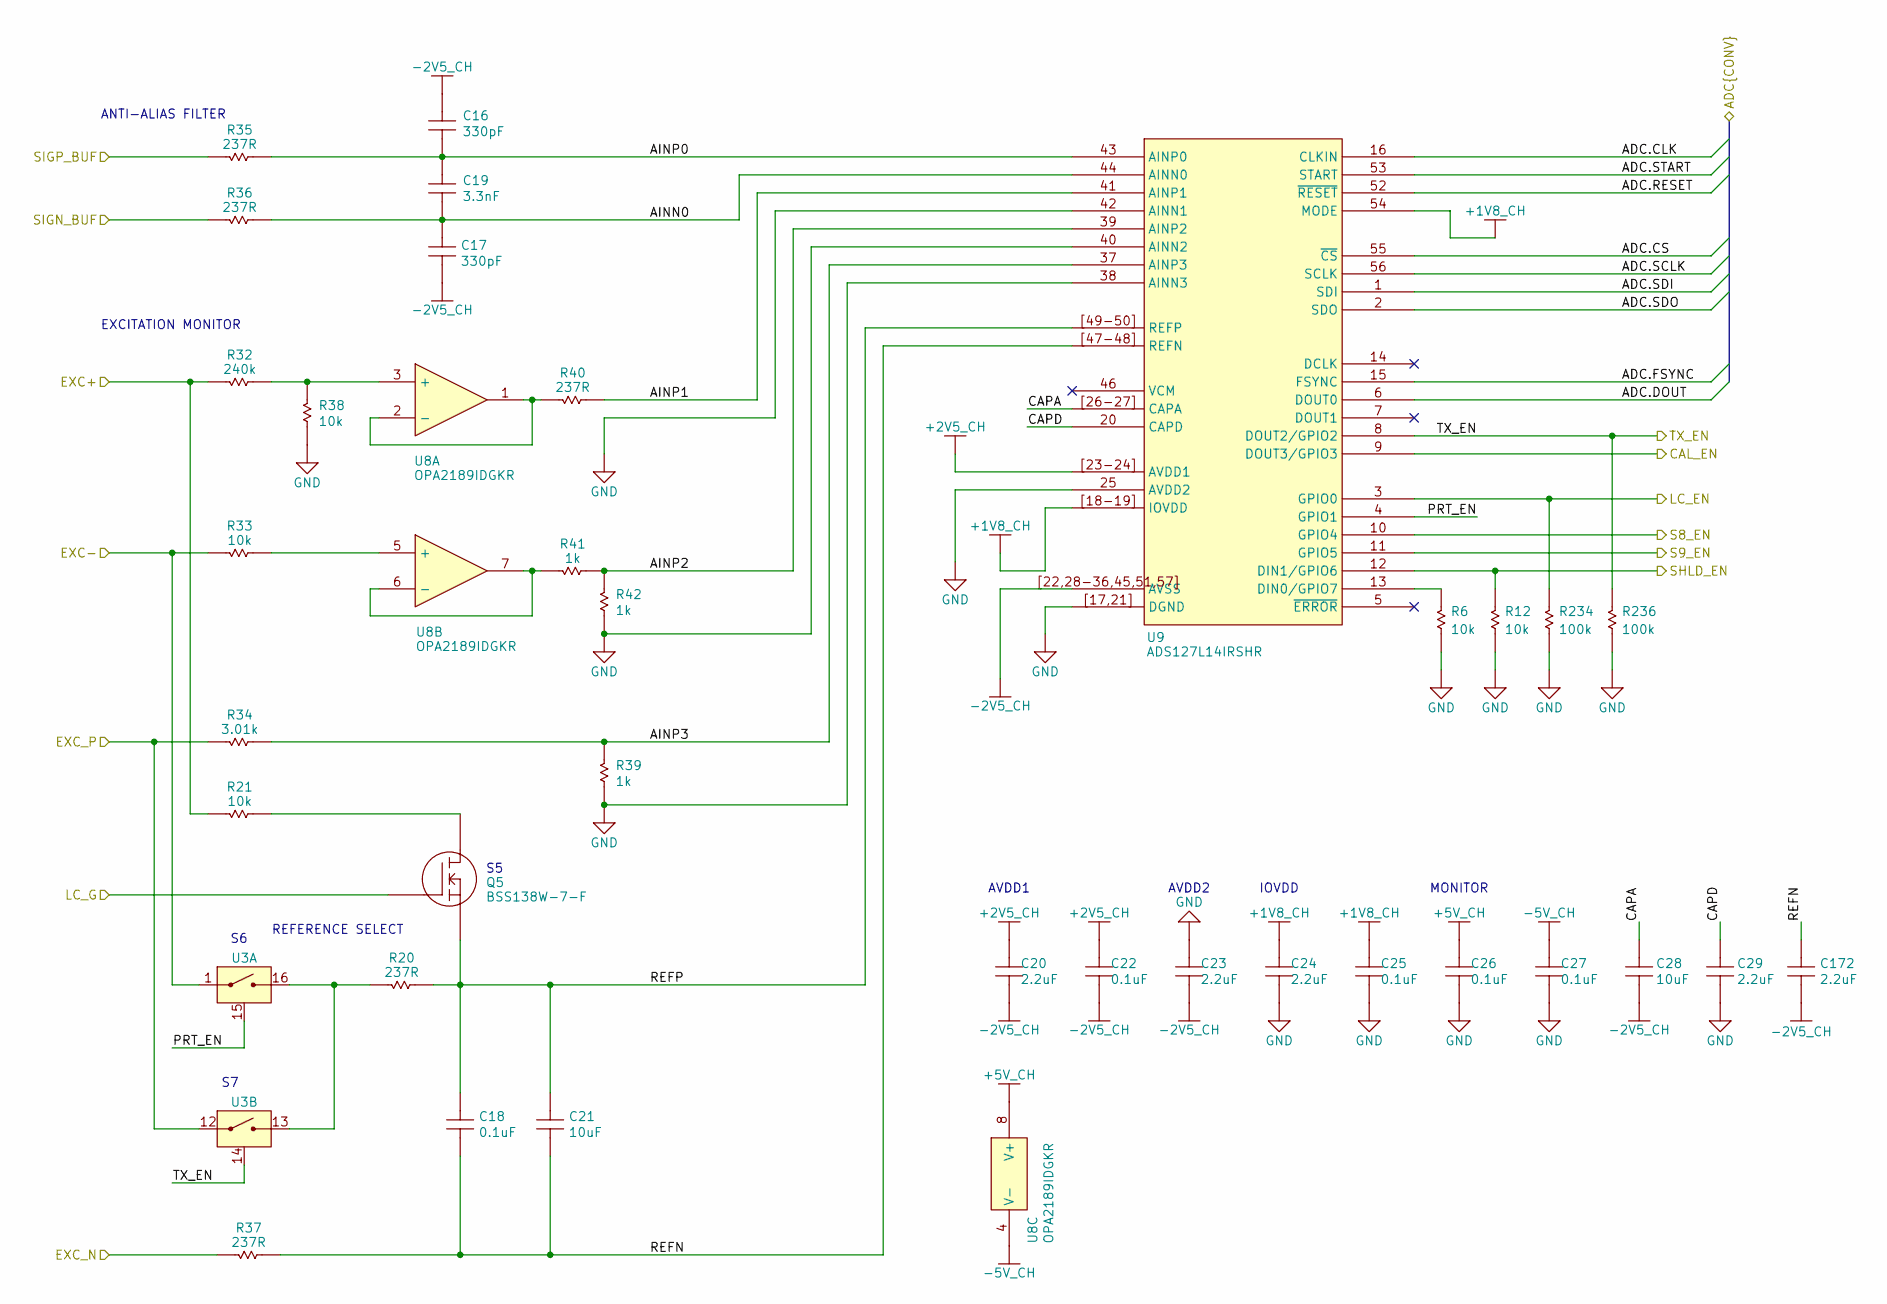
[picture p22: schematic e003-gp-adc.kicad_sch, ASRP ADC BOARD]

Parts:
C16, C17: 330pF; MURATA-0402; Tolerance 5%; Voltage_Rating 50 VDC; MPN GRM1555C1H331JA01D; DigiKey_Part 490-1295-1-ND
C18, C22, C25, C26, C27: 0.1uF; MURATA-0402; Tolerance 10%; Voltage_Rating 50 VDC; MPN GRM155R71H104KE14J; DigiKey_Part 490-13342-2-ND
C19: 3.3nF; MURATA-0402; Tolerance 5%; Voltage_Rating 50 VDC; MPN GRM1555C1H332JE01J; DigiKey_Part 490-GRM1555C1H332JE01JCT-ND
C20, C23, C24, C29, C172: 2.2uF; MURATA-0402; Tolerance 10%; Voltage_Rating 10 VDC; MPN GRM155Z71A225KE01J; DigiKey_Part 490-GRM155Z71A225KE01JCT-ND
C21, C28: 10uF; MURATA-0805; Tolerance 10%; Voltage_Rating 25 VDC; MPN GRM21BZ71E106KE15K; DigiKey_Part 490-GRM21BZ71E106KE15KCT-ND
Q5: BSS138W-7-F; DIODES-SOT323; Voltage_Rating 50V; MPN BSS138W-7-F; DigiKey_Part BSS138W-FDICT-ND
R6, R12, R21, R33: 10k; VISHAY-0402; Tolerance 1%; MPN CRCW040210K0FKEDC; DigiKey_Part 541-3959-1-ND
R20, R35, R36, R37, R40: 237R; VISHAY-0402; Tolerance 0.1%; MPN TNPW0402237RBEED; DigiKey_Part TNPW0402237RBEED-ND
R32: 240k; VISHAY-CRCW0805; Tolerance 0.1%; MPN TNPU0805240KBZEN00; DigiKey_Part TNPU0805240KBZEN00-ND
R34: 3.01k; VISHAY-0402; Tolerance 0.1%; MPN TNPU04023K01BZEP00; DigiKey_Part 541-TNPU04023K01BZEP00CT-ND
R38: 10k; VISHAY-0402; Tolerance 0.1%; MPN TNPU040210K0BZEP00; DigiKey_Part 541-TNPU040210K0BZEP00CT-ND
R39, R41, R42: 1k; VISHAY-0402; Tolerance 0.1%; MPN TNPU04021K00BZEP00; DigiKey_Part 541-TNPU04021K00BZEP00CT-ND
R234, R236: 100k; VISHAY-0402; Tolerance 1%; MPN CRCW0402100KFKEDC; DigiKey_Part 541-3960-1-ND
U3: TMUX6212RUMR; TI-WQFN-RUM0016E; MPN TMUX6212RUMR; DigiKey_Part 296-TMUX6212RUMRCT-ND
U8: OPA2189IDGKR; TI-VSSOP-DGK0008A; MPN OPA2189IDGKR; DigiKey_Part 296-OPA2189IDGKRCT-ND
U9: ADS127L14IRSHR; TI-VQFN-RSH0056G; MPN ADS127L14IRSHR; DigiKey_Part 296-ADS127L14IRSHRTR-ND

Connections:
+1V8_CH: C24.2, C25.2, U9.18 (IOVDD), U9.19 (IOVDD), U9.54 (MODE), U9.[18-19] (IOVDD); also elsewhere on the board
+2V5_CH: C20.2, C22.2, U9.23 (AVDD1), U9.24 (AVDD1), U9.[23-24] (AVDD1); also elsewhere on the board
+5V_CH: C26.2, U8.8 (V+); also elsewhere on the board
-2V5_CH: C16.2, C17.1, C20.1, C22.1, C23.1, C28.1, C172.1, U9.22 (AVSS), U9.28 (AVSS), U9.29 (AVSS), U9.30 (AVSS), U9.31 (AVSS), U9.32 (AVSS), U9.33 (AVSS), U9.34 (AVSS), U9.35 (AVSS), U9.36 (AVSS), U9.45 (AVSS), U9.51 (AVSS), U9.57 (AVSS), U9.[22,28-36,45,51,57] (AVSS); also elsewhere on the board
-5V_CH: C27.2, U8.4 (V-); also elsewhere on the board
/GP1.EXC+: R21.2, R32.2; also elsewhere on the board
/GP1.EXC-: R33.2, U3.1 (S1); also elsewhere on the board
/fpga/ADC1.CLK: U9.16 (CLKIN); also elsewhere on the board
/fpga/ADC1.CS: U9.55 (~CS); also elsewhere on the board
/fpga/ADC1.DOUT: U9.6 (DOUT0); also elsewhere on the board
/fpga/ADC1.FSYNC: U9.15 (FSYNC); also elsewhere on the board
/fpga/ADC1.RESET: U9.52 (~RESET); also elsewhere on the board
/fpga/ADC1.SCLK: U9.56 (SCLK); also elsewhere on the board
/fpga/ADC1.SDI: U9.1 (SDI); also elsewhere on the board
/fpga/ADC1.SDO: U9.2 (SDO); also elsewhere on the board
/fpga/ADC1.START: U9.53 (START); also elsewhere on the board
/gp-ch1/converter/AINN0: C17.2, C19.1, R36.1, U9.44 (AINN0)
/gp-ch1/converter/AINP0: C16.1, C19.2, R35.1, U9.43 (AINP0)
/gp-ch1/converter/AINP1: R40.1, U9.41 (AINP1)
/gp-ch1/converter/AINP2: R41.1, R42.2, U9.39 (AINP2)
/gp-ch1/converter/AINP3: R34.1, R39.2, U9.37 (AINP3)
/gp-ch1/converter/CAL_EN: U9.9 (DOUT3/GPIO3); also elsewhere on the board
/gp-ch1/converter/CAPA: C28.2, U9.26 (CAPA), U9.27 (CAPA), U9.[26-27] (CAPA)
/gp-ch1/converter/CAPD: C29.2, U9.20 (CAPD)
/gp-ch1/converter/EXC_N: R37.2; also elsewhere on the board
/gp-ch1/converter/EXC_P: R34.2, U3.12 (S2); also elsewhere on the board
/gp-ch1/converter/LC_EN: R234.2, U9.3 (GPIO0); also elsewhere on the board
/gp-ch1/converter/LC_G: Q5.1; also elsewhere on the board
/gp-ch1/converter/PRT_EN: U3.15 (SEL1), U9.4 (GPIO1)
/gp-ch1/converter/REFN: C18.1, C21.1, C172.2, R37.1, U9.47 (REFN), U9.48 (REFN), U9.[47-48] (REFN)
/gp-ch1/converter/REFP: C18.2, C21.2, Q5.2, R20.1, U9.49 (REFP), U9.50 (REFP), U9.[49-50] (REFP)
/gp-ch1/converter/S8_EN: U9.10 (GPIO4); also elsewhere on the board
/gp-ch1/converter/S9_EN: U9.11 (GPIO5); also elsewhere on the board
/gp-ch1/converter/SHLD_EN: R12.2, U9.12 (DIN1/GPIO6); also elsewhere on the board
/gp-ch1/converter/SIGN_BUF: R36.2; also elsewhere on the board
/gp-ch1/converter/SIGP_BUF: R35.2; also elsewhere on the board
/gp-ch1/converter/TX_EN: R236.2, U3.14 (SEL2), U9.8 (DOUT2/GPIO2); also elsewhere on the board
GND: C23.2, C24.1, C25.1, C26.1, C27.1, C29.1, R6.1, R12.1, R38.1, R39.1, R42.1, R234.1, R236.1, U9.17 (DGND), U9.21 (DGND), U9.25 (AVDD2), U9.38 (AINN3), U9.40 (AINN2), U9.42 (AINN1), U9.[17,21] (DGND); also elsewhere on the board
unnamed: Q5.3, R21.1
unnamed: R20.2, U3.13 (D2), U3.16 (D1)
unnamed: R32.1, R38.2, U8.3 (+)
unnamed: R40.2, U8.1, U8.2 (-)
unnamed: R33.1, U8.5 (+)
unnamed: R41.2, U8.6 (-), U8.7
unnamed: R6.2, U9.13 (DIN0/GPIO7)

Parts of its further copies:
C104, C105: 330pF; MURATA-0402; Tolerance 5%; Voltage_Rating 50 VDC; MPN GRM1555C1H331JA01D; DigiKey_Part 490-1295-1-ND
C106, C110, C113, C114, C115: 0.1uF; MURATA-0402; Tolerance 10%; Voltage_Rating 50 VDC; MPN GRM155R71H104KE14J; DigiKey_Part 490-13342-2-ND
C107: 3.3nF; MURATA-0402; Tolerance 5%; Voltage_Rating 50 VDC; MPN GRM1555C1H332JE01J; DigiKey_Part 490-GRM1555C1H332JE01JCT-ND
C108, C111, C112, C117, C173: 2.2uF; MURATA-0402; Tolerance 10%; Voltage_Rating 10 VDC; MPN GRM155Z71A225KE01J; DigiKey_Part 490-GRM155Z71A225KE01JCT-ND
C109, C116: 10uF; MURATA-0805; Tolerance 10%; Voltage_Rating 25 VDC; MPN GRM21BZ71E106KE15K; DigiKey_Part 490-GRM21BZ71E106KE15KCT-ND
Q23: BSS138W-7-F; DIODES-SOT323; Voltage_Rating 50V; MPN BSS138W-7-F; DigiKey_Part BSS138W-FDICT-ND
R11, R13, R112, R166: 10k; VISHAY-0402; Tolerance 1%; MPN CRCW040210K0FKEDC; DigiKey_Part 541-3959-1-ND
R111, R168, R169, R170, R173: 237R; VISHAY-0402; Tolerance 0.1%; MPN TNPW0402237RBEED; DigiKey_Part TNPW0402237RBEED-ND
R165: 240k; VISHAY-CRCW0805; Tolerance 0.1%; MPN TNPU0805240KBZEN00; DigiKey_Part TNPU0805240KBZEN00-ND
R167: 3.01k; VISHAY-0402; Tolerance 0.1%; MPN TNPU04023K01BZEP00; DigiKey_Part 541-TNPU04023K01BZEP00CT-ND
R171: 10k; VISHAY-0402; Tolerance 0.1%; MPN TNPU040210K0BZEP00; DigiKey_Part 541-TNPU040210K0BZEP00CT-ND
R172, R174, R175: 1k; VISHAY-0402; Tolerance 0.1%; MPN TNPU04021K00BZEP00; DigiKey_Part 541-TNPU04021K00BZEP00CT-ND
R235, R237: 100k; VISHAY-0402; Tolerance 1%; MPN CRCW0402100KFKEDC; DigiKey_Part 541-3960-1-ND
U29: TMUX6212RUMR; TI-WQFN-RUM0016E; MPN TMUX6212RUMR; DigiKey_Part 296-TMUX6212RUMRCT-ND
U44: OPA2189IDGKR; TI-VSSOP-DGK0008A; MPN OPA2189IDGKR; DigiKey_Part 296-OPA2189IDGKRCT-ND
U45: ADS127L14IRSHR; TI-VQFN-RSH0056G; MPN ADS127L14IRSHR; DigiKey_Part 296-ADS127L14IRSHRTR-ND

Connections of its further copies:
+1V8_CH: C112.2, C113.2, U45.18 (IOVDD), U45.19 (IOVDD), U45.54 (MODE); also elsewhere on the board
+2V5_CH: C108.2, C110.2, U45.23 (AVDD1), U45.24 (AVDD1); also elsewhere on the board
+5V_CH: C114.2, U29.4 (S4), U29.11 (VDD), U44.8 (V+); also elsewhere on the board
-2V5_CH: C104.2, C105.1, C108.1, C110.1, C111.1, C116.1, C173.1, U45.22 (AVSS), U45.28 (AVSS), U45.29 (AVSS), U45.30 (AVSS), U45.31 (AVSS), U45.32 (AVSS), U45.33 (AVSS), U45.34 (AVSS), U45.35 (AVSS), U45.36 (AVSS), U45.45 (AVSS), U45.51 (AVSS), U45.57 (AVSS); also elsewhere on the board
-5V_CH: C115.2, U29.2 (VSS), U44.4 (V-); also elsewhere on the board
/GP2.EXC+: R112.2, R165.2; also elsewhere on the board
/GP2.EXC-: R166.2, U29.1 (S1), U29.9 (S3); also elsewhere on the board
/fpga/ADC2.CLK: U45.16 (CLKIN); also elsewhere on the board
/fpga/ADC2.CS: U45.55 (~CS); also elsewhere on the board
/fpga/ADC2.DOUT: U45.6 (DOUT0); also elsewhere on the board
/fpga/ADC2.FSYNC: U45.15 (FSYNC); also elsewhere on the board
/fpga/ADC2.RESET: U45.52 (~RESET); also elsewhere on the board
/fpga/ADC2.SCLK: U45.56 (SCLK); also elsewhere on the board
/fpga/ADC2.SDI: U45.1 (SDI); also elsewhere on the board
/fpga/ADC2.SDO: U45.2 (SDO); also elsewhere on the board
/fpga/ADC2.START: U45.53 (START); also elsewhere on the board
/gp-ch2/converter/AINN0: C105.2, C107.1, R169.1, U45.44 (AINN0)
/gp-ch2/converter/AINP0: C104.1, C107.2, R168.1, U45.43 (AINP0)
/gp-ch2/converter/AINP1: R173.1, U45.41 (AINP1)
/gp-ch2/converter/AINP2: R174.1, R175.2, U45.39 (AINP2)
/gp-ch2/converter/AINP3: R167.1, R172.2, U45.37 (AINP3)
/gp-ch2/converter/CAL_EN: U29.7 (SEL3), U45.9 (DOUT3/GPIO3)
/gp-ch2/converter/CAPA: C116.2, U45.26 (CAPA), U45.27 (CAPA)
/gp-ch2/converter/CAPD: C117.2, U45.20 (CAPD)
/gp-ch2/converter/EXC_N: R170.2; also elsewhere on the board
/gp-ch2/converter/EXC_P: R167.2, U29.12 (S2); also elsewhere on the board
/gp-ch2/converter/LC_EN: R235.2, U29.6 (SEL4), U45.3 (GPIO0)
/gp-ch2/converter/LC_G: Q23.1, U29.5 (D4); also elsewhere on the board
/gp-ch2/converter/PRT_EN: U29.15 (SEL1), U45.4 (GPIO1)
/gp-ch2/converter/REFN: C106.1, C109.1, C173.2, R170.1, U45.47 (REFN), U45.48 (REFN)
/gp-ch2/converter/REFP: C106.2, C109.2, Q23.2, R111.1, U45.49 (REFP), U45.50 (REFP)
/gp-ch2/converter/S8_EN: U45.10 (GPIO4); also elsewhere on the board
/gp-ch2/converter/S9_EN: U45.11 (GPIO5); also elsewhere on the board
/gp-ch2/converter/SHLD_EN: R13.2, U45.12 (DIN1/GPIO6); also elsewhere on the board
/gp-ch2/converter/SIGN_BUF: R169.2; also elsewhere on the board
/gp-ch2/converter/SIGP_BUF: R168.2; also elsewhere on the board
/gp-ch2/converter/TX_EN: R237.2, U29.14 (SEL2), U45.8 (DOUT2/GPIO2); also elsewhere on the board
GND: C111.2, C112.1, C113.1, C114.1, C115.1, C117.1, R11.1, R13.1, R171.1, R172.1, R175.1, R235.1, R237.1, U29.3 (GND), U45.17 (DGND), U45.21 (DGND), U45.25 (AVDD2), U45.38 (AINN3), U45.40 (AINN2), U45.42 (AINN1); also elsewhere on the board
unnamed: Q23.3, R112.1
unnamed: R111.2, U29.13 (D2), U29.16 (D1)
unnamed 177: U29.8 (D3); also elsewhere on the board
unnamed: R165.1, R171.2, U44.3 (+)
unnamed: R173.2, U44.1, U44.2 (-)
unnamed: R166.1, U44.5 (+)
unnamed: R174.2, U44.6 (-), U44.7
unnamed: R11.2, U45.13 (DIN0/GPIO7)

Notes on the sheet:
REFERENCE SELECT
MONITOR
AVDD2
AVDD1
IOVDD
EXCITATION MONITOR
ANTI-ALIAS FILTER

Board: 2 copper layers, 301 parts (0 on the bottom side), 192 nets, no tracks yet.
