tnagyzambo/adc-board/(commit log)

2026-10-02 Repository scaffold
    The ADC board for the ASRP vehicle stack, set up to the conventions of
    e001-power-board: every file carries the e003 prefix, main holds released
    revisions only and dev everything in progress. There is no revision yet,
    so main carries only its initial commit, an empty README.
2026-10-02 Design summary scaffold
    doc-design/e003-design-summary.typ is a Typst report against the
    eng-report template, scaffolded by dcs init and brought into line with
    the e001 design summary: same front matter, and its section outline less
    the sections that were particular to the power board. Every section is
    TBD; no design has been done.
    There is no KiCad project yet, so the schematic, board and BOM tables in
    dcs.toml are commented out and the report carries no appendices. Both
    come back once the board is drawn.
2026-10-02 Design summary: purpose and requirements
    The summary and Purpose place the board in the ASRP ECU stack: eight
    general-purpose channels, configurable for load cells, 4-20 mA and
    voltage transmitters, and seven thermocouple channels, powered by
    e001-power-board and read and logged by the ECU MCU board.
    The Key Requirements table follows e001: REQ-1 to REQ-14, each
    "Device must" or, where the brief stated a preference, "Device
    should", with the two defined above the table. Interfaces not yet
    specified are sourced TBD. The README now describes the board and names
    the ECU stack.
2026-10-03 Design summary: architecture, interfaces and functional blocks
    The board becomes one stackable unit of four general-purpose and four
    thermocouple channels with their cold-junction sensor, up to three
    boards per stack. Each bank is its own isolated domain, so a sensor
    fault costs at most four channels. Requirements are revised to match:
    REQ-7 is now a 2 kHz general-purpose bandwidth, REQ-14 the single
    board, REQ-15 stacking.
    System Description adds the top-level architecture (Figure 1), the
    interfaces, and ASRP-PCB-INTERCONNECT-2: a 32-pin pass-through stacking
    bus carrying two SPI buses, a chip select and a continuously driven
    data-ready line per slot, the 8.192 MHz converter clock, START a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
2026-10-10 Initial schematic
    [e003-adc-board.kicad_sch, e003-gp-channel.kicad_sch, e003-gp-excitation.kicad_sch, e003-gp-isolation.kicad_sch, e003-gp-power.kicad_sch, e003-gp.kicad_sch, e003-stack.kicad_sch, e003-tc-inputs.kicad_sch]
2026-10-11 GP channel: input common-mode capacitors, shunt-calibration switch
    The ADS127L11 inputs gain 330 pF C0G from each pin to AVSS (C718,
    C719), a tenth of C702 as datasheet 9.3 recommends. They supply the
    common-mode part of each sample's charge and return it to AVSS, which
    powers the converter's sampling switches. With C702 the differential
    pole is now 97 kHz. Both are placeholders until a 330 pF C0G part has a
    library record.
    The design summary selects the ADG1402 in its 3 x 2 mm LFCSP as the
    shunt-calibration switch. It closes only while its input is low, so the
    default-high output of the ISO7741 leaves the bridge untouched when
    SHUNT_CAL floats or the stack side is unpowered. FW-6 has firmw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
    [e003-gp-channel.kicad_sch]
2026-10-11 GP channel: error budget, low-drift resistors, per-configuration schematics
    U704 is now the ADG1402BCPZ-REEL7 from the parts library, and its
    placeholder symbol leaves the e003 library. The transmitter supply is
    redrawn around the rearranged LT3092 symbol, with the same connections.
    The design summary gains a general-purpose error budget (section 3.2,
    Table IX): noise, nonlinearity and drift per 10 C for each
    configuration, from datasheet maxima. The buffers and protection raise
    the channel noise to 2.84 uV rms. Offset drift sets a load cell's
    accuracy, mostly the converter's input current through the 237 R pair
    and the buffers' bias current through the 10k protection, and FW-7 has
    firmware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
    [e003-gp-channel.kicad_sch, e003-gp-excitation.kicad_sch]
2026-10-14 TCs removed from project
    [e003-adc-board.kicad_sch, e003-stack.kicad_sch, e003-tc-inputs.kicad_sch, e003-tc.kicad_sch]
2026-10-18 FPGA architecture: GP channel redrawn, footprints, first board
    The design summary is rewritten for the FPGA and ADS127L14 architecture.
    Each general-purpose channel is its own isolated domain, with its own
    supply, excitation, converter and isolators, and an LCMXO2-4000HC on the
    stack side drives the four channels. Sections 2 and 3 are in prose. The
    interconnect is generalised to two SPI lanes with four chip selects
    each, SYNC_CLK, SYNC_START and power (INT-1 to INT-10), with throughput
    sized against the SAM V71. The gateware requirements are GW-1 to GW-9,
    REQ-15 adds the 28 V contact fault, and an SN74LVC244ARKSR buffers the
    board's connection to the interconnect.
    The schematic draws the ch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
    [e003-adc-board.kicad_pcb, e003-adc-board.kicad_sch, e003-gp-adc.kicad_sch, e003-gp-channel.kicad_sch, e003-gp-excitation.kicad_sch, e003-gp-front.kicad_sch, e003-gp-isolation.kicad_sch, e003-gp-power.kicad_sch]
2026-10-20 Two channels on the stack's ground, FPGA sheet, every part in the PLM
    The board now carries two general-purpose channels referenced to the
    stack's ground, with no isolation. Each channel keeps its own REF5020
    and its own nine lines to an LCMXO2-4000HC, one 1.8 V bank per
    converter, RESET included. The new FPGA sheet holds the FPGA, its
    W25Q16JV golden image and its configuration pull-ups; the stack sheet
    holds the interconnect, the SN74LVC244A bus buffer, the chip-select
    jumpers and the input protection. The reconfiguration timer is gone:
    the host reloads the FPGA with REFRESH through the persistent slave SPI
    port, and the board's chip select also drives the user SPI's select
    on PB7B (GW-9,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
    [e003-adc-board.kicad_pcb, e003-adc-board.kicad_sch, e003-fpga.kicad_sch, e003-gp-adc.kicad_sch, e003-gp-channel.kicad_sch, e003-gp-excitation.kicad_sch, e003-gp-front.kicad_sch, e003-gp-isolation.kicad_sch]
2026-10-27 24 V switched with the channel supply, regulator clamps, 1 W shunt, DC fault model
    - The sensors' 24 V reaches the current sources through Q24 (BSS84W) only
    while +5V_CH is up, so an unpowered channel is no longer fed through its
    sensor. Three BAT54WS clamp the TPS7A39's rails and the -5 V rail.
    - The 4-20 mA shunt (R3, R74) is a 1 W PHP01206E1000BST5, which survives a
    30 mA fault on top of the loop current. J1 carries plm record CE-CON-00008.
    - Z2 is the Tag-Connect for JTAG; the FPGA sheet is page 11.
    - Design summary: the above, five low-impedance paths in OI-5, negative
    faults, GW-3's transmitter limit, the error budget and the area estimate.
    - sim/fault: an ngspice DC fault swee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
    [e003-adc-board.kicad_sch, e003-fpga.kicad_sch, e003-gp-front.kicad_sch, e003-gp-power.kicad_sch]
2026-10-27 Open issues: OI-1 and OI-3 to OI-6 removed
    The 24 V on the interconnect, the ground return through the stack,
    suppressor sourcing, low-impedance faults and the area check are no longer
    tracked as open issues. Their citations in the text are dropped, or point
    to the protection section where a reference is still needed.
2026-10-29 Pre-layout: reconfiguration timer, calibration in user flash, restyled footprints
    The last commit before layout starts.
    - A SN74LVC1G17 reconfiguration timer drives PROGRAMN once the chip
    select is held low for 0.2 to 0.9 s, so a 1 s hold reloads the FPGA
    (GW-9). The FPGA now uses 31 of its 68 I/O.
    - Channel calibration is kept in the FPGA's user flash; registers are
    checked against their CRCs alongside soft-error detection. FW-6 keeps
    a board deselected for 100 ms after power-up and each reload.
    - GW-3 timing is stated from receipt of the faulty reading, with the
    general-purpose latency added to the performance table.
    - Board updated from the schematic with the restyled library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
    [e003-adc-board.kicad_pcb, e003-adc-board.kicad_sch, e003-fpga.kicad_sch, e003-gp-adc.kicad_sch, e003-gp-channel.kicad_sch, e003-gp-excitation.kicad_sch, e003-gp-front.kicad_sch, e003-gp-power.kicad_sch]
2026-10-29 Gateware: bring-up image for the LCMXO2-4000HC
    A first VHDL design to show a new board works: a register interface on
    SPI0 with an identifier, version, build hash and hello-world string; a
    SYNC_CLK frequency measurement against the internal oscillator; on
    command, the channel supply switched on, both ADS127L14s released from
    reset and their ID registers read; and raw frames to either converter so
    its SPI protocol can be pinned down on the bench.
    Pins come from U50's pad nets in the PCB. The flow is GHDL, Yosys,
    nextpnr-machxo2 and ecppack from the OSS CAD Suite, programmed through a
    J-Link on the Tag-Connect footprint with openFPGALoader, all native on
    macOS. Includes a self-checking testbe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
    [adc_ctrl.vhd, adc_model.vhd, adc_spi_master.vhd, clk_meter.vhd, e003_pkg.vhd, e003_probe.py, e003_top.vhd, host_spi_slave.vhd]
2026-10-29 Gateware: build in one container with Lattice Diamond
    Synthesis, map, place and route, timing and both outputs (.bit for SRAM,
    .jed for flash with the feature row) now come from Diamond, run in batch
    by diamond/build.tcl. Simulation stays on GHDL. Both live in a single
    linux/amd64 image built locally from the user's own Diamond RPM, which is
    never stored in a layer; the licence is mounted at run time and the
    container takes the MAC address it is locked to. Programming, waveform
    viewing and the bench probe stay native on the Mac.
    The Makefile hands `sim` and `build` to the container and runs the rest on
    the host. The build ID is generated into a VHDL package from git, with bit
    28 set for unc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
2026-10-29 Gateware container: install Diamond 3.14 from its .run installer
    Diamond 3.14 for Linux ships as a self-extracting .run rather than an
    .rpm. docker/install-diamond.sh now takes either: an .rpm is unpacked as
    before, and a .run is identified by the tool that packaged it (makeself,
    InstallBuilder, Qt Installer Framework or install4j) and run unattended
    with that tool's options. An installer it does not recognise stops the
    build with a description of the file, and `make installer-info` prints the
    same plus the installer's own --help without installing anything.
    docker/run also accepts the licence under any single .dat or .lic name and
    reports the MAC address it gives the container.
    Co-Authore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
2026-10-29 Gateware container: drive Diamond 3.14's installer with a control script
    Diamond 3.14's .run is built with a Qt Installer Framework too old for the
    unattended command-line options: it ignored them and opened its wizard,
    which waits forever without a display. The installer now gets a control
    script that clicks through the wizard, installing everything into the
    image's prefix and accepting the licence, runs with --verbose so every
    page is logged, and is stopped after 40 minutes so a page the script does
    not know about fails the build instead of hanging it.
    Claude-Session: https://claude.ai/code/session_01MLW53S3UUwVkgPUbUmmKyx
2026-10-29 Gateware container: report Diamond install progress every minute
    Build steps are not containers, so `docker stats` cannot show whether the
    installer is working. The install step now prints, once a minute, how long
    it has run, how much it has installed and the installer's CPU time; CPU
    time that stops rising means it is waiting on a page.
    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
2026-10-29 Gateware container: unpack Diamond 3.14 without running its installer
    The .run is built with Qt Installer Framework 2.0.1, which only installs
    through its GUI and sits in its event loop without a display; a control
    script cannot drive it. Its install step is no more than unpacking each
    component's 7-Zip archive into the target directory, so the image build now
    does that directly: carve-7z.py finds the archives in the installer by
    their signature, checks each start header's CRC and takes its length from
    it, and 7-Zip unpacks them. Archives that hold only QuestaSim are skipped,
    since simulation uses GHDL. The control script and progress watcher that
    served the GUI route are gone.
    Co-Authored-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
2026-10-29 Gateware container: keep the mounted Diamond licence
    Lattice's diamond_env, which the entry point sources, sets LM_LICENSE_FILE
    to Diamond's own empty license/ directory, overwriting the licence that
    docker/run mounts, so FlexLM never saw it. The entry point now restores
    the mounted value after sourcing diamond_env. The entry point and
    `make build` report a licence path that is set but not readable, and
    docker/run says when it finds no licence at all.
    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
2026-10-29 Gateware Diamond build: create the project in the build directory
    Diamond 3.14's prj_project new has no -dir option and creates the project
    in the current directory, so build.tcl now changes into the build
    directory first.
    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
2026-10-29 Gateware: first Diamond build passes; hold GSR, constrain LSE
    The first full Diamond run produced the .bit and .jed and met timing on
    the routed design (0 setup, 0 hold errors), at 1263 of 4320 LUTs. It also
    showed two things to fix:
    - LSE promoted the host chip select, the asynchronous reset of the SPI
    logic, to the global set/reset. GSR releases too slowly for the host's
    first SCLK edge at 18.75 MHz, so e003_top now instantiates GSR held
    inactive, and LSE infers none. sim/lattice_prims.vhd (formerly
    osch_sim.vhd) gives simulation a GSR alongside OSCH.
    - LSE, which does not read the LPF, assumed 200 MHz for every clock and
    reported thousands of failures. constraints/e003_top.ldc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
    [e003_top.vhd, lattice_prims.vhd]
2026-10-29 Gateware: no asynchronous reset in the host SPI logic
    The second Diamond run still merged the host chip select into the global
    set/reset: with LSE's inference stopped by the GSR instance, map did the
    same ("Using local reset signal 'host_cs_n_i_c' to infer global GSR net").
    Rather than fight the inference, the host SPI logic no longer has an
    asynchronous reset to infer from. A four-bit counter clocked by the rising
    chip select counts finished frames, and the first SCLK edge that sees the
    count change starts from the reset state. The write capture moves into the
    same process, and MISO's falling-edge flop loses its reset; it carries the
    previous frame's last bit only into the unused command by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
    [e003_top.vhd, host_spi_slave.vhd, tb_e003_top.vhd]
2026-10-30 Gateware: explain the design for engineers new to FPGAs and VHDL
    docs/gateware-explained.md walks through every source file for an
    engineer who knows embedded Rust but has never used an FPGA or read VHDL:
    a short model of synchronous logic and clock domain crossing, VHDL mapped
    onto Rust concepts, then each block bottom-up with its code inline, the
    constraint files, the testbench, and a host-side driver written against
    embedded-hal's SpiDevice.
    The code blocks are copied verbatim from the sources and link to their
    lines through permalinks pinned to the commit they describe, so the links
    stay correct as the code moves on. They quote 72 % of the VHDL; an
    appendix gives the coverage by file. T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
